nickthelegend/thenar-duck/references/18_paper_droid_with_person_scale_a.jpg

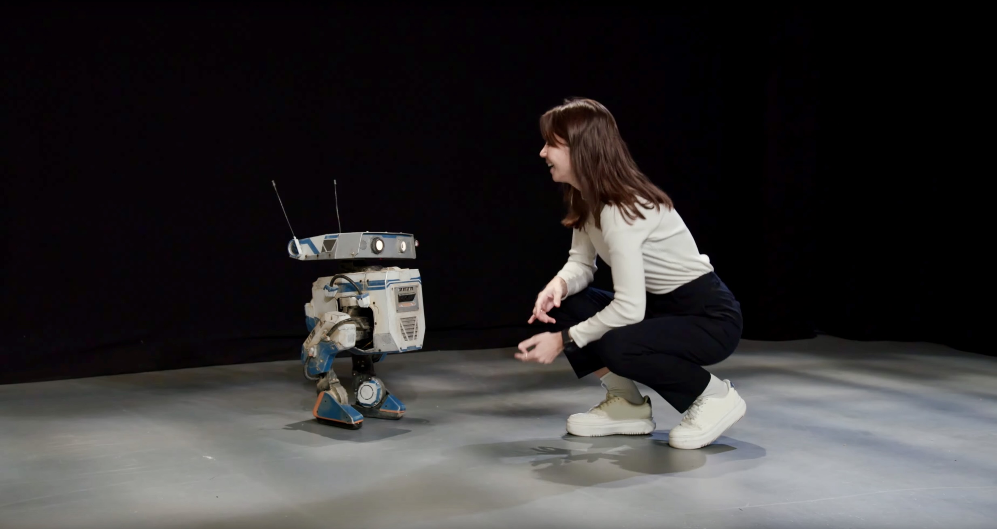
references/18_paper_droid_with_person_scale_a.jpg
