nickthelegend/thenar-duck/references/11_paper_fig2_green_droid_3quarter_photo.jpg

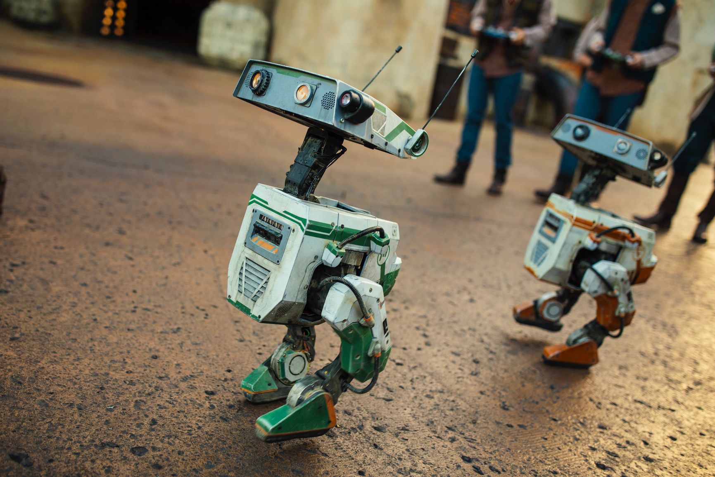
references/11_paper_fig2_green_droid_3quarter_photo.jpg
