nickthelegend/thenar-duck/cad/README.md

# Thenar Duck CAD

The current hardware-packaging revision is **[thenar_duck_B](thenar_duck_B/README.md)**.

- [Complete build guide](../README.md)
- [Colored P1S 0.4 mm Bambu Studio project](thenar_duck_B/bambu/Thenar_Duck_B_P1S_ALL_PARTS.3mf)
- [Assembly and insertion order](thenar_duck_B/ASSEMBLY.md)
- [Verification and movement restrictions](thenar_duck_B/VERIFICATION.md)
- [Hardware and custom screw/nut counts](thenar_duck_B/BOM.md)
- [Dimensional evidence](thenar_duck_B/SOURCES.md)
- [Labelled service layout](thenar_duck_B/renders/04_service_layout.png)

Revision A is preserved as the source of the retained, modified Open Duck mechanism. B replaces its enclosure and electronics packaging, corrects the battery allowance, and adds serviceable lighting and switch/fuse mounts. Use B's manifest and instructions for this build.

The model is a digital prototype based on published dimensions and stated adjustable capacities. Read the verification record before selecting parts or commanding motion; physical fitting and powered performance have not been tested.
