nickthelegend/thenar-duck/research/03_sts3215.md

# 03 — Feetech STS3215 bus servo: mechanical + electrical reference (for CAD and BOM)

Research date: 2026-09-26. Scope: the only actuator allowed in the microduck (BDX-style biped, PETG on a Bambu P1S, ≤ INR 50,000 total). Every number below carries a source URL; numbers I could not verify are marked **[unverified]** or given as my own estimate with the assumptions spelled out.

How the geometry was obtained: Waveshare publishes a DXF + PDF of the ST3215 body (Waveshare's ST3215 *is* the Feetech STS3215). I downloaded the zip, parsed the DXF `CIRCLE`/`DIMENSION` entities and rendered the PDF, and cross-checked against the outline drawing on page 6 of Feetech's own ST-3215-C001 and ST-3215-C018 datasheets.

---

## 0. TL;DR for the design team

| Item | Value | Source |
|---|---|---|
| Body (L × W × H) | 45.2 × 24.7 × 35 mm (Waveshare DXF: 45.22 × 24.72 × 35) | [Feetech C001 datasheet p.4](https://www.feetechrc.com/Data/feetechrc/upload/file/20260622/6391772523943436695270694.pdf), [Waveshare 2D drawing zip](https://files.waveshare.com/upload/0/08/ST3215-2D.zip) |
| Output-shaft axis | 10.11 mm from the gearbox end face, centred on the 24.72 width | Waveshare DXF (dimension entity `10.111704`) |
| Mounting | 8 × pilot holes Ø1.6 (mouth Ø2.0) for PA2.0 self-tapping / M2 screws, 4 on each face; 20.5 mm across; along the length at 18.41 mm from the output end on both faces, plus 2.36 mm (spline face) / 6.11 mm (idler face) from the rear end | Waveshare DXF circles; [Feetech drawing "8-PA2.0 自攻螺丝"](https://www.feetechrc.com/Data/feetechrc/upload/file/20260622/6391772523943436695270694.pdf) |
| Horn | 25T spline, OD 5.9 mm, M3×6 centre screw; Waveshare disc Ø19.2 with 4 × Ø2.5 (M3-tap) holes on a 14 mm cross (Ø14 bolt circle) | Feetech datasheet p.4; Waveshare DXF |
| Weight | 55 ± 1 g | Feetech datasheet p.4 |
| Voltage variants | C001 "7.4 V": 4–7.4 V, 19.5 kg·cm, 52 RPM, 2.5 A stall; C018 "12 V": 4–14 V, 30 kg·cm, 45 RPM, 2.7 A stall | Feetech C001 + C018 datasheets p.3 |
| Encoder / bus | 12-bit magnetic (0–4095, 0.088°), half-duplex TTL, 8N1, 38.4 k–1 Mbps (default 1 Mbps), IDs 0–253, 5264-3P connector (GND / VCC / Signal) | Feetech datasheets p.4 |
| Multi-turn | Yes: mode 3 "step" plus multi-loop ±7 turns (not retained at power-off) | Feetech datasheets p.5 |
| Indian price (in stock) | ₹1,885 ex-GST / ₹2,224.30 inc-GST (C001, Evelta, 80 in stock, ships in 24 h); ₹2,050 / ₹2,419 (C018) | [Evelta C001](https://evelta.com/sts3215-7-4v-19kg-dual-axis-ttl-string-servo-motor/), [Evelta C018](https://evelta.com/st3215-c018-12v-30kg-360deg-dual-shaft-ttl-servo-motor/) |
| 14 servos, India stock | ₹29.4 k (robu.in) – ₹31.1 k (Evelta C001) – ₹33.9 k (Evelta C018) inc-GST | computed below |
| Verdict | STS3215 everywhere is the right call: same body as STS3250/STS3235 (drop-in upgrade path), 2.3–4× stall margin on a 2 kg biped, and Open Duck Mini v2 (2.045 kg in its MuJoCo model) already walks on 14 of the 7.4 V version | §6–7 |

---

## 1. Mechanical

### 1.1 Outline (units mm)

Datasheet nominal: **45.2 × 24.7 × 35** (Feetech C001 datasheet, item 6-1, [PDF p.4](https://www.feetechrc.com/Data/feetechrc/upload/file/20260622/6391772523943436695270694.pdf)); Waveshare's CAD drawing gives **45.22 × 24.72 × 35** ([ST3215-2D.zip](https://files.waveshare.com/upload/0/08/ST3215-2D.zip), sheet titled "SCS215" — the SCS215/STS3215 share one case). The Feetech drawing (datasheet p.6) shows 45.23 × 24.73.

Height stack (Waveshare side view + Feetech front view, both p.6 / drawing):

| Feature | Value | Notes |
|---|---|---|
| Main case body (between the two flat mounting faces) | 29 | both drawings show "29" |
| + raised gear-head boss on the spline face | → 32 | Waveshare "32"; boss ≈ 3 mm high |
| + boss / rear cover on the idler face | → **35** | this is the catalogue "35" |
| Output spline protrusion above its face | 3.4 | Feetech drawing |
| Rear idler shaft protrusion below its face | 4.1 | Feetech drawing, shaft Ø6 |
| Overall spline tip → idler tip | 36.5 | Feetech drawing |
| Overall with both Waveshare aluminium discs fitted | 37.25 | Waveshare drawing |

Caveat: the two drawings don't agree exactly on how 29/32/35/36.5/37.25 nest; for the CAD reference model use the STEP file, not these numbers (see §1.6).

### 1.2 Output shaft and the raised gear-head boss

- Shaft axis is **10.11 mm from the gearbox end face** and **on the width centreline** (12.36 from each side). Waveshare DXF: dimension `10.111704` in both face views; circle centres at x = 93.796 with body edge at x = 83.684.
- The output and rear idler shafts are coaxial ("double shaft", Feetech product name "双轴"; [Feetech C001 page](https://www.feetechrc.com/74v-19-kgcm-plastic-case-metal-tooth-magnetic-code-double-axis-ttl-series-steering-gear)).
- Raised D-shaped gear-head cover around the output: DXF arcs of r = 10.80–10.89 mm centred on the shaft axis (**≈ Ø21.6–21.8 round part**), flat edge **12.5 mm behind the shaft axis** (Feetech drawing "12.5"), ≈ 3 mm high (35 − 32). A printed part that sits on the spline face needs a ≥ Ø22 pocket or must stop 12.5 mm behind the axis.
- Spline: **25T, OD 5.9 mm** (Feetech item 6-9). DXF circles at the axis: Ø6.05 and Ø6.65 (spline tip/boss) and Ø2.6 (M3 tap drill for the **M3×6 rocker screw**, Feetech item 6-13).
- Rear idler shaft: **Ø6**, held with a **PA3.0×5 self-tapping screw** (Feetech drawing callout "PA3.0X5 的自攻螺丝"); DXF shows a Ø3.2 hole at the idler axis.

### 1.3 Mounting holes (there are no side flanges/ears)

The STS3215 has **no RC-style side ears**. It mounts through **8 threaded pilot holes, 4 on the spline face ("face A") and 4 on the idler face ("face B")**, for the supplied PA2.0 self-tapping screws (Feetech drawing: "8-PA2.0 自攻螺丝"). LeRobot's SO-101 instead drives **M2×6 machine screws** into these same holes, "two from the top and two from the bottom" ([LeRobot SO-101 assembly](https://huggingface.co/docs/lerobot/en/so101)).

Coordinates from the Waveshare DXF (origin = gearbox end face × width centreline; x along the length, y across the width):

| Face | Hole pair | x from output end | y | Pilot Ø | Countersunk mouth Ø |
|---|---|---|---|---|---|
| A (spline) | near gear-head | **18.41** | **±10.25** | 1.6 | 2.0 |
| A (spline) | rear corners | **42.86** (= 2.36 from rear end) | ±10.25 | 1.6 | 2.0 |
| B (idler) | near gear-head | **18.41** | ±10.25 | 1.6 | 2.0 |
| B (idler) | rear | **39.11** (= 6.11 from rear end) | ±10.25 | 1.6 | 2.0 |

So the rectangles are **24.45 × 20.5 mm on face A** and **20.7 × 20.5 mm on face B** (DXF dimension entities `24.45`, `20.5`, `20.7`, `18.411704`, `6.111704`). The Feetech drawing independently shows the 6.11/18.41 pattern with plain holes and four cross-head case screws at the corners (Ø3.5 head recesses on face B at ≈ 3.0 mm from the output end and ≈ 2.4 mm from the rear end, 18.7 mm apart — DXF Ø3.5 circles at x = 126.984).

Interpretation caveat: the Feetech drawing labels its 6.11/18.41 view as the top view while the Waveshare DXF puts that pattern on the idler face. The DXF distinguishes the faces unambiguously (spline circles vs Ø3.2 screw hole), so I trust the DXF; **confirm on one physical unit before cutting the first mould/print**. Practical rule for CAD: the **18.41 mm pair exists on both faces** and is the safe pair; use the rear pair on whichever face you actually see the holes.

Design note for PETG: Ø1.6 pilot + PA2.0 self-tapper is Feetech's intent; for printed brackets, either drive M2×6 machine screws into the servo (SO-101 practice) or clamp the body between two printed halves and only use the horn and idler disc for load transfer (Open Duck practice — servo bodies are captured, horns bolted with M3).

### 1.4 Horn / disc options

| Option | Geometry | Source |
|---|---|---|
| Feetech stock horn | "Horn type: 25T / OD 5.9 mm", rocker screw M3×6; Evelta lists the horn material as plastic POM | Feetech datasheet items 6-9, 6-13; [Evelta](https://evelta.com/sts3215-7-4v-19kg-dual-axis-ttl-string-servo-motor/) |
| Feetech packaging photo | shows **two aluminium discs**, 8 small screws, M3 screw, 3-pin cable | Feetech C001 datasheet p.8 photo |
| Waveshare / ThinkRobotics disc | **Ø19.2 aluminium (T6061) disc**, 4 × **Ø2.5 holes (M3 tap size) on a 14 mm cross = Ø14 bolt circle**, centre M3 | Waveshare DXF (circles r = 9.6 and r = 1.25 at ±7 mm); [ThinkRobotics](https://thinkrobotics.com/products/30kg-serial-bus-servo-high-precision-and-torque-with-encoder) |
| SO-101 usage | arm links bolt to the horn with **4 × M3×6**, horn to spline with **1 × M3×6**; the idler-side horn needs no screw | [LeRobot SO-101 assembly](https://huggingface.co/docs/lerobot/en/so101) |
| Third-party brackets | RCmall aluminium U-bracket for STS3215 (Amazon), AliExpress "STS3215 Servo Bracket Metal" | [Amazon B0GVLSJ6TG](https://www.amazon.com/RCmall-Aluminum-Bracket-Feetech-Feedback/dp/B0GVLSJ6TG), [AliExpress 1005009352258061](https://www.aliexpress.com/item/1005009352258061.html) |

Whether the horn holes are tapped M3 or Ø2.5 clearance: the DXF draws Ø2.5 (M3 tap drill) and SO-101 screws M3 into them, so treat them as **M3 tapped** **[not confirmed on a physical unit]**.

### 1.5 Connector / cable exit

- Connector: **5264-3P (Molex 5264 family, 2.54 mm pitch)**, PP housing, **15 cm lead**, pins **1 GND / 2 VCC / 3 Signal-TTL** (Feetech datasheet item 6-7; Waveshare wiki "5264/2.54 3P"). Colour code on the supplied lead: black GND, red VCC, blue signal ([DFRobot](https://www.dfrobot.com/product-2961.html)).
- **Two sockets per servo** for daisy-chaining (Feetech drawing shows two "5264/2.54 3P 端子"; Waveshare wiki "two connectors per motor").
- Location: the Feetech rear-face view places the socket housings **≈ 12.5–16.5 mm behind the shaft axis** (≈ 22–26 mm from the output end) alongside a low block on the idler face that stands ≈ 1.5 mm proud between ≈ 5 and 17 mm from the rear end (Waveshare side view). The plugs come out sideways (parallel to the 24.7 mm faces). **[Exact socket position and plug clearance: verify on the STEP model / hardware — the two drawings are not explicit on this.]** Leave ≥ 10 mm side clearance for the plug + cable bend at the rear-bottom corner of each servo, or route a channel in the printed part.

### 1.6 CAD sources

- Waveshare STEP: https://files.waveshare.com/upload/5/59/ST3215-3D.zip ; 2D DXF/PDF: https://files.waveshare.com/upload/0/08/ST3215-2D.zip (linked from the [ST3215-HS wiki](https://www.waveshare.com/wiki/ST3215-HS_Servo_Motor) resources)
- GrabCAD: https://grabcad.com/library/feetech_sts3215-1 ; U-brackets: https://grabcad.com/library/u_shaped-brackets-for-feetech-sts3215-1
- step.parts: https://www.step.parts/parts/waveshare_feetech_st3215_servo
- Printables (F3Z + STEP): https://www.printables.com/model/1477431-servo-motor-sts3215-feetech-model/files
- Feetech drawings: datasheet page 6 of [C001](https://www.feetechrc.com/Data/feetechrc/upload/file/20260622/6391772523943436695270694.pdf) and [C018](https://www.feetechrc.com/Data/feetechrc/upload/file/20260622/6391772519923113075854851.pdf)

### 1.7 Materials, gears, bearings, life

| Item | STS3215 (both voltages) | Source |
|---|---|---|
| Case | PA + GF (glass-filled nylon) — some resellers wrongly say "aluminium" | Feetech datasheets item 6-3 |
| Gears | Copper (brass) per Feetech spec; Feetech C018 web page says steel; Robonine says "copper/metal" | Feetech datasheets item 6-4; [Feetech C018 page](https://www.feetechrc.com/525603); [Robonine](https://robonine.com/smart-serial-servo-motor-comparison-robotics/) |
| Gear ratio | 1/345 (C001, C018); 1/191 (C044, 27.4 kg·cm); 1/147 (C046, 14.4 kg·cm) | Feetech datasheets item 6-10; [Indystry variant table](https://indystry.cc/sts3215-best-motors-for-your-next-robot/) |
| Bearings | ball bearings on the output | Feetech item 6-5 |
| Backlash | ≤ 0.5° spec; measured ≈ 0.77–0.87° plus a 10-count dead zone | Feetech item 6-11; [Robonine test](https://robonine.com/testing-of-feetech-sts3215-servomotor-backlash-repeatability-and-torque/) |
| Repeatability (measured) | ≈ 0.17° (2 counts) | Robonine test |
| Life test | > 100,000 cycles at 1/5 stall load | Feetech item 8-1 |
| Motor | brushed "core motor" (not coreless) | Feetech item 6-14 |

---

## 2. Electrical

### 2.1 Per-variant ratings (Feetech's own datasheets)

| Parameter | STS3215 / ST-3215-C001 ("7.4 V") | ST-3215-C018 ("12 V") | ST3215-HS (Waveshare) |
|---|---|---|---|
| Input voltage range | **4–7.4 V** (over-voltage protection trips > 7.4 V, < 4 V) | **4–14 V** (protection > 14 V, < 4 V) | 6–12.6 V |
| Test voltages | 6 V / 7.4 V | 12 V | 12 V |
| Stall torque | 16.5 / **19.5 kg·cm** | **30 kg·cm** | 20 kg·cm |
| Rated (continuous) torque | 4 / **5 kg·cm** | **10 kg·cm** | not published |
| No-load speed | 0.238 / **0.192 s/60° (42 / 52 RPM)** | **0.222 s/60° (45 RPM)** | 0.094 s/60° (106 RPM) |
| No-load current | 130 / 150 mA | 180 mA | 240 mA |
| Rated current | 500 / 650 mA | 900 mA | — |
| Stall current | 2 A / **2.5 A** | **2.7 A** | 2.4 A |
| Idle (stopped) current | 6 mA | 30 mA | — |
| Motor terminal resistance | 2.5 Ω | 1.0 Ω | — |
| Kt | 8 kg·cm/A (Waveshare: 7.8) | 11 kg·cm/A | 8.3 kg·cm/A |
| Operating temp | −20…60 °C (2026 datasheet); −20…70 °C on Feetech web page | −10…60 °C | — |
| Over-temp cut-off | > 70 °C torque off | > 70 °C | — |
| Weight | 55 ± 1 g | 55 ± 1 g | 68 g (shop weight) |

Sources: [C001 datasheet](https://www.feetechrc.com/Data/feetechrc/upload/file/20260622/6391772523943436695270694.pdf) p.3–5; [C018 datasheet](https://www.feetechrc.com/Data/feetechrc/upload/file/20260622/6391772519923113075854851.pdf) p.3–5; [Waveshare ST3215 product page](https://www.waveshare.com/st3215-servo.htm) (Kt, no-load current 200 mA/150 mA for the 12 V/7.4 V models); [Waveshare ST3215-HS page](https://www.waveshare.com/st3215-hs-servo-motor.htm).

C018 performance curve (datasheet p.6, 12 V): peak output ≈ 3.4 W at ≈ 15 kg·cm / ≈ 22 RPM / ≈ 1.4 A; peak efficiency ≈ 27 % at ≈ 6 kg·cm. Useful for the actuator model in sim.

Measured (Robonine, 12 V unit): static holding ≈ 35 kg·cm on a 10 cm lever; < 1 A under 1–1.5 kg dynamic load; 48 °C steady after 10 min holding 15 kg·cm; 60 °C after 50 min and 71 °C (overheat) after ~110 min of ±90° oscillation, with **no automatic thermal cut-off observed** ([Robonine](https://robonine.com/testing-of-feetech-sts3215-servomotor-backlash-repeatability-and-torque/)). Plan for thermal headroom in the knees.

**Battery warning.** The C001's datasheet range is 4–7.4 V, yet Open Duck Mini v2 runs it straight from a 2S Li-ion pack (Molicel P30B ×2, up to 8.4 V full) ([Open Duck BOM](https://orobot.io/o/program/BROKER-2/open-duck-mini)); Waveshare lists the 7.4 V model as "4–7.4 V" and OpenElab as "4–7.4 V" ([OpenElab](https://openelab.com/products/feetech-sts3215-c001-servo-7)). The over-voltage protection thresholds live in EEPROM registers 14/15 (max/min voltage, 0.1 V units — [register reference](https://github.com/commanderfun/STS3215/blob/main/REGISTER_REFERENCE.md)), so check the shipped default on your units. Cleaner options: (a) C018 on 3S (11.1 V nominal, 12.6 V full, inside 4–14 V) — this is what Waveshare/ThinkRobotics sell as the standard "12 V" model; (b) C001 on 2S behind a 7.2 V buck (Waveshare "DC Buck Adapter 7.2V", ₹334 ex-GST at [ElectronicsComp](https://www.electronicscomp.com/waveshare-serial-bus-servo-dc-buck-adapter-mini-module-design-for-serial-bus-servos-easy-to-use-72v-buck-regulator), current rating not published — **unverified for 14 servos**).

### 2.2 Encoder, resolution, feedback

- 12-bit magnetic angle sensor, 360° absolute, no mechanical limit, resolution 0.088° (360/4096), neutral 180° = 2048 (Feetech items 6-6, 7-6…7-8).
- Feedback fields: position, speed, load, input voltage, current, temperature (item 7-10). Present current register scale = 6.5 mA/LSB ([register reference](https://github.com/commanderfun/STS3215/blob/main/REGISTER_REFERENCE.md)).
- Max position update rate **1 ms** (item 11 "Max Position Update Rate 1ms").

### 2.3 Protocol, bus, connector, pinout

- **Half-duplex asynchronous TTL serial, 8 data bits, 1 stop, no parity**, "digital packet" commands (Feetech items 7-1/7-2). Same framing as Dynamixel Protocol 1.0 (0xFF 0xFF header, ID, length, instruction, params, checksum); STS/SMS send **low byte first** (Feetech FAQ item 11: "SCS series high byte first, SMS low byte first"; Waveshare demo `protocol_end = 0` for ST) — [Feetech start tutorial PDF](https://www.feetechrc.com/Data/feetechrc/upload/file/20201127/start%20%20tutorial201015.pdf), [Waveshare user manual](https://files.waveshare.com/upload/f/f4/ST3215_Servo_User_Manual.pdf) p.25. Full spec: [Communication Protocol User Manual (191218)](https://files.waveshare.com/upload/2/27/Communication_Protocol_User_Manual-EN%28191218-0923%29.pdf).
- Signal levels: high 2–5 V, low 0–0.45 V (Feetech item 11) → 3.3 V hosts are fine.
- Baud: 38,400 – 1,000,000 bps, factory 1 Mbps (item 7-4). Baud register codes 0…7 = 1 M, 500 k, 250 k, 128 k, 115200, 76800, 57600, 38400 ([Feetech tutorial p.4](https://www.feetechrc.com/Data/feetechrc/upload/file/20201127/start%20%20tutorial201015.pdf)). (LeRobot's table lists 19200 instead of 76800 for the last code — [tables.py](https://github.com/huggingface/lerobot/blob/main/src/lerobot/motors/feetech/tables.py); trust Feetech.)
- IDs 0–253 (254 = broadcast); Waveshare: "up to 253 servos in series (with sufficient power)" ([Waveshare wiki](https://www.waveshare.com/wiki/ST3215_Servo)). Practical chains: 6 per adapter in SO-101, 14 in Open Duck Mini v2.
- Connector **5264-3P**, pin 1 GND, 2 VCC, 3 Signal (item 6-7). Two sockets per servo, wired in parallel internally → straight daisy chain, no termination.
- Bus throughput (my estimate, 1 Mbps ≈ 100 kB/s): one sync-write of position+time+speed for 14 servos ≈ 106 bytes ≈ 1.1 ms; 14 individual position/speed/load reads ≈ 20–25 bytes each incl. response ≈ 0.25–0.4 ms each with servo latency → ≈ 5–8 ms → a 50–100 Hz control loop is comfortable on one chain.

### 2.4 Key registers (torque limit, angle limits, mode)

Official tables: [Waveshare ST3215 memory register map (XLS)](https://files.waveshare.com/upload/2/27/ST3215%20memory%20register%20map-EN.xls) and the SMS/STS 1.0 memory table referenced in the [Feetech tutorial](https://www.feetechrc.com/Data/feetechrc/upload/file/20201127/start%20%20tutorial201015.pdf). Community transcription used below: [commanderfun REGISTER_REFERENCE.md](https://github.com/commanderfun/STS3215/blob/main/REGISTER_REFERENCE.md), cross-checked with [LeRobot tables.py](https://github.com/huggingface/lerobot/blob/main/src/lerobot/motors/feetech/tables.py).

| Addr | Name | Mem | Default | Notes |
|---|---|---|---|---|
| 5 | ID | EEPROM | 1 | 0–253 |
| 6 | Baud code | EEPROM | 0 (1 Mbps) | codes above |
| 9 / 11 | Min / Max angle limit | EEPROM | 0 / 4095 | set both 0 for wheel/step modes |
| 13 | Max temperature | EEPROM | 70 °C | |
| 14 / 15 | Max / Min voltage | EEPROM | 140 / 50 (×0.1 V) | check on 7.4 V units |
| 16 | **Max torque limit** | EEPROM | 1000 (=100 %) | copied to 48 at power-up |
| 21 / 22 / 23 | P / D / I | EEPROM | — | PID exposed (Feetech item 7-5) |
| 33 | **Operating mode** | EEPROM | 0 | 0 position, 1 closed-loop speed, 2 open-loop PWM, 3 step (multi-turn) |
| 34–39 | overload protection torque / time / threshold | EEPROM | — | Feetech FAQ items 1–2 |
| 40 | Torque enable | RAM | 0 | writing **128** = "set current position as centre" one-key calibration (Feetech item 7-14) |
| 41 | Acceleration | RAM | 0 | 0 = instant |
| 42 | Goal position | RAM | — | 0–4095 (step mode: signed, relative) |
| 46 | Goal speed | RAM | 0 = max | steps/s; STS3215 max ≈ 3400 steps/s ([sts_hardware_interface](https://github.com/adityakamath/sts_hardware_interface)) |
| 48 | **Torque limit (runtime)** | RAM | 1000 | 0–1000 = 0–100 % of stall |
| 56 / 58 / 60 | Present position / speed / load | RAM | — | load bit 10 = direction |
| 62 / 63 / 69 | Voltage (×0.1 V) / temperature (°C) / current (×6.5 mA) | RAM | — | |

Protections (Feetech item 7-11): overload = > 80 % of stall for 2 s → protect (flag cleared by the next position command; percentage and time configurable); over-current = > 2 A for 2 s → output off; over-voltage/under-voltage per registers 14/15; over-temperature > 70 °C → torque off.

### 2.5 360° / multi-turn

Yes. Feetech item 7-12/7-13: mode 3 = step mode (relative moves from the current position; set angle limits to 0 first — [Feetech FAQ item 13](https://www.feetechrc.com/Data/feetechrc/upload/file/20201127/start%20%20tutorial201015.pdf)); **multi-loop mode gives ±7 turns of absolute position at full resolution, turn count not retained at power-off, doubling turns when resolution is halved** (address 30 "angle resolution", Feetech tutorial p.5). Not needed for a leg joint, but handy for a neck/antenna or a winch.

---

## 3. Driver / interface options

| Board | What it is | Electrical | Host interface | Price |
|---|---|---|---|---|
| **Waveshare Bus Servo Adapter (A)** (a.k.a. "Serial Bus Servo Driver Board", the LeRobot "MotorBus") | CH343P USB-UART + SN74LVC1G126/1G125 tri-state buffers + MMBT3906 auto-direction, DATA pulled up 10 k to 3.3 V, AO4407 P-FET reverse-polarity + SMAJ15CA TVS on the servo rail, 5 V buck → AMS1117-3.3 | input 9–12.6 V (DC 5.5×2.1 or KF350 screw terminal); **servo power path marked "MAX: 6 A"** on the schematic | USB-C (jumpers "B") or 3-pin UART header (jumpers "A"; wire **RX↔RX, TX↔TX** because the header is labelled from the servo side) | $4.99 ([Waveshare](https://www.waveshare.com/bus-servo-adapter-a.htm)); India: ₹789 in stock ([REES52](https://rees52.com/products/waveshare-serial-bus-servo-driver-board-all-in-one-servo-driver-board-with-integrated-power-control-for-st-sc-actuators-rs8478)), ₹474 sold-out ([Robocraze](https://robocraze.com/products/waveshare-serial-bus-servo-control-board-for-st-sc-series-servos)), listed at [robu.in](https://robu.in/product/waveshare-serial-bus-servo-driver-board-integrates-servo-power-supply-and-control-circuit-applicable-for-st-sc-series-serial-bus-servos/) and [Amazon.in B0CJ6TP3TP](https://www.amazon.in/Waveshare-Integrates-Control-Applicable-Integrate/dp/B0CJ6TP3TP) (prices not retrievable, 503) |
| **SmartElex Bus Servo Adapter** (robu.in house brand, functional clone) | same feature set: 9–12.6 V, UART/USB jumper A/B, 42×33 mm, Ø2.5 holes, 253 servos | | UART or USB | ₹452 sale / ₹604 ([Robocraze](https://robocraze.com/products/smartelex-serial-bus-servo-driver-board-integrates-servo-power-supply-and-control-circuit)); [robu.in listing](https://robu.in/product/smartelex-serial-bus-servo-driver-board/); [datasheet PDF](https://robu.in/wp-content/uploads/2025/07/Bus_Servo_Adapter-2.pdf) |
| **Waveshare Servo Driver with ESP32** | ESP32-WROOM-32, OLED, WiFi/BT/ESP-NOW, web UI on 192.168.4.1; servo UART on GPIO18 RX / GPIO19 TX at 1 Mbps; USB-C serial forwarding at 115200 | DC 6–12 V, 65×30 mm, holes 23×58 | web app, USB serial passthrough, ESP-NOW | $15.99 ([Waveshare](https://www.waveshare.com/servo-driver-with-esp32.htm)); **₹1,250 ex / ₹1,475 inc GST, 9 in stock** ([Evelta](https://evelta.com/esp32-servo-driver-expansion-board/)) |
| **Waveshare Bus Servo Driver HAT (A)** | ESP32-WROOM-32 HAT for Raspberry Pi; TTL + RS485 ports; 5 V buck can power the Pi | 9–25 V in, 65×57 mm | Pi GPIO UART or USB-C | $17.97–18.99 ([Waveshare](https://www.waveshare.com/bus-servo-driver-hat-a.htm)); no Indian listing found |
| **Feetech FE-URT-1 / FE-URT-2** | USB (CH340 per Feetech tutorial) → TTL (port B, SCS/STS) and RS485 (port A, SMS); 50 bps–1 Mbps; 5 V / 3.3 V levels; **signal only, servo power must be supplied separately** | | USB or TTL header to an MCU (TX-TX, RX-RX, 5V, GND) | $10 ([Seeed](https://www.seeedstudio.com/Feetech-FE-URT-1-p-6705.html)); FE-URT-2 ₹1,137.46, 5 in stock ([Evelta Feetech list](https://evelta.com/feetech/)) |

Where the electronics are described: [Bus Servo Adapter (A) wiki](https://www.waveshare.com/wiki/Bus_Servo_Adapter_(A)) and [schematic PDF](https://files.waveshare.com/wiki/Bus-Servo-Adapter-(A)/Bus%20Servo%20Adapter%20(A)-Sch.pdf); [Servo Driver with ESP32 wiki](https://www.waveshare.com/wiki/Servo_Driver_with_ESP32); [Bus Servo Driver HAT (A) wiki](https://www.waveshare.com/wiki/Bus_Servo_Driver_HAT_(A)); FE-URT-1 description on [RobotShop search summary / Feetech tutorial](https://www.feetechrc.com/Data/feetechrc/upload/file/20201127/start%20%20tutorial201015.pdf).

**Can a Raspberry Pi UART drive them directly?** Yes, with a tri-state buffer. Feetech's own reference circuit (datasheet p.8 "接口定义") is: SN74LVC1G126 from host TXD to the DATA line with OE = TXEN; SN74LVC1G125 from DATA to host RXD with /OE = TXEN; a PNP transistor (10 k base, 20 k pull-down) derives TXEN from TXD so no GPIO direction control is needed; VCC = the host's logic level (3.3 V is fine, signal high spec 2–5 V). The Waveshare adapter is exactly this circuit plus a CH343P, so the cheapest robust route is the ₹450–800 adapter in UART mode wired to the Pi's GPIO14/15 UART ([pinout.xyz](https://pinout.xyz/pinout/uart)). Alternatives seen in the wild: STM32 single-wire half-duplex mode with a 500–1000 Ω pull-up ([viteo STM32 port](https://github.com/viteo/STM32-BluePill-SCServo-library)); RP2040 + Waveshare Pico driver board ([kevinmcaleer/sts3215](https://github.com/kevinmcaleer/sts3215)). Open Duck Mini v2 itself uses the Waveshare adapter **over USB** on the Pi Zero 2W with the FTDI/CH34x latency timer tuned ([Open Duck Mini Runtime, DeepWiki](https://deepwiki.com/apirrone/Open_Duck_Mini_Runtime)).

**Power note for 14 servos:** the adapter's servo rail is marked 6 A max (schematic). 14 × 150 mA no-load = 2.1 A idle; stall on two knees alone = 5 A. Feed the servo chain(s) from the battery with your own XT30 harness (Open Duck BOM uses XT30) and pass only DATA/GND through the adapter, or split into two chains each under 6 A.

### 3.1 Software

Python:
- `pip install feetech-servo-sdk` → `import scservo_sdk` (PortHandler, sms_sts, WritePosEx/ReadPos; mirror of Feetech's gitee `ftservo/SCServoSDK`) — [PyPI](https://pypi.org/project/feetech-servo-sdk/), [gitee original](https://gitee.com/ftservo/SCServoSDK)
- `ftservo-python-sdk` (official source, `scscl` + `sms_sts` examples) — [PyPI](https://pypi.org/project/ftservo-python-sdk/)
- Waveshare `STServo_Python.zip` (pyserial only) — [download](https://files.waveshare.com/wiki/Bus_Servo_Adapter_A/STServo_Python.zip)
- `vassar-feetech-servo-sdk` (beginner wrapper, bundles scservo_sdk) — [PyPI](https://pypi.org/project/vassar-feetech-servo-sdk/); `feetech-cli` (inspect/configure) — [PyPI](https://pypi.org/project/feetech-cli/0.1.0/); `python-st3215` — [GitHub](https://github.com/Mickael-Roger/python-st3215)
- **LeRobot**: `pip install "lerobot[feetech]"`, class `lerobot.motors.feetech.FeetechMotorsBus` (default 1 Mbps, 1000 ms timeout, protocol 0 for STS with sync read/write, homing-offset calibration; model table has `sts3215`, `sts3250`, `sm8512bl`, `scs0009`; `lerobot-find-port`, `lerobot-setup-motors`, `lerobot-calibrate`) — [feetech.py](https://github.com/huggingface/lerobot/blob/main/src/lerobot/motors/feetech/feetech.py), [tables.py](https://github.com/huggingface/lerobot/blob/main/src/lerobot/motors/feetech/tables.py), [SO-101 docs](https://huggingface.co/docs/lerobot/en/so101)
- Tutorial + register map: [commanderfun/STS3215](https://github.com/commanderfun/STS3215)

Rust / MCU: `rustypot` (what Open Duck Mini Runtime uses on the Pi Zero 2W) — [DeepWiki](https://deepwiki.com/apirrone/Open_Duck_Mini_Runtime); Arduino `SCServo` library from Waveshare ([wiki](https://www.waveshare.com/wiki/Bus_Servo_Adapter_(A))) and [DeltaEngine/FeetechStsServos](https://github.com/DeltaEngine/FeetechStsServos); [esphome-sts3215](https://github.com/DexiTheOne/esphome-sts3215); [MicroPython for RP2040](https://github.com/kevinmcaleer/sts3215).

ROS 2:
- [adityakamath/sts_hardware_interface](https://github.com/adityakamath/sts_hardware_interface) — ros2_control SystemInterface, CI on Jazzy + Kilted, position / velocity / PWM-effort command modes, 7 state interfaces (position, velocity, effort, voltage, temperature, current, is_moving), vendored SCServo_Linux, notes STS3215/3235 max 3400 steps/s.
- [JafarAbdi/feetech_ros2_driver](https://github.com/JafarAbdi/feetech_ros2_driver) (also [ros-physical-ai fork](https://github.com/ros-physical-ai/feetech_ros2_driver); indexed at [index.ros.org](https://index.ros.org/p/feetech_ros2_driver/)) — ros2_control hardware interface.
- [Ar-Ray-code/feetech_scs_ros2_driver](https://github.com/Ar-Ray-code/feetech_scs_ros2_driver); [adityakamath/pan_tilt_ros](https://github.com/adityakamath/pan_tilt_ros) (no ros2_control); [botamochi6277/Feetech-microros](https://github.com/botamochi6277/Feetech-microros) (XIAO + FE-URT-1).

Simulation actuator model: BAM (Rhoban) ships an identified `feetech_sts3215_7_4V` model with a MuJoCo exporter ([BAM actuators list](https://bam.readthedocs.io/en/latest/usage/actuators.html), [repo](https://github.com/Rhoban/bam)); Open Duck Mini v2's MJCF uses actuator class `sts3215` with kp = 13.37, kv = 0, forcerange ±3.23 (units as in the XML; that would be 33 kg·cm, above the 7.4 V stall — **[verify against the BAM parameters before trusting it]**) — [open_duck_mini_v2.xml](https://raw.githubusercontent.com/apirrone/Open_Duck_Playground/main/playground/open_duck_mini_v2/xmls/open_duck_mini_v2.xml), [sim2real.md](https://github.com/apirrone/Open_Duck_Mini/blob/v2/docs/sim2real.md).

---

## 4. Prices (INR) and sourcing for 14–16 servos

Fetched 2026-09-26. FX for USD lines: **1 USD = ₹95.92** ([open.er-api.com, 26 Sep 2026](https://open.er-api.com/v6/latest/USD)).

### 4.1 Indian vendors

| Vendor / SKU | Price | Stock / lead time | Source |
|---|---|---|---|
| Evelta — STS3215 7.4 V (C001) | **₹1,885 ex-GST / ₹2,224.30 inc** | 80 in stock, "shipped in 24 h from Mumbai" | [evelta.com](https://evelta.com/sts3215-7-4v-19kg-dual-axis-ttl-string-servo-motor/) |
| Evelta — ST3215-C018 12 V | **₹2,050 ex / ₹2,419 inc** | 67 in stock, 24 h | [evelta.com](https://evelta.com/st3215-c018-12v-30kg-360deg-dual-shaft-ttl-servo-motor/) |
| Evelta — STS3215-C046 (1:147, 14 kg·cm) | ₹1,885 ex | 60 in stock | [Evelta Feetech list](https://evelta.com/feetech/) |
| Evelta — STS3032 | ₹2,925.13 ex / ₹3,451.65 inc | product page "out of stock", category page "15 in stock" (inconsistent) | [evelta.com](https://evelta.com/sts3032-6v-4-5kg-360deg-serial-bus-servo-motor/) |
| Evelta — ST-3250-C002 (50 kg·cm) | ₹5,154.42 ex | 5 in stock | [Evelta Feetech list](https://evelta.com/feetech/) |
| Evelta — STS3035 (12 V 35 kg·cm) / STS3020 (7.4 V 20 kg·cm) | ₹2,072.85 / ₹2,056.55 ex | 5 each | same |
| robu.in — Waveshare ST3215 (30 kg·cm) | **₹2,097 inc-GST** (search snippet; page returns 403 to fetch) | unknown | [robu.in](https://robu.in/product/waveshare-st3215-serial-bus-servo/) |
| ThinkRobotics — Waveshare ST3215 (12 V or 7.4 V option) | ₹2,649.99 (was ₹2,999.99) | "available in 2–4 weeks" | [thinkrobotics.com](https://thinkrobotics.com/products/30kg-serial-bus-servo-high-precision-and-torque-with-encoder) |
| ThinkRobotics — ST3215-HS | ₹2,699.99 (was ₹2,999.99) | 2–4 weeks | [thinkrobotics.com](https://thinkrobotics.com/products/st3215-hs) |
| Amazon.in — DIYmall STS3215 7.4 V (B0FGNZYNKC, B0FGNG181T w/ bracket), Rcmall 6-pack 12 V (B0FLPQQ4FR), Waveshare (B0B6P9271Q) | listings exist; **prices not retrievable (HTTP 503 on four attempts)** | | [B0FGNZYNKC](https://www.amazon.in/DIYmall-STS3215-Magnetic-Encoder-Arduino/dp/B0FGNZYNKC), [B0FLPQQ4FR](https://www.amazon.in/Robotics-Magnetic-Precision-Educational-Projects/dp/B0FLPQQ4FR) |
| electronicscomp.com | **no STS3215/ST3215 listing** ("no product matches") | | [search](https://www.electronicscomp.com/index.php?route=product/search&search=ST3215) |
| roboelements | domain did not resolve (ENOTFOUND) at research time | | — |

### 4.2 Overseas list prices (for the import comparison)

| Seller | Price | Source |
|---|---|---|
| Feetech official "overseas price" (2020) | $15 | [feetechrc.com](https://www.feetechrc.com/2020-05-13_56655.html) |
| Alibaba (Feetech STS3215 C001, MOQ tiers) | from $13.89 | [alibaba.com](https://www.alibaba.com/product-detail/Top-Seller-Low-Cost-Feetech-STS3215_1600999461525.html) (search snippet; page blocks fetch) |
| AliExpress 6-pack | $134.80 (= $22.47 ea) | [aliexpress.us 3256809204674483](https://www.aliexpress.us/item/3256809204674483.html) (snippet) |
| Waveshare direct | $16.99–21.99 | [waveshare.com](https://www.waveshare.com/st3215-servo.htm) |
| DFRobot | $17.90 (7.4 V), $19.90 (12 V) | [2961](https://www.dfrobot.com/product-2961.html), [2962](https://www.dfrobot.com/product-2962.html) |
| Seeed | $20 ($19 at 10+) | [seeedstudio.com](https://www.seeedstudio.com/STS3215-19kg-cm-7-4V-Serial-Servo-p-6338.html) |
| OpenElab | $23.99 | [openelab.com](https://openelab.com/products/feetech-sts3215-c001-servo-7) |
| Open Duck Mini v2 BOM | $23 each × 14 = $318 | [orobot.io BOM mirror](https://orobot.io/o/program/BROKER-2/open-duck-mini) |

### 4.3 Import duty to India (courier / e-commerce parcel)

Stack, per [taxgst.in](https://taxgst.in/import-duty-calculator-india/): assessable value (CIF) → BCD → **SWS = 10 % of BCD** → **IGST 18 %** on (CIF + BCD + SWS). BCD for small DC motors (HS 8501.10.19) is quoted as **15 %** by [EximPe](https://eximpe.com/hsn/electric-motor-hsn-code) (their indicative total incl. an AIDC line: ₹40.39 per ₹100 CIF) and as "10–15 % for 85xx electronics" by [Alibaba's India shipping guide](https://electronics.alibaba.com/question/aliexpress-in-india-shipping,-safety-workarounds-(2025)). Arithmetic: BCD 10 % → total 31.0 % of CIF; BCD 15 % → 37.5 %; with the AIDC line EximPe shows → 40.4 %. **Budget 31–41 % of CIF plus the courier's clearance fee [fee amount unverified].** Practical constraints: the AliExpress app is delisted in India (site still usable), delivery 14–60 days, and 68–94 % customs-clearance rates depending on channel (same Alibaba guide).

### 4.4 Landed cost per servo, import vs domestic (my arithmetic)

| Route | Unit | + shipping share (assume ₹200) | Duty 31–41 % | **Landed** |
|---|---|---|---|---|
| Alibaba wholesale $13.89 | ₹1,332 | ₹1,532 | ₹475–628 | **₹2,007–2,160** |
| AliExpress 6-pack $22.47 | ₹2,155 | ₹2,355 | ₹730–966 | **₹3,085–3,321** |
| Evelta C001 (GST paid, 24 h) | — | — | — | **₹2,224** |
| robu.in Waveshare ST3215 | — | — | — | **₹2,097** |

Conclusion: importing only wins at true wholesale (~$14) and only by ~₹100–200 per servo, while costing 3–8 weeks and customs risk. **Buy Indian stock.**

### 4.5 Servo budget for the microduck

| Quantity | Evelta C001 (₹2,224.30) | Evelta C018 12 V (₹2,419) | robu.in ST3215 (₹2,097) | ThinkRobotics (₹2,649.99) |
|---|---|---|---|---|
| 14 (Open Duck Mini v2 count) | **₹31,140** | ₹33,866 | ₹29,358 | ₹37,100 |
| 16 (+2 spare / extra DOF) | ₹35,589 | ₹38,704 | ₹33,552 | ₹42,400 |

Add: adapter ₹450–800, Waveshare/Feetech horn screws included, 3-pin leads included (15 cm each — long leg runs need longer 5264 leads). That leaves roughly ₹12–19 k of the ₹50 k for Pi Zero 2W, IMU (BNO055 in Open Duck), 2S/3S pack + BMS + charger, PETG and hardware — tight but feasible at the 14-servo count.

---

## 5. Comparison: STS3215 vs STS3250 vs STS3032 vs ST3215-HS (and STS3235)

| | **STS3215 C001 (7.4 V)** | **STS3215 C018 (12 V)** | **STS3250 (ST-3250-C001)** | **STS3032** | **ST3215-HS** | STS3235 |
|---|---|---|---|---|---|---|
| Body | 45.2 × 24.7 × 35, PA+GF | same | **45.22 × 24.72 × 35, aluminium** (drop-in) | 23.2 × 12.1 × 28.5, aluminium | 45.22 × 35 × 24.72 | 45.22 body, aluminium |
| Weight | 55 g | 55 g | 74.5 g | 20 g | 68 g (shop weight) | 70.5 g |
| Voltage | 4–7.4 V | 4–14 V | 6–12 V (rated 12) | 4.8–6 V | 6–12.6 V | 12 V |
| Stall torque | 19.5 kg·cm | 30 | **50** | 4.5 | 20 | 30 |
| Rated torque | 5 | 10 | 16 | 1.5 | n/p | 10 |
| No-load speed | 52 RPM (0.192 s/60°) | 45 RPM (0.222) | 75 RPM (0.133) | 111 RPM (0.09) | **106 RPM (0.094)** | 45 RPM |
| Stall current | 2.5 A | 2.7 A | 4.2 A | 1.2 A | 2.4 A | 2.7 A |
| No-load current | 150 mA | 180 mA | 280 mA | 150 mA | 240 mA | — |
| Gears | copper | copper/steel | steel | metal | metal | steel |
| Motor | brushed core | brushed core | coreless | coreless | — | — |
| Gear ratio | 1/345 | 1/345 | n/p | n/p | n/p | n/p |
| Backlash measured (Robonine, 50 % load) | 0.77° (12 V unit) | 0.77° | 0.28° | — | — | 0.44° |
| Temp rise @50 % load (Robonine) | +10 °C | +10 °C | +25 °C | — | — | +5 °C |
| Price, India | ₹2,224 inc (Evelta) | ₹2,419 inc (Evelta) | ₹5,154 ex (Evelta, C002) ≈ ₹6,082 inc | ₹3,452 inc (Evelta) | ₹2,700 (ThinkRobotics) | robu.in listing, price not captured |
| Price, overseas | $15–24 | $17–22 | $64.99 (Babsco) | — | $21.99 (Waveshare) | — |
| 14 × India price | ₹31.1 k | ₹33.9 k | ≈ ₹85 k | ≈ ₹48 k | ≈ ₹37.8 k | — |

Sources: STS3215 — Feetech datasheets (§2); STS3250 — [Feetech ST-3250-C001 page](https://www.feetechrc.com/562636), [Babsco](https://shop.babsco.com/feetech-sts3250-50kg-heavy-duty-smart-servo); STS3032 — [Evelta](https://evelta.com/sts3032-6v-4-5kg-360deg-serial-bus-servo-motor/), [Feetech STS3032 page](https://www.feetechrc.com/568388.html); ST3215-HS — [Waveshare](https://www.waveshare.com/st3215-hs-servo-motor.htm), [ThinkRobotics](https://thinkrobotics.com/products/st3215-hs); STS3235 and measured columns — [Robonine comparison](https://robonine.com/smart-serial-servo-motor-comparison-robotics/). "n/p" = not published.

### 5.1 Torque margin for a ~1.5–2 kg biped (my estimate; assumptions explicit)

Reference mass: Open Duck Mini v2's MJCF sums to **2.045 kg** (trunk 0.699, head 0.407, each leg ≈ 0.41) and it walks on **14 × STS3215 7.4 V** ([open_duck_mini_v2.xml](https://raw.githubusercontent.com/apirrone/Open_Duck_Playground/main/playground/open_duck_mini_v2/xmls/open_duck_mini_v2.xml), [BOM](https://orobot.io/o/program/BROKER-2/open-duck-mini)). Weight W = 2.045 × 9.81 = 20.1 N. Static single-support worst cases (1 kg·cm = 0.0981 N·m):

| Joint | Assumed lever arm (CoM offset from joint axis) | Static torque | vs C001 stall 19.5 / rated 5 | vs C018 stall 30 / rated 10 |
|---|---|---|---|---|
| Ankle pitch (CoM at toe edge) | 40 mm | 0.80 N·m = 8.2 kg·cm | 2.4× / 0.61× | 3.7× / 1.2× |
| Knee (30–40° bend) | 35 mm | 0.70 N·m = 7.2 kg·cm | 2.7× / 0.70× | 4.2× / 1.4× |
| Hip roll (lateral sway) | 45 mm | 0.90 N·m = 9.2 kg·cm | 2.1× / 0.54× | 3.3× / 1.1× |

Reading: the 7.4 V unit has 2–2.7× stall margin (adequate, proven by Open Duck) but runs at 1.6–1.8× its **continuous** rating in the worst pose, which is why leg servos get warm; the 12 V C018 on 3S restores ≥ 1.1× continuous margin at identical size, weight and price (+₹195 each). STS3250 would give 5–6× stall margin but costs 2.7× and adds 20 g per joint (0.27 kg over 14 joints) — unnecessary for a 2 kg robot. STS3032 (4.5 kg·cm stall, 1.5 rated) is only viable for the head/neck/antenna joints, and it is *more* expensive in India than the STS3215. ST3215-HS trades 33 % torque for 2.4× speed; at Open Duck scale the 45–52 RPM (270–312 °/s no-load) of the STS3215 is proven sufficient, so HS is optional for a faster gait later. **Decision: STS3215 everywhere; choose C018 @ 3S unless you want to reuse the Open Duck electronics verbatim (C001 @ 2S).**

---

## 6. CAD/BOM checklist derived from this research

1. Model the servo from the Waveshare STEP; use the DXF numbers here only for sanity checks.
2. Mount = capture the body between printed halves; bolt loads through the horn (4 × M3 on Ø14 cross + M3×6 centre) and the idler disc; M2×6 into the 18.41 mm hole pair on each face as anti-rotation.
3. Reserve Ø22 × 3 mm for the gear-head boss, 3.4 mm spline stand-off, 4.1 mm idler stand-off, and ≥ 10 mm sideways at the rear-bottom corner for the 5264 plugs.
4. Two power chains ≤ 6 A each if the Waveshare adapter carries servo power; otherwise power via XT30 harness.
5. Set register 16/48 (torque limit) and 34–39 (overload) per joint; set 14/15 to the pack's real min/max before the first walk.
6. Order 14 + 2 spares from Evelta (24 h) and one SmartElex/Waveshare adapter from robu/Robocraze/REES52.

---

## 7. Open questions (could not be verified online)

- Exact socket/plug location on the body (side faces vs idler face) — measure a unit or inspect the STEP.
- Whether the aluminium disc's four holes are M3-tapped or Ø2.5 clearance (DXF suggests tap-drill size; SO-101 screws M3 into them).
- Face-A rear hole pair at 2.36 mm from the rear end: usable for mounting or just the case-screw posts?
- Shipped default of the max-voltage register on 7.4 V units (2S full charge = 8.4 V > 7.4 V spec).
- ST3215-HS gear ratio and its true weight (68 g is the shop listing weight).
- Amazon.in and robu.in live prices (503/403 during research); ThinkRobotics 2–4-week lead time vs Evelta 24 h.
- Exact BCD rate for HS 8501.10.19 today (10 % vs 15 %) and whether AIDC applies; courier clearance fee.
- BAM's identified STS3215 7.4 V parameters (kp, friction, armature) — fetch from the BAM GitHub params folder before building the MuJoCo/Isaac actuator model.

---

## 8. All sources

Feetech: [C001 product page](https://www.feetechrc.com/74v-19-kgcm-plastic-case-metal-tooth-magnetic-code-double-axis-ttl-series-steering-gear) · [C001 datasheet PDF](https://www.feetechrc.com/Data/feetechrc/upload/file/20260622/6391772523943436695270694.pdf) · [2020 STS3215 spec PDF](https://www.feetechrc.com/Data/feetechrc/upload/file/20200611/6372749961523760249976542.pdf) · [C018 product page](https://www.feetechrc.com/525603) · [C018 datasheet PDF](https://www.feetechrc.com/Data/feetechrc/upload/file/20260622/6391772519923113075854851.pdf) · [STS3215 variants search](https://www.feetechrc.com/products.html?keyword=STS3215) · [2020 launch page](https://www.feetechrc.com/2020-05-13_56655.html) · [STS3250 page](https://www.feetechrc.com/562636) · [STS3032 page](https://www.feetechrc.com/568388.html) · [Start tutorial / FAQ PDF](https://www.feetechrc.com/Data/feetechrc/upload/file/20201127/start%20%20tutorial201015.pdf)

Waveshare: [ST3215 wiki](https://www.waveshare.com/wiki/ST3215_Servo) · [ST3215 product](https://www.waveshare.com/st3215-servo.htm) · [2D drawing zip](https://files.waveshare.com/upload/0/08/ST3215-2D.zip) · [3D STEP zip](https://files.waveshare.com/upload/5/59/ST3215-3D.zip) · [register map XLS](https://files.waveshare.com/upload/2/27/ST3215%20memory%20register%20map-EN.xls) · [protocol manual](https://files.waveshare.com/upload/2/27/Communication_Protocol_User_Manual-EN%28191218-0923%29.pdf) · [ST3215 user manual](https://files.waveshare.com/upload/f/f4/ST3215_Servo_User_Manual.pdf) · [ST3215-HS wiki](https://www.waveshare.com/wiki/ST3215-HS_Servo_Motor) · [ST3215-HS product](https://www.waveshare.com/st3215-hs-servo-motor.htm) · [Bus Servo Adapter (A) wiki](https://www.waveshare.com/wiki/Bus_Servo_Adapter_(A)) · [adapter product](https://www.waveshare.com/bus-servo-adapter-a.htm) · [adapter schematic](https://files.waveshare.com/wiki/Bus-Servo-Adapter-(A)/Bus%20Servo%20Adapter%20(A)-Sch.pdf) · [Servo Driver with ESP32 wiki](https://www.waveshare.com/wiki/Servo_Driver_with_ESP32) · [ESP32 driver product](https://www.waveshare.com/servo-driver-with-esp32.htm) · [Bus Servo Driver HAT (A) wiki](https://www.waveshare.com/wiki/Bus_Servo_Driver_HAT_(A))

Tests / comparisons: [Robonine 5-servo comparison](https://robonine.com/smart-serial-servo-motor-comparison-robotics/) · [Robonine STS3215 test](https://robonine.com/testing-of-feetech-sts3215-servomotor-backlash-repeatability-and-torque/) · [Indystry STS3215 variants](https://indystry.cc/sts3215-best-motors-for-your-next-robot/)

India vendors: [Evelta STS3215](https://evelta.com/sts3215-7-4v-19kg-dual-axis-ttl-string-servo-motor/) · [Evelta C018](https://evelta.com/st3215-c018-12v-30kg-360deg-dual-shaft-ttl-servo-motor/) · [Evelta STS3032](https://evelta.com/sts3032-6v-4-5kg-360deg-serial-bus-servo-motor/) · [Evelta Feetech list](https://evelta.com/feetech/) · [Evelta ESP32 driver](https://evelta.com/esp32-servo-driver-expansion-board/) · [robu.in ST3215](https://robu.in/product/waveshare-st3215-serial-bus-servo/) · [robu.in Waveshare adapter](https://robu.in/product/waveshare-serial-bus-servo-driver-board-integrates-servo-power-supply-and-control-circuit-applicable-for-st-sc-series-serial-bus-servos/) · [robu.in SmartElex adapter](https://robu.in/product/smartelex-serial-bus-servo-driver-board/) · [SmartElex adapter PDF](https://robu.in/wp-content/uploads/2025/07/Bus_Servo_Adapter-2.pdf) · [ThinkRobotics ST3215](https://thinkrobotics.com/products/30kg-serial-bus-servo-high-precision-and-torque-with-encoder) · [ThinkRobotics ST3215-HS](https://thinkrobotics.com/products/st3215-hs) · [REES52 adapter](https://rees52.com/products/waveshare-serial-bus-servo-driver-board-all-in-one-servo-driver-board-with-integrated-power-control-for-st-sc-actuators-rs8478) · [Robocraze Waveshare adapter](https://robocraze.com/products/waveshare-serial-bus-servo-control-board-for-st-sc-series-servos) · [Robocraze SmartElex adapter](https://robocraze.com/products/smartelex-serial-bus-servo-driver-board-integrates-servo-power-supply-and-control-circuit) · [ElectronicsComp buck adapter](https://www.electronicscomp.com/waveshare-serial-bus-servo-dc-buck-adapter-mini-module-design-for-serial-bus-servos-easy-to-use-72v-buck-regulator) · [Amazon.in DIYmall](https://www.amazon.in/DIYmall-STS3215-Magnetic-Encoder-Arduino/dp/B0FGNZYNKC) · [Amazon.in Rcmall 6-pack](https://www.amazon.in/Robotics-Magnetic-Precision-Educational-Projects/dp/B0FLPQQ4FR) · [Amazon.in Waveshare adapter](https://www.amazon.in/Waveshare-Integrates-Control-Applicable-Integrate/dp/B0CJ6TP3TP)

Overseas / import: [Seeed STS3215](https://www.seeedstudio.com/STS3215-19kg-cm-7-4V-Serial-Servo-p-6338.html) · [Seeed FE-URT-1](https://www.seeedstudio.com/Feetech-FE-URT-1-p-6705.html) · [DFRobot 7.4 V](https://www.dfrobot.com/product-2961.html) · [DFRobot 12 V](https://www.dfrobot.com/product-2962.html) · [OpenElab](https://openelab.com/products/feetech-sts3215-c001-servo-7) · [Babsco STS3250](https://shop.babsco.com/feetech-sts3250-50kg-heavy-duty-smart-servo) · [Alibaba STS3215](https://www.alibaba.com/product-detail/Top-Seller-Low-Cost-Feetech-STS3215_1600999461525.html) · [AliExpress 6-pack](https://www.aliexpress.us/item/3256809204674483.html) · [AliExpress to India guide](https://electronics.alibaba.com/question/aliexpress-in-india-shipping,-safety-workarounds-(2025)) · [EximPe HSN 8501](https://eximpe.com/hsn/electric-motor-hsn-code) · [taxgst.in duty calculator](https://taxgst.in/import-duty-calculator-india/) · [FX rate](https://open.er-api.com/v6/latest/USD)

Software / robots: [Open Duck Mini](https://github.com/apirrone/Open_Duck_Mini) · [Open Duck BOM sheet](https://docs.google.com/spreadsheets/d/1gq4iWWHEJVgAA_eemkTEsshXqrYlFxXAPwO515KpCJc/edit?usp=sharing) · [orobot BOM mirror](https://orobot.io/o/program/BROKER-2/open-duck-mini) · [Open Duck MJCF](https://raw.githubusercontent.com/apirrone/Open_Duck_Playground/main/playground/open_duck_mini_v2/xmls/open_duck_mini_v2.xml) · [sim2real.md](https://github.com/apirrone/Open_Duck_Mini/blob/v2/docs/sim2real.md) · [Open Duck Runtime](https://github.com/apirrone/Open_Duck_Mini_Runtime) · [Runtime DeepWiki](https://deepwiki.com/apirrone/Open_Duck_Mini_Runtime) · [BAM](https://github.com/Rhoban/bam) · [BAM actuators](https://bam.readthedocs.io/en/latest/usage/actuators.html) · [LeRobot SO-101](https://huggingface.co/docs/lerobot/en/so101) · [LeRobot feetech.py](https://github.com/huggingface/lerobot/blob/main/src/lerobot/motors/feetech/feetech.py) · [LeRobot tables.py](https://github.com/huggingface/lerobot/blob/main/src/lerobot/motors/feetech/tables.py) · [feetech-servo-sdk](https://pypi.org/project/feetech-servo-sdk/) · [ftservo-python-sdk](https://pypi.org/project/ftservo-python-sdk/) · [vassar-feetech-servo-sdk](https://pypi.org/project/vassar-feetech-servo-sdk/) · [feetech-cli](https://pypi.org/project/feetech-cli/0.1.0/) · [python-st3215](https://github.com/Mickael-Roger/python-st3215) · [commanderfun/STS3215](https://github.com/commanderfun/STS3215) · [REGISTER_REFERENCE.md](https://github.com/commanderfun/STS3215/blob/main/REGISTER_REFERENCE.md) · [esphome-sts3215](https://github.com/DexiTheOne/esphome-sts3215) · [FeetechStsServos (Arduino)](https://github.com/DeltaEngine/FeetechStsServos) · [STM32 single-wire port](https://github.com/viteo/STM32-BluePill-SCServo-library) · [kevinmcaleer/sts3215](https://github.com/kevinmcaleer/sts3215) · [sts_hardware_interface](https://github.com/adityakamath/sts_hardware_interface) · [feetech_ros2_driver](https://github.com/JafarAbdi/feetech_ros2_driver) · [feetech_ros2_driver (ROS index)](https://index.ros.org/p/feetech_ros2_driver/) · [feetech_scs_ros2_driver](https://github.com/Ar-Ray-code/feetech_scs_ros2_driver) · [pan_tilt_ros](https://github.com/adityakamath/pan_tilt_ros) · [Feetech-microros](https://github.com/botamochi6277/Feetech-microros) · [Pi UART pinout](https://pinout.xyz/pinout/uart)

CAD: [GrabCAD STS3215](https://grabcad.com/library/feetech_sts3215-1) · [GrabCAD U-brackets](https://grabcad.com/library/u_shaped-brackets-for-feetech-sts3215-1) · [step.parts ST3215](https://www.step.parts/parts/waveshare_feetech_st3215_servo) · [Printables STS3215 model](https://www.printables.com/model/1477431-servo-motor-sts3215-feetech-model/files) · [RCmall bracket](https://www.amazon.com/RCmall-Aluminum-Bracket-Feetech-Feedback/dp/B0GVLSJ6TG) · [AliExpress bracket](https://www.aliexpress.com/item/1005009352258061.html)

---

## Critic additions (2026-09-26, from `07_critic_gaps.md`)

1. **Mass used in §5.1 is wrong.** The Open Duck Playground MJCF sums to **2.1071 kg** (critic re-summed the 15 inertials) and the `mini_bdx` XML/URDF to **2.0615 kg**; 2.045 kg matches neither. Effect on §5.1: torques scale by 2.107/2.045 = +3 %, i.e. ankle 8.4, knee 7.4, hip roll 9.5 kg.cm static worst case — stall margins 2.05-2.6x (C001), 3.2-4.0x (C018). Conclusion unchanged. The TL;DR's "2.3-4x" should read "2.1-2.7x (C001) / 3.2-4.2x (C018)".
2. **Servo envelope as modelled in the Open Duck CAD** (critic's measurement of the reference meshes `wj-wk00-0122/0123/0124*.stl`): three shells 9.70 + 13.90 + 14.10 mm thick, **union 45.22 x 24.72 x 35.70 mm** — consistent with §1.1's 35 mm catalogue height plus the raised boss. Use 35.7 mm for the pocket height stack.
3. **Horn discs as modelled in the Open Duck CAD:** `drive_palonier` = disc **O19.95 x 5.05 mm** with O3.2 centre hole; `passive_palonier` = **O19.95 x 3.10 mm** with O6.1 bore (rides on the O6 rear idler shaft). So the reference design uses a O20 disc on both faces (Feetech's supplied aluminium discs), matching the Waveshare O19.2 / O14-cross disc in §1.4 to within 0.75 mm. Open question 2 (M3-tapped vs clearance) stays open.
4. **Connector pitch (§1.5):** Molex's 5264 SPOX family is nominally **2.50 mm** pitch, not 2.54 (Molex page timed out for the critic; treat as 2.50 mm **[unverified here]**). JST-XH / "Relimate" 2.50 mm 3-pin housings are the usual substitute but need a fit test (see 06 §7).
5. **kp mapping (open question 8):** the maintainer states "the 17.8 in mujoco corresponds to 32 in the motors firmware units" ([Open_Duck_Mini issue #20](https://github.com/apirrone/Open_Duck_Mini/issues/20), quoted in 02 §2.5) — i.e. ~0.556 N.m/rad per firmware P unit (critic's arithmetic; the Playground XML actually ships kp = 13.37 / 17.11, so re-identify on your leg anyway). BAM's identified parameters are in 02 §2.4 (max_velocity 5.07-5.30 rad/s, kt 1.18-1.28 N.m/A, R 2.45-2.75 ohm, armature 0.0216-0.026).
6. **robu.in price in §4.1:** the "Rs 2,097 30 kg.cm" came from a search snippet with a 403'd page; `06_electronics_bom_inr.md` read the listings the same day: Waveshare ST3215 **7.4 V Rs 2,159 (SKU R258500)**, 12 V 30 kg Rs 2,599. Trust 06, but R258500's gear ratio/voltage is still unverified (403 again for the critic).
7. **Bearing for the reference design** (relevant to §6 checklist item 2): Open Duck's passive hip-roll and head-roll pivots use **6804ZZ 20 x 32 x 7 mm** (3 pcs), not 608 — see 02 Critic additions.
