nickthelegend/thenar-duck/cad/thenar_duck_A/reports/interfaces.csv

component | mount | installation | clearance | status
BK 4200mAh 3S | A08_battery_sled | Remove roof and upper trays; lower pack vertically. For later swaps remove rear cover and release both straps. | 1 mm per side at maximum 52 mm width; 2 mm foam pad; lead exit and connector bend space require actual pack measurement | HOLD actual dimensions
Raspberry Pi 4B | A10_Pi4B_removable_tray | Mount Pi to tray outside robot. Connect short USB leads. Lower tray through roof opening, then fix four M3 screws. | 5mm underside, side I/O window, open USB end, microSD notch, 29.4mm PCB-top to roof | Drawing checked; physical cables/cooling unconfirmed
DFRobot SEN0374 | A11_SEN0374_fixed_IMU_bridge | Fit two M2 screws and nuts on bench, then bolt bridge to rack. Headers soldered before installation. | 3mm under board; header space to z300; full vertical removal after roof removal | Manufacturer drawing checked; physical header style pending
4 KW10-DZ2P075 foot switches | A15 cassettes + A17 plungers | Solder and insulate wires, insert switches from top, install M2 bolts through slots. Insert plungers from underneath, then fit TPU soles. Adjust switch height with meter. | 12.8x5.8x6.5 case; 6.5 hole pitch; 3mm vertical adjustment; 1.25mm plunger hard-stop travel | Catalogue checked; physical actuation calibration REQUIRED
