nickthelegend/thenar-duck/cad/thenar_duck_B/reports/interfaces.csv

component | mount | installation | clearance | status
BK4200 3S | B08 sled / B05 rear lead bay | Thread straps, install pad, lower pack with leads rearward. Rear cover removes for horizontal swaps. | 140x50x32 pack capacity; published pack137x44x27; rear lead/connector bay35mm beyond nominal pack | Manufacturer dimensions used; label-model inference recorded
Main switch / fuse holder | B06 external service pod | Fit switch to matching lid on bench; strap fuse body into lower cradle; insulate terminals; mount lid last. | Fuse45x24x24; switch+terminals24x22x30. Four complete lid variants supplied. | Adjustable packaging, actual switch identity not asserted
Pi4B | B10 tray | Fit board/cables on bench, lower tray through roof, fasten corners. | 5mm below board; open USB end;microSD notch;roof9.4mm above USB shells | Published mechanical drawing
DFRobot SEN0374 | B11 side bridge | Fit M2 bolts and nuts on bench. Bolt bridge to rack; Pi tray clears it through side slot. | PCB outside Pi footprint; header/plug height14.4mm; independent removal after Pi tray | Published mechanical drawing
PDB / UBEC / Waveshare adapter | B09 rack | Fit spacers, align slot-mounted PDB, tie UBEC to insulated saddle, bolt adapter on37x28 pattern before lowering rack. | PDB pitch28..33;UBEC45x22x15;adapter42x33 | Published adapter/Matek reference; adjustable unmeasured clone/wrapped module
