nickthelegend/thenar-duck/cad/development/body_front.png

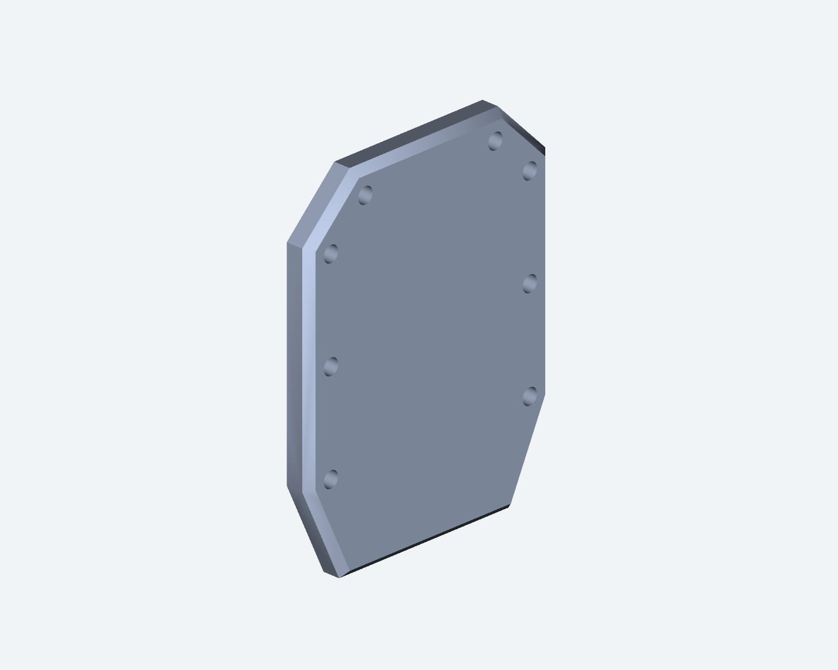
cad/development/body_front.png
