nickthelegend/thenar-duck/cad/development/foot_bottom_pla.png

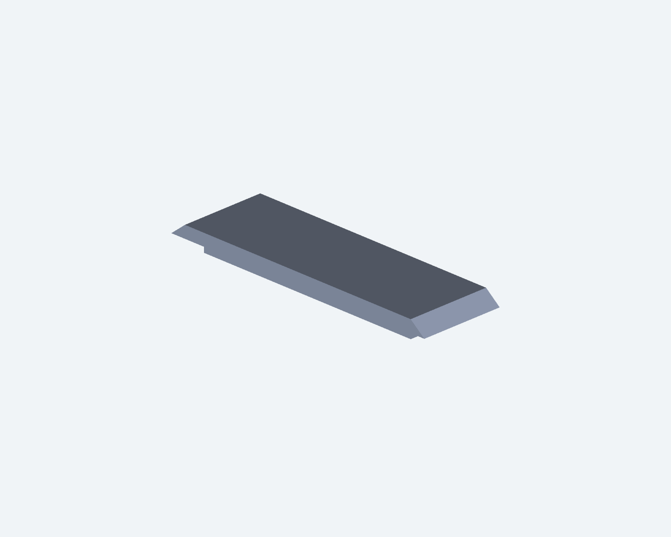
cad/development/foot_bottom_pla.png
