nickthelegend/thenar-duck/cad/development/head_roll_mount.png

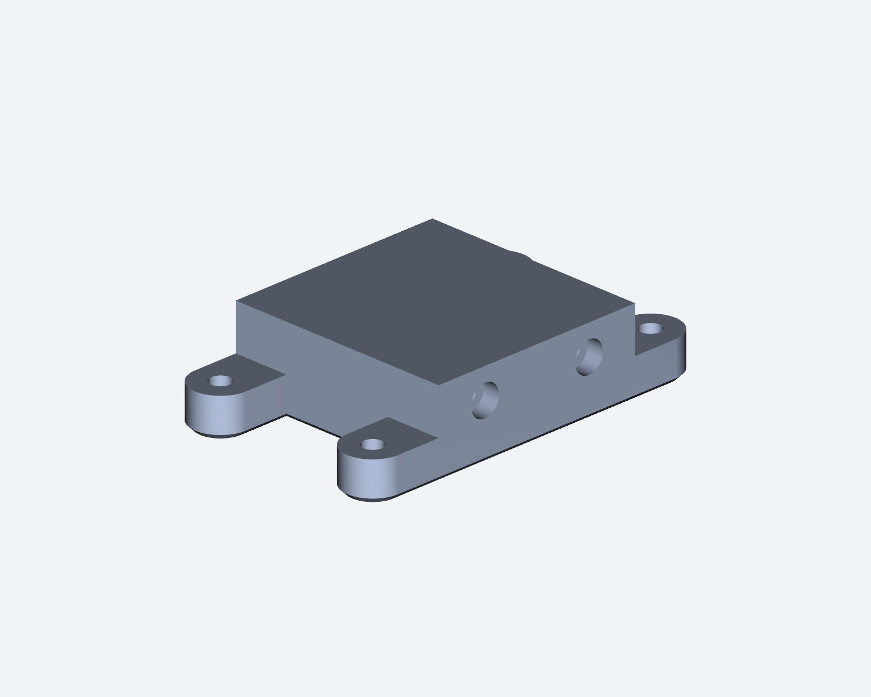
cad/development/head_roll_mount.png
