nickthelegend/thenar-duck/cad/development/reference.png

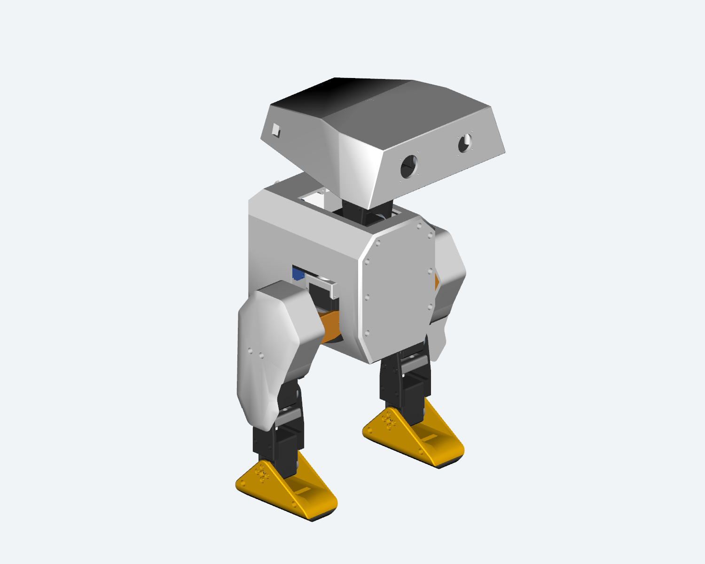
cad/development/reference.png
