nickthelegend/thenar-duck/cad/development/trunk_bottom.png

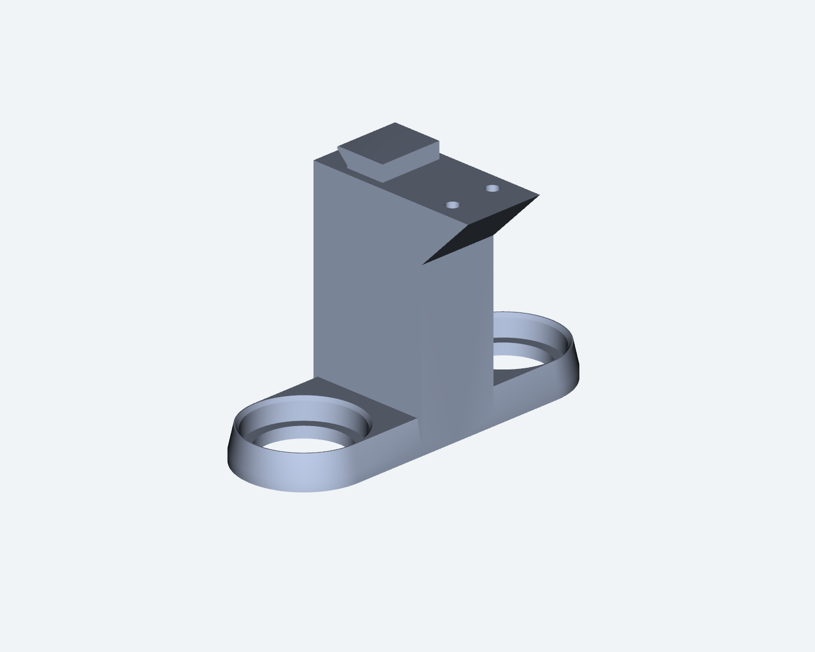
cad/development/trunk_bottom.png
