nickthelegend/thenar-duck/cad/development/trunk_top.png

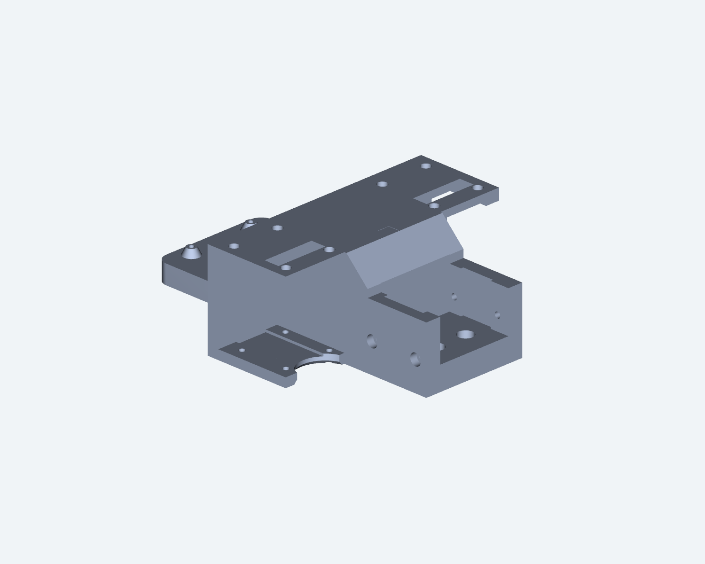
cad/development/trunk_top.png
