nickthelegend/thenar-duck/cad/thenar_duck_A/renders/00_rack_development.png

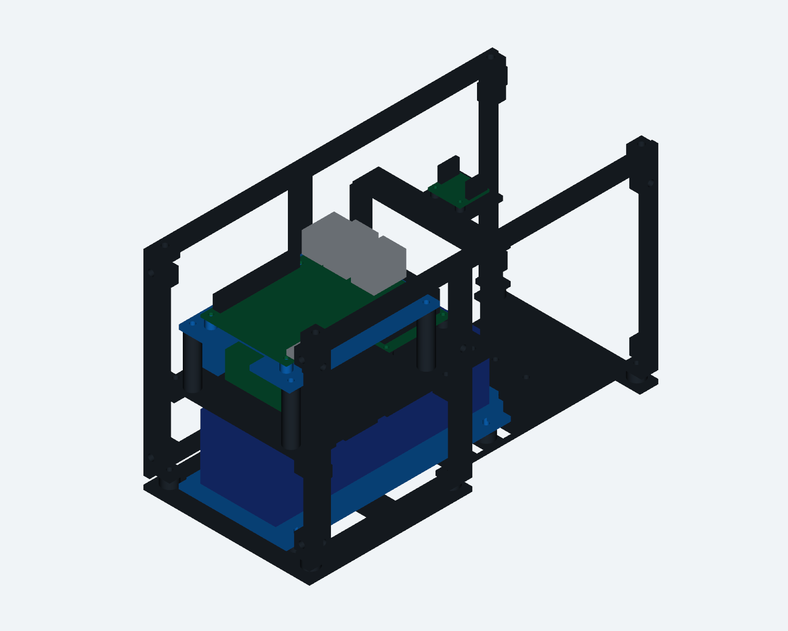
cad/thenar_duck_A/renders/00_rack_development.png
