nickthelegend/thenar-duck/cad/thenar_duck_A/renders/02_covers_removed.png

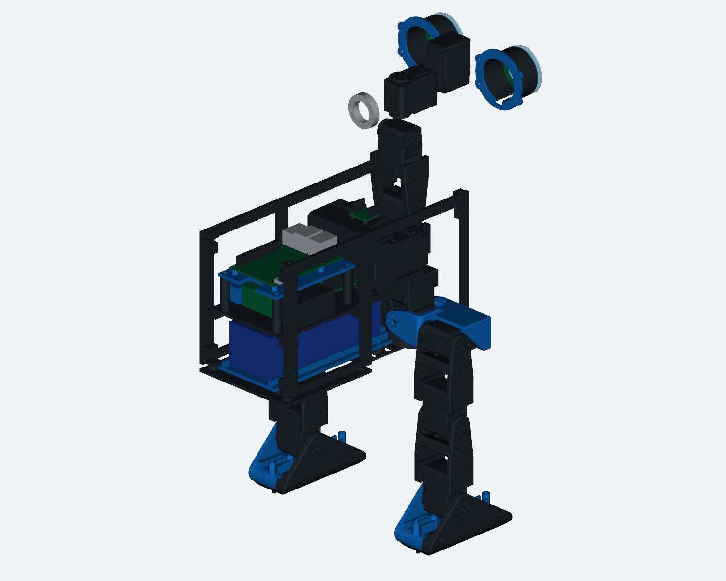
cad/thenar_duck_A/renders/02_covers_removed.png
