nickthelegend/thenar-duck/cad/thenar_duck_A/renders/03_electronics_access.png

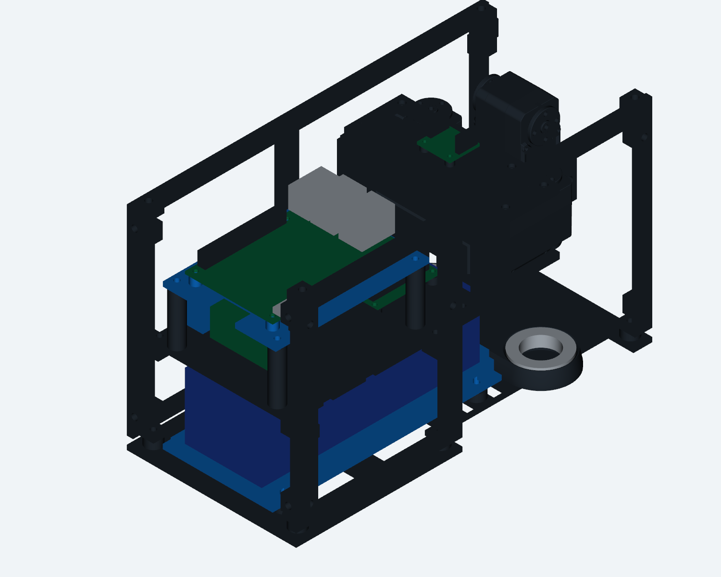
cad/thenar_duck_A/renders/03_electronics_access.png
