nickthelegend/thenar-duck/cad/thenar_duck_A/renders/04_foot_development.png

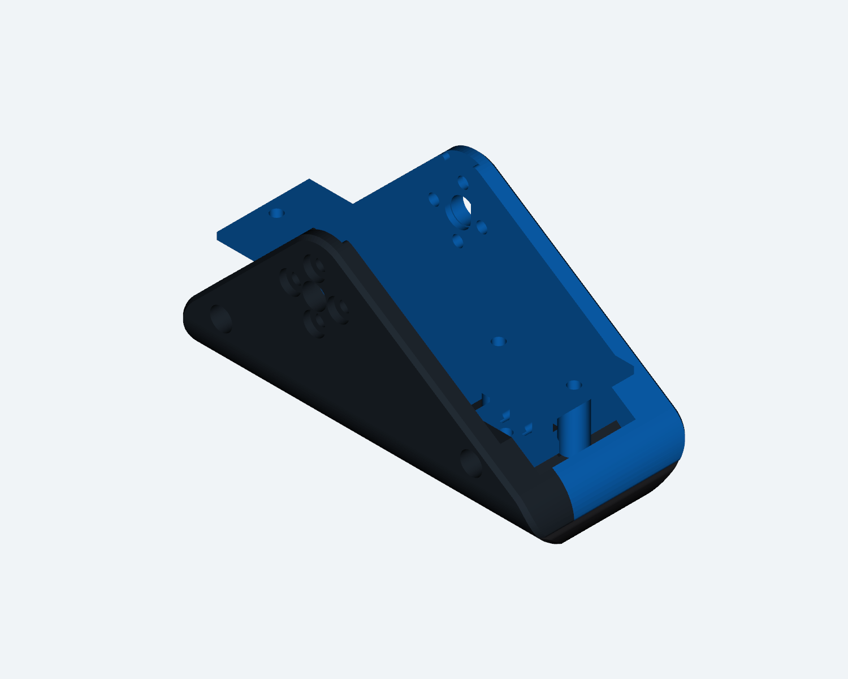
cad/thenar_duck_A/renders/04_foot_development.png
