nickthelegend/thenar-duck/cad/thenar_duck_B/bambu/plate_overview.png

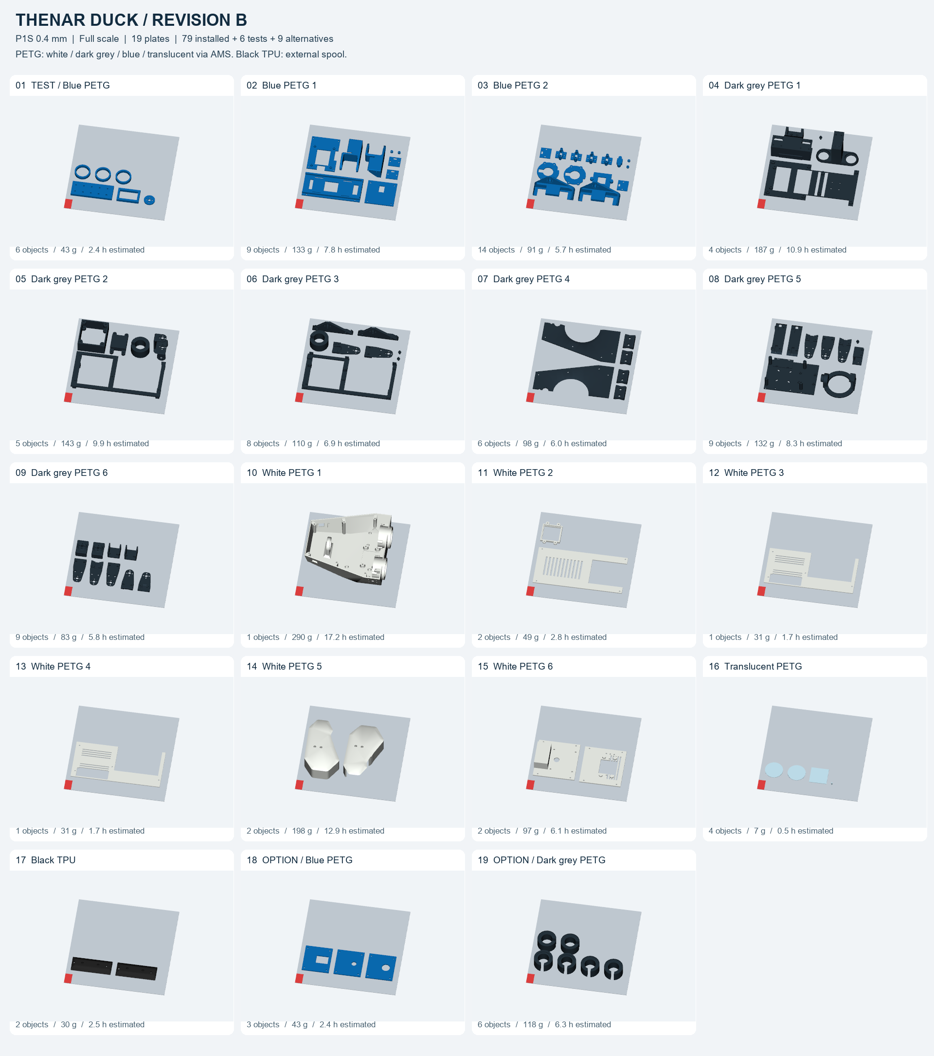
cad/thenar_duck_B/bambu/plate_overview.png
