nickthelegend/thenar-duck/cad/thenar_duck_B/bambu/plate_previews/plate_01.png

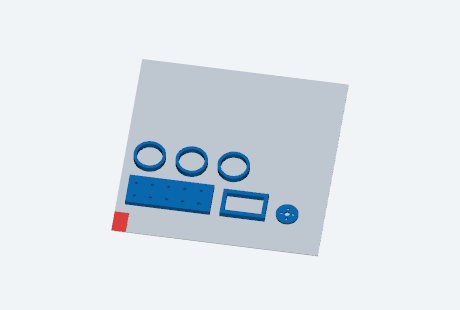
cad/thenar_duck_B/bambu/plate_previews/plate_01.png
