nickthelegend/thenar-duck/cad/thenar_duck_B/bambu/plate_previews/plate_07.png

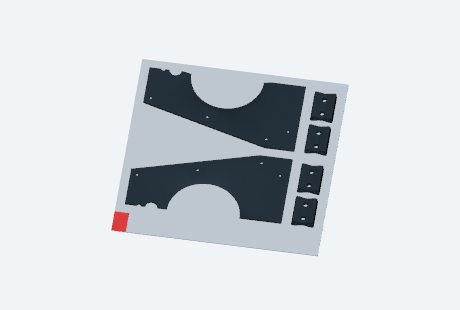
cad/thenar_duck_B/bambu/plate_previews/plate_07.png
