nickthelegend/thenar-duck/cad/thenar_duck_B/bambu/plate_previews/plate_10.png

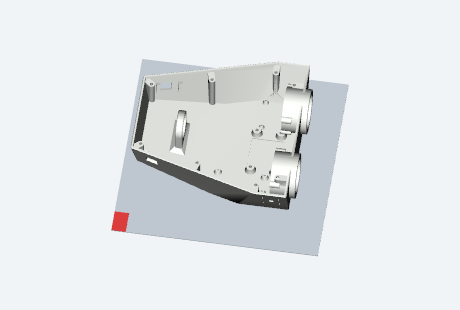
cad/thenar_duck_B/bambu/plate_previews/plate_10.png
