nickthelegend/thenar-duck/cad/thenar_duck_B/renders/00_packaging_check.png

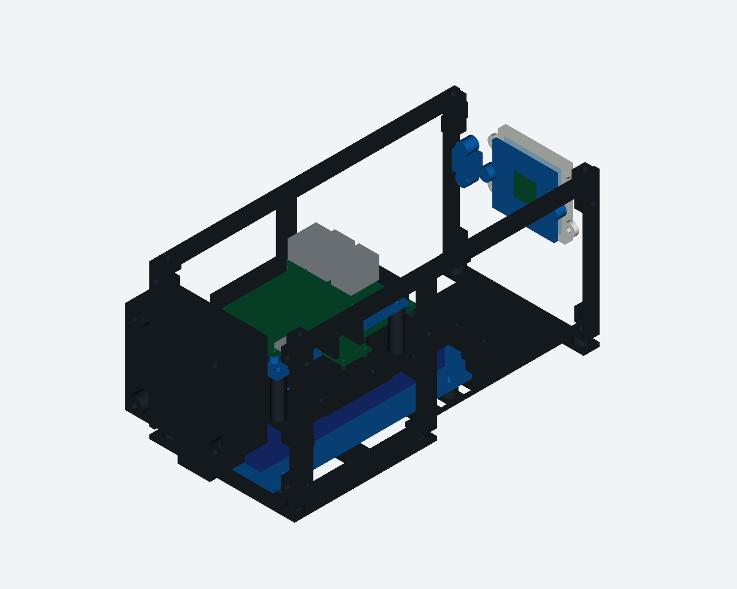
cad/thenar_duck_B/renders/00_packaging_check.png
