nickthelegend/thenar-duck/cad/thenar_duck_B/renders/04_service_layout.png

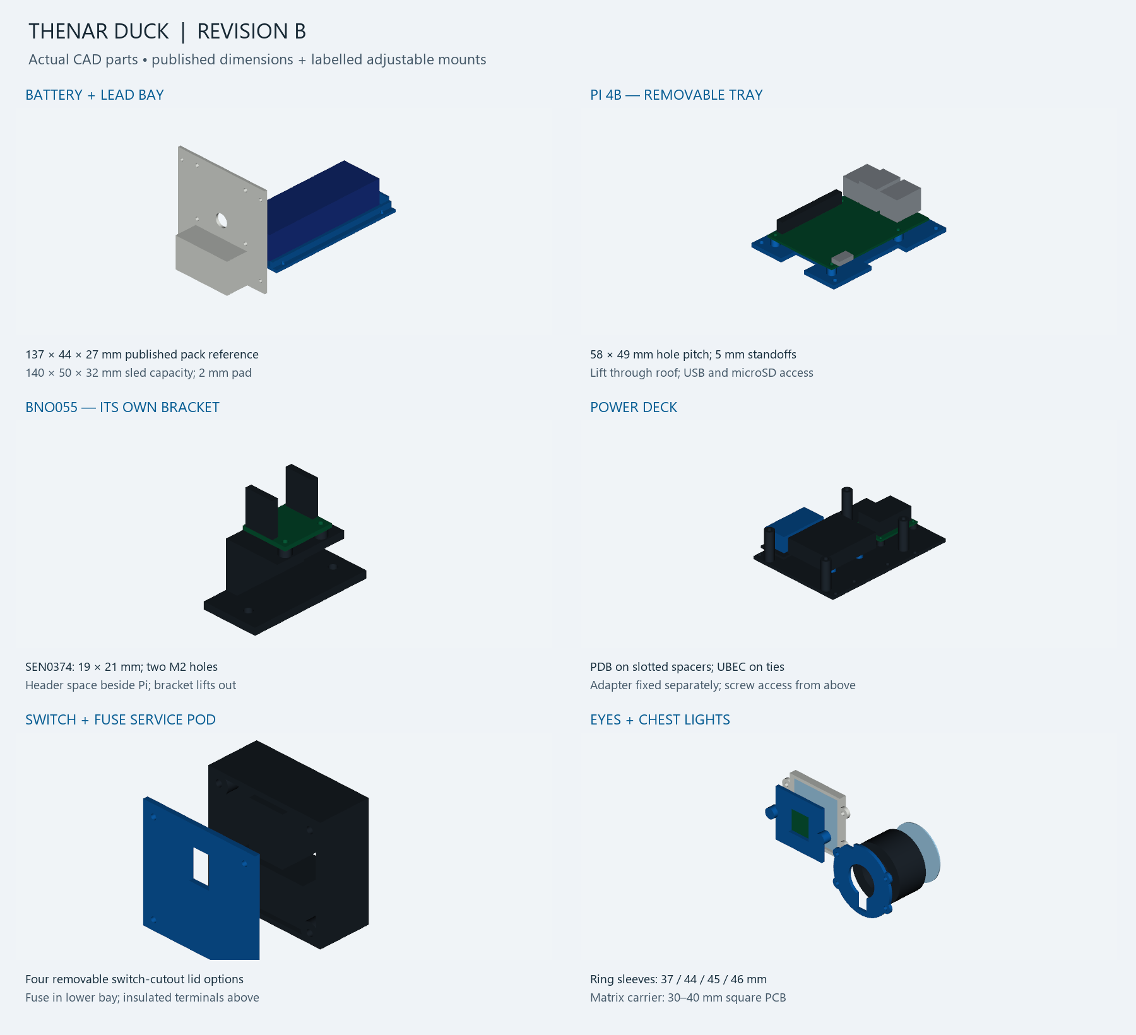
cad/thenar_duck_B/renders/04_service_layout.png
