nickthelegend/thenar-duck/cad/thenar_duck_B/renders/service_detail_5.png

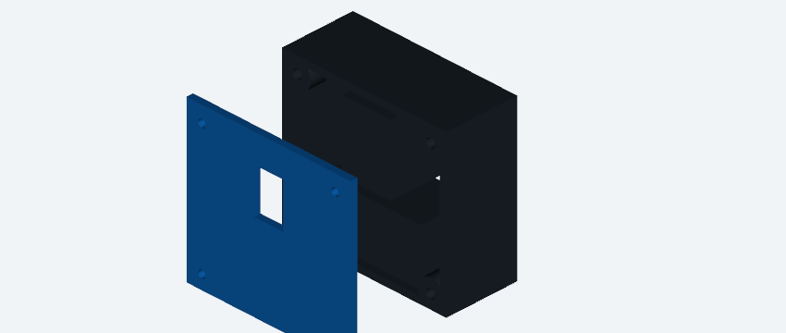
cad/thenar_duck_B/renders/service_detail_5.png
