nickthelegend/thenar-duck/references/01_yourstory_hero_original.jpg

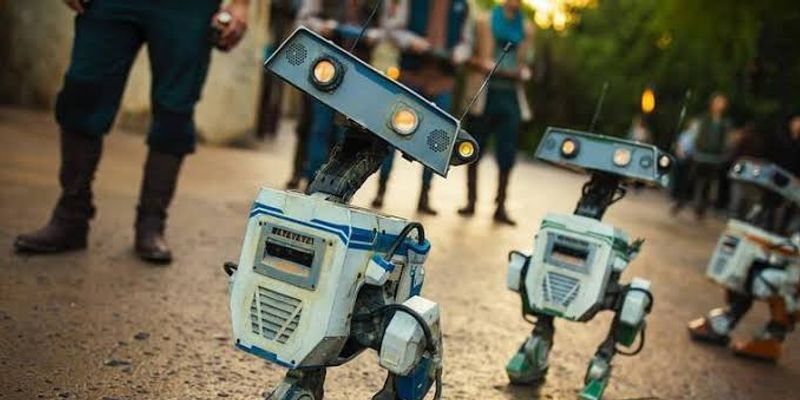
references/01_yourstory_hero_original.jpg
