nickthelegend/thenar-duck/references/04_paper_exploded_view_hires.png

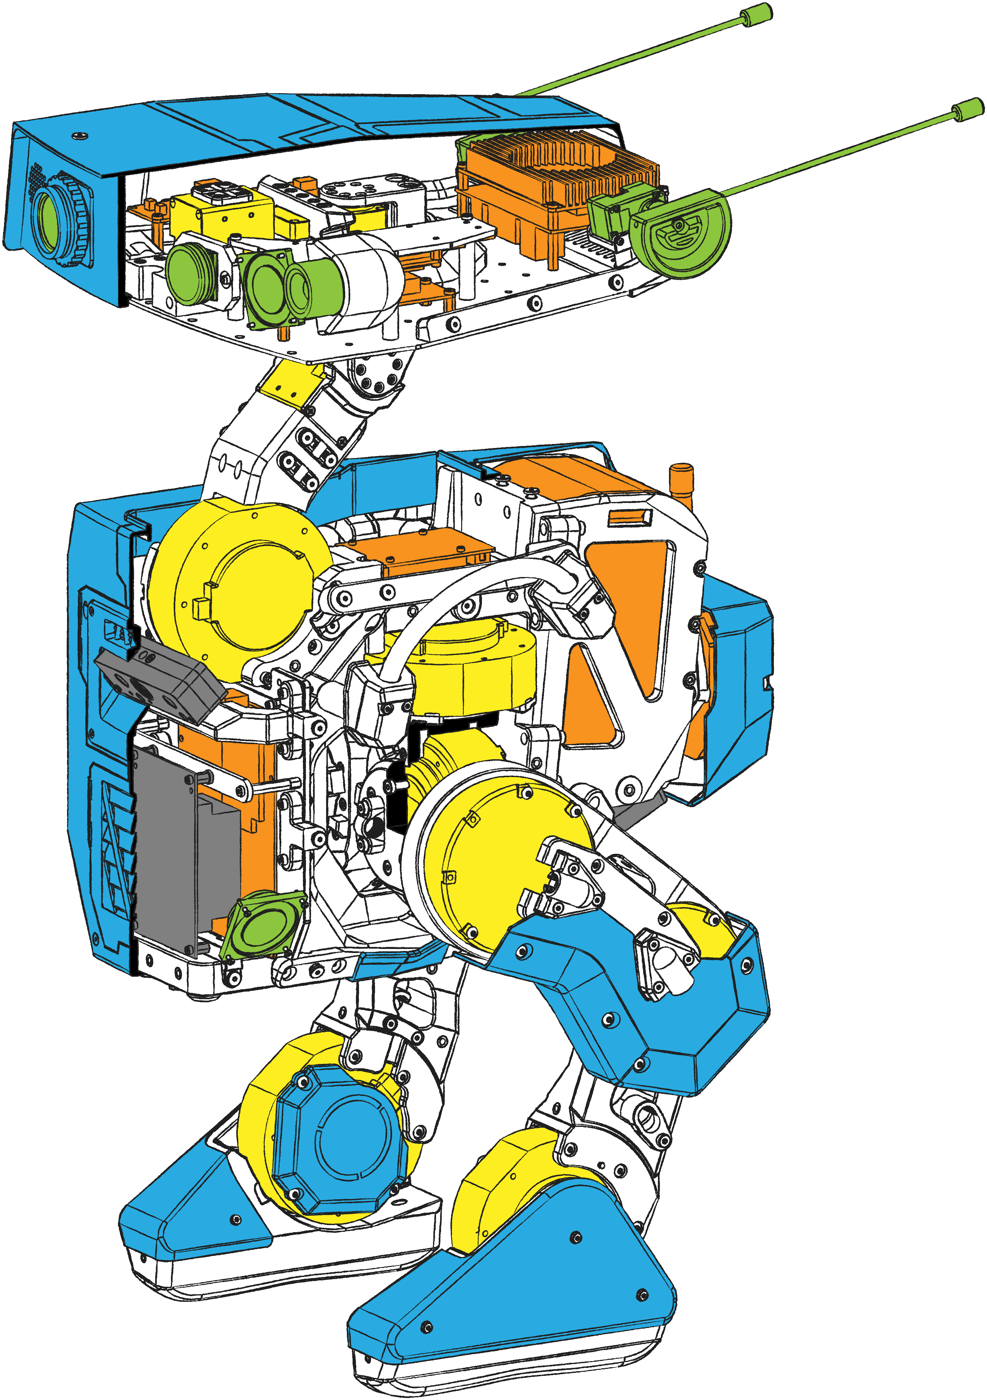
references/04_paper_exploded_view_hires.png
