nickthelegend/thenar-duck/references/05_paper_path_frame_standing.jpg

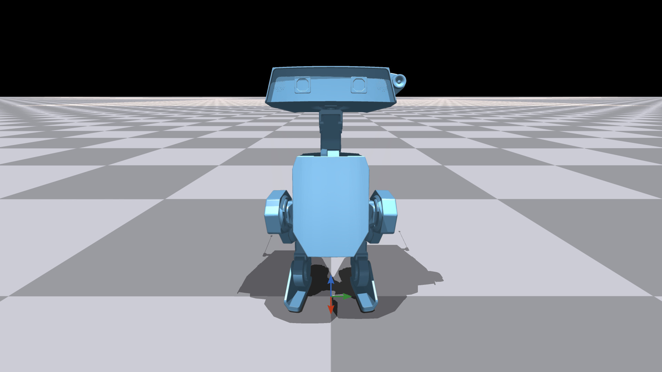
references/05_paper_path_frame_standing.jpg
