nickthelegend/thenar-duck/references/06a_paper_sim_side_head_height_min_max.jpg

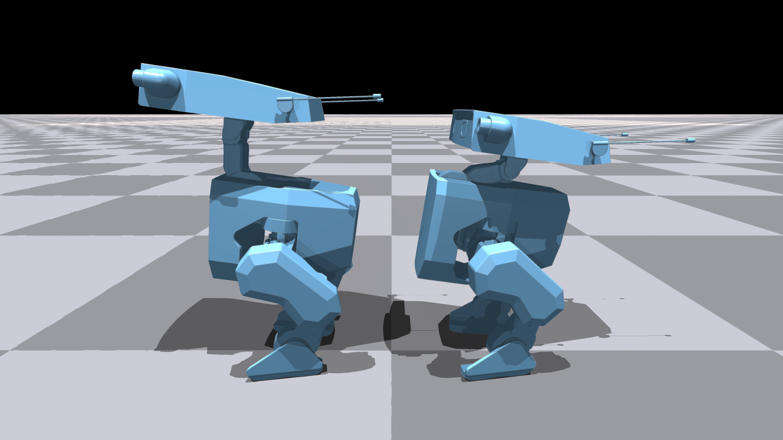
references/06a_paper_sim_side_head_height_min_max.jpg
