nickthelegend/thenar-duck/references/06b_paper_sim_front_head_yaw_min_max.jpg

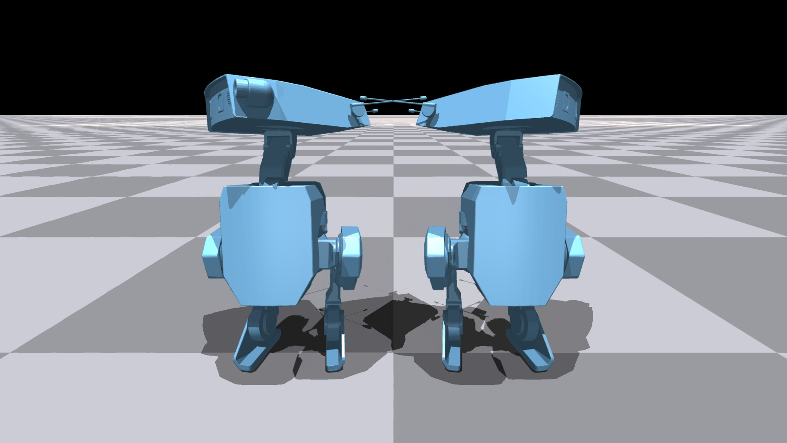
references/06b_paper_sim_front_head_yaw_min_max.jpg
