nickthelegend/thenar-duck/references/06c_paper_sim_side_head_pitch_min_max.jpg

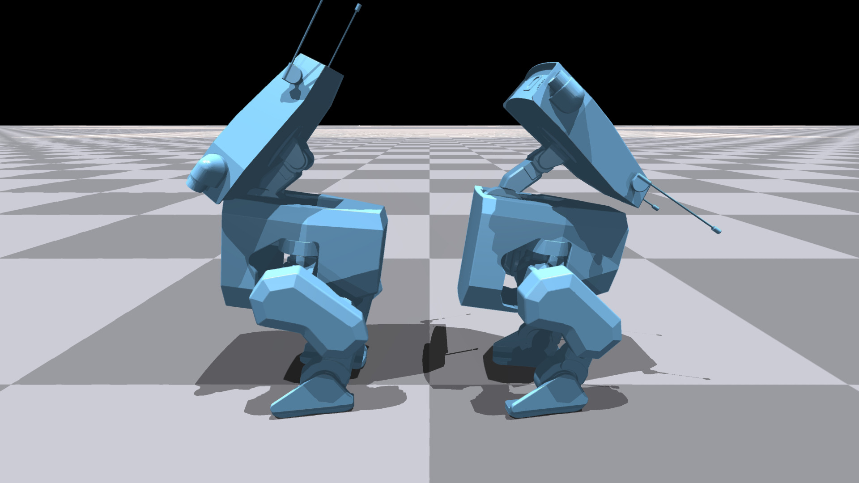
references/06c_paper_sim_side_head_pitch_min_max.jpg
