nickthelegend/thenar-duck/references/06e_paper_sim_front_torso_height_min_max.jpg

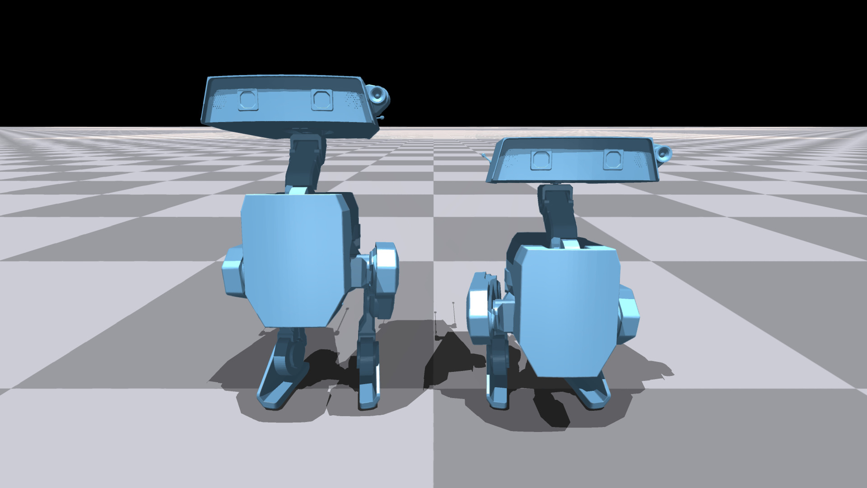
references/06e_paper_sim_front_torso_height_min_max.jpg
