nickthelegend/thenar-duck/references/06h_paper_sim_front_torso_roll_min_max.jpg

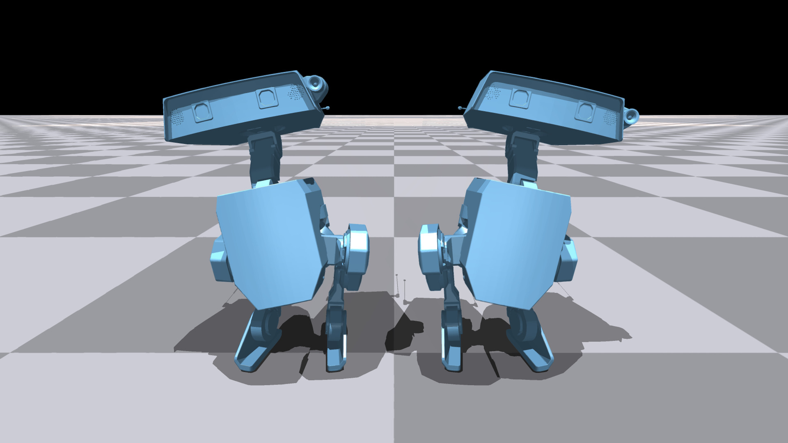
references/06h_paper_sim_front_torso_roll_min_max.jpg
