nickthelegend/thenar-duck/references/07_paper_standing_controls.jpg

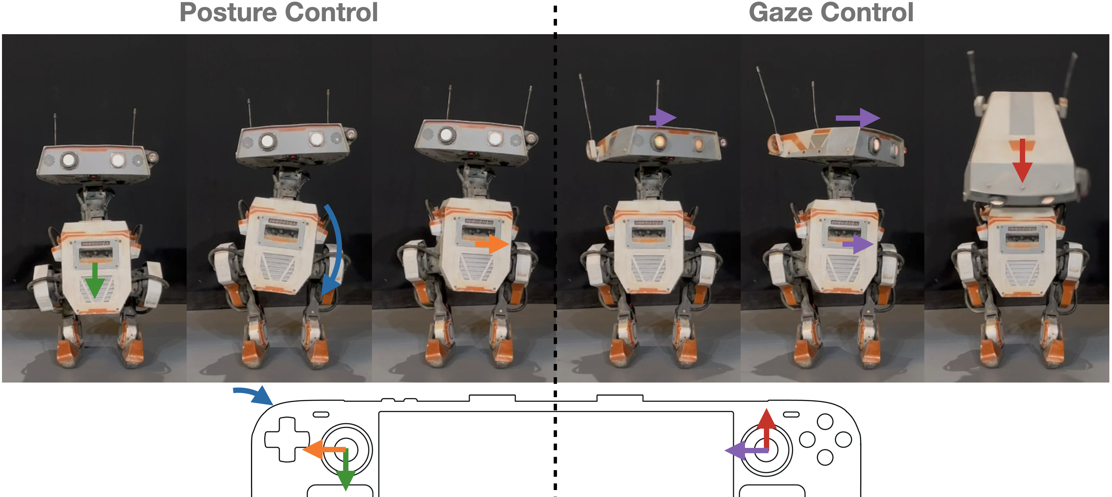
references/07_paper_standing_controls.jpg
