nickthelegend/thenar-duck/references/09_disneyresearch_bdx_page.jpg

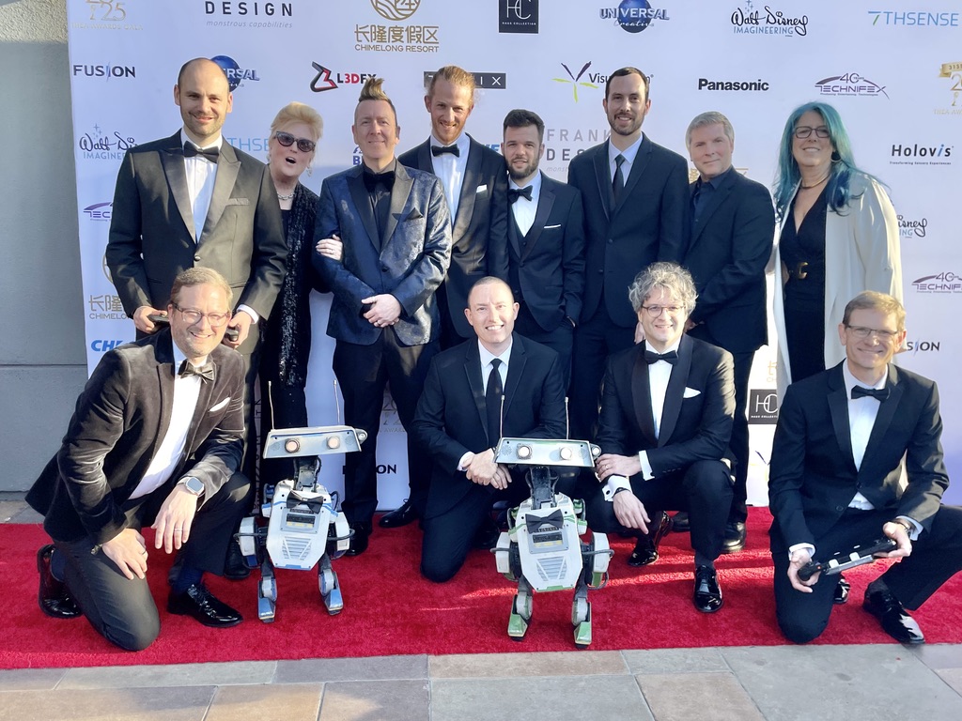
references/09_disneyresearch_bdx_page.jpg
