nickthelegend/thenar-duck/references/10_paper_fig1_three_droids_galaxys_edge.jpg

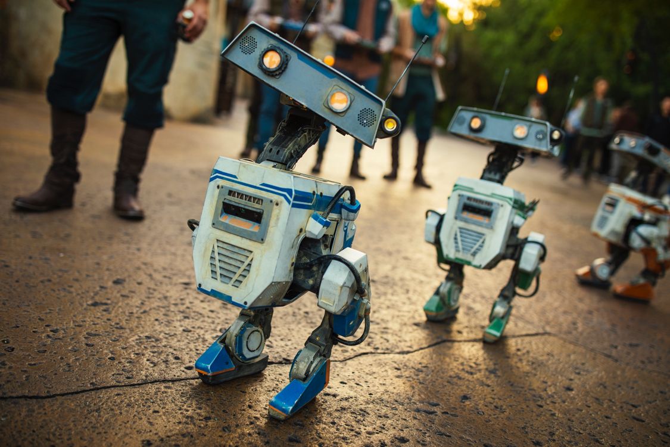
references/10_paper_fig1_three_droids_galaxys_edge.jpg
