nickthelegend/thenar-duck/references/12_paper_cad_shell_transparent_3quarter.png

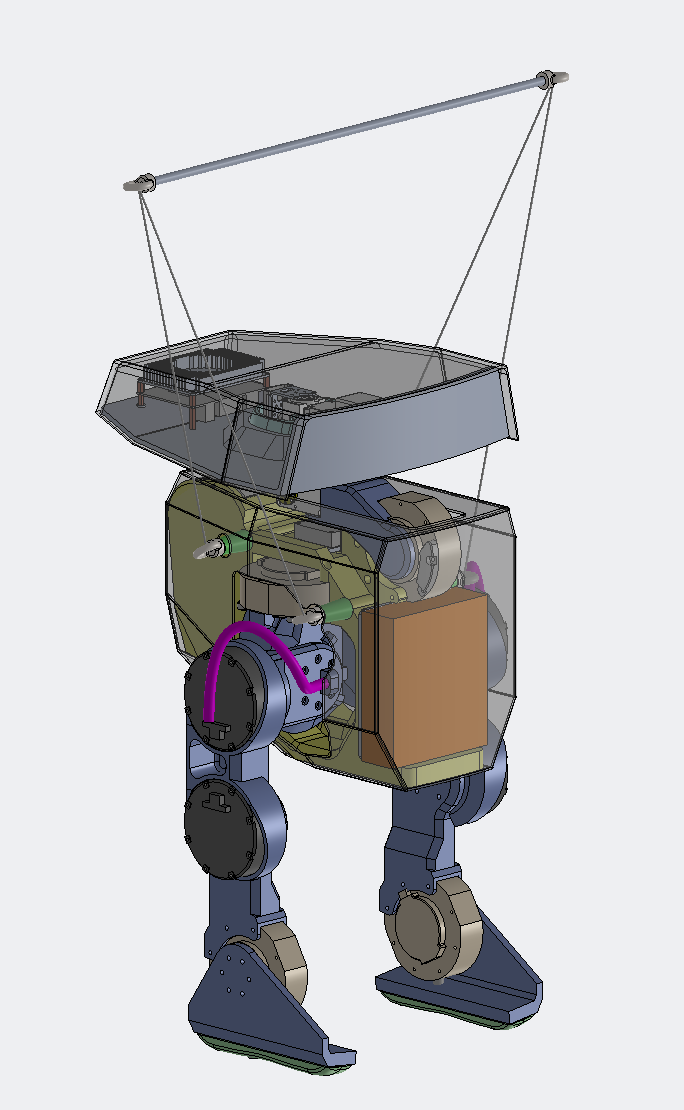
references/12_paper_cad_shell_transparent_3quarter.png
