nickthelegend/thenar-duck/references/13_paper_cad_front_thigh100_vs_thigh195.png

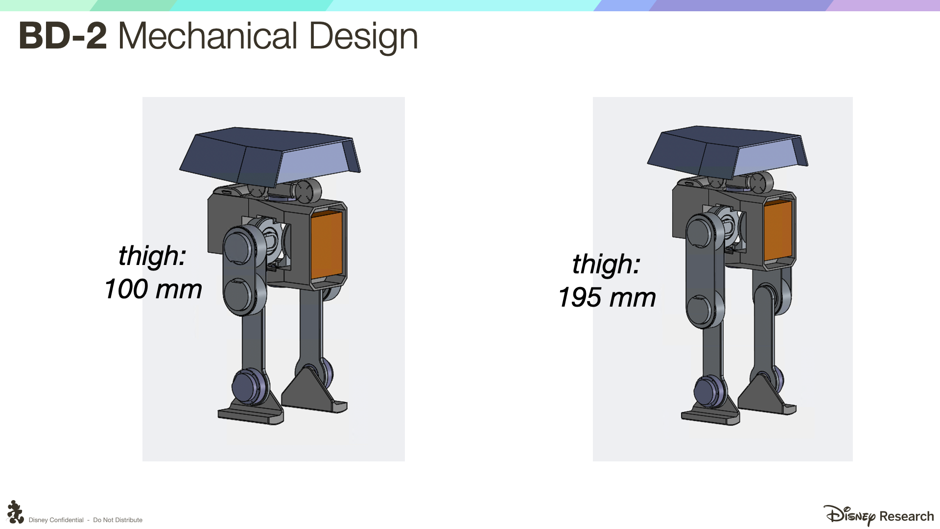
references/13_paper_cad_front_thigh100_vs_thigh195.png
