nickthelegend/thenar-duck/references/14_paper_anim_rig_walk_front_3quarter.png

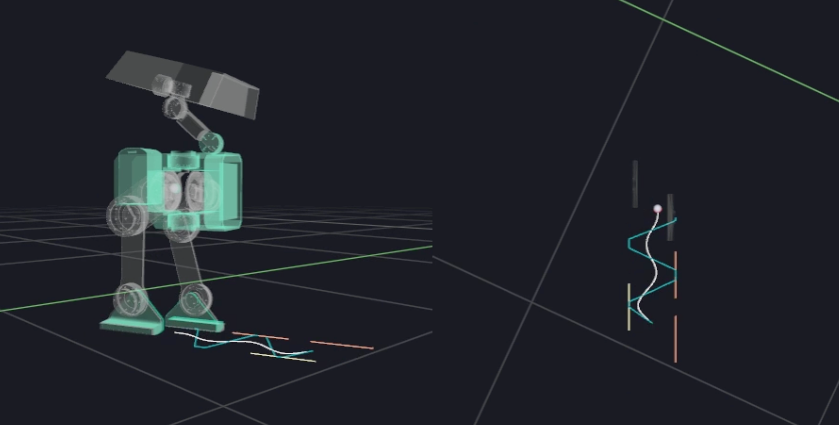
references/14_paper_anim_rig_walk_front_3quarter.png
