nickthelegend/thenar-duck/references/15_paper_anim_rig_walk_side_3quarter.png

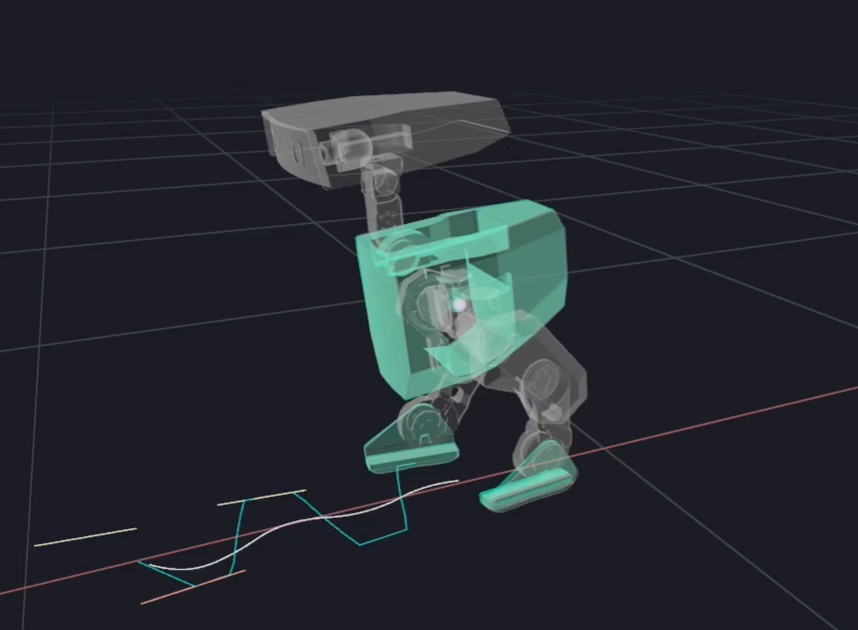
references/15_paper_anim_rig_walk_side_3quarter.png
