nickthelegend/thenar-duck/references/18_paper_droid_with_person_scale_b.jpg

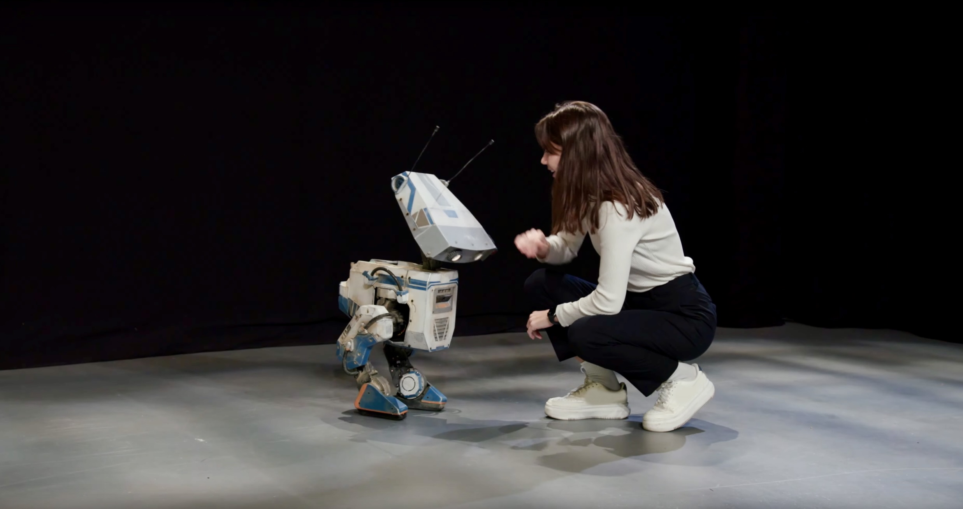
references/18_paper_droid_with_person_scale_b.jpg
