nickthelegend/thenar-duck/references/27_openduck_v2_cad_render_internals.png

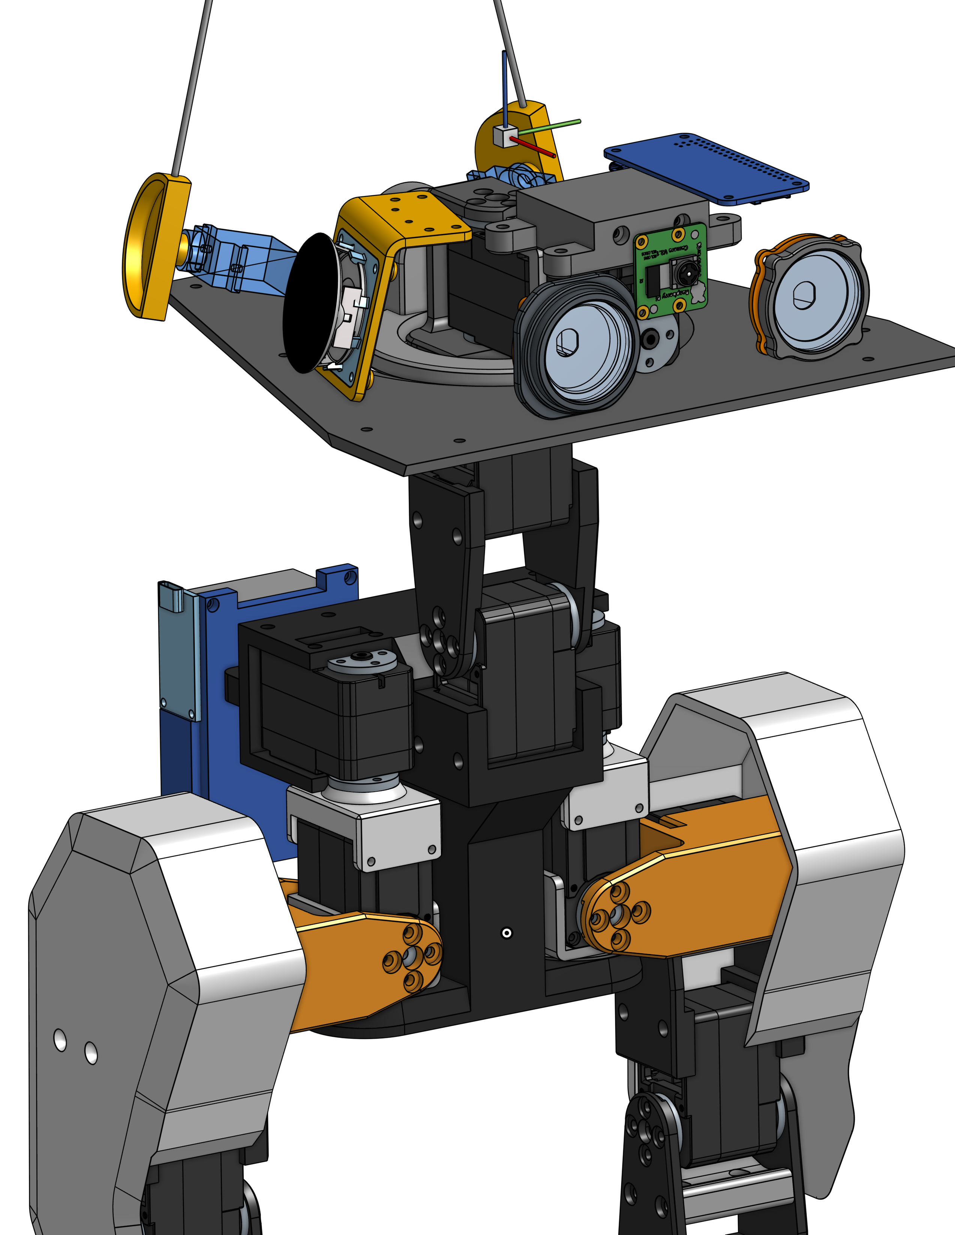
references/27_openduck_v2_cad_render_internals.png
