nickthelegend/thenar-duck/references/31_newatlas_iros2023_b.png

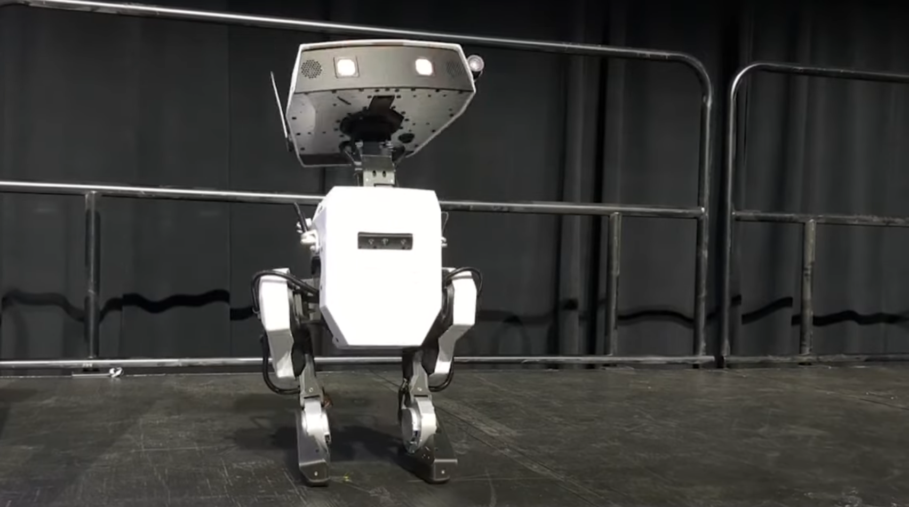
references/31_newatlas_iros2023_b.png
