nickthelegend/thenar-duck/references/34_newatlas_iros2023_e.jpg

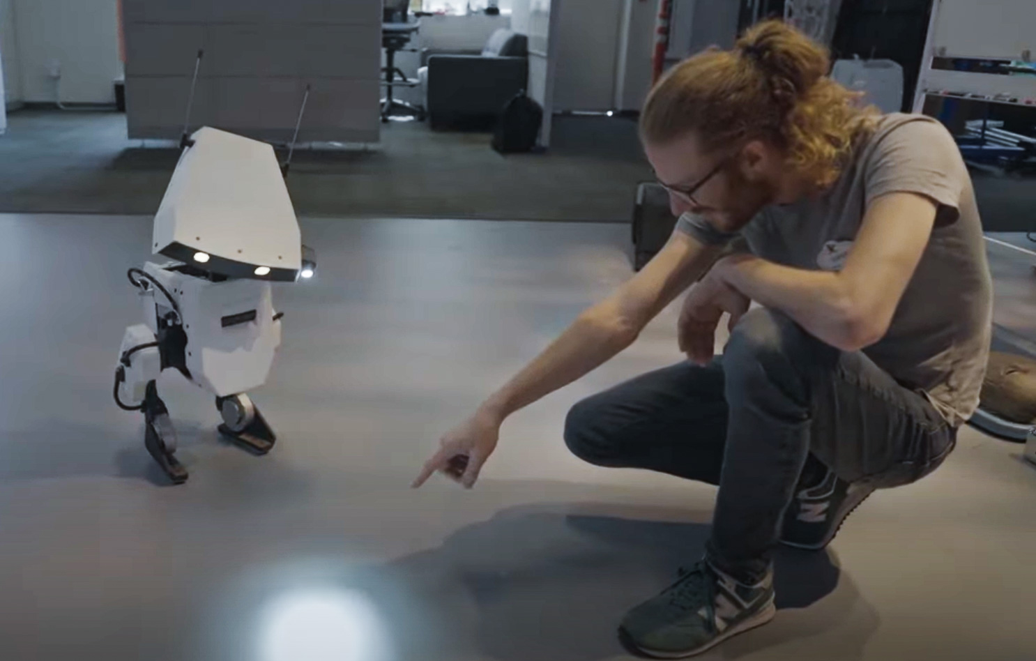
references/34_newatlas_iros2023_e.jpg
