nickthelegend/thenar-duck/references/40_3dprint_three_droids_galaxys_edge_cast.jpg

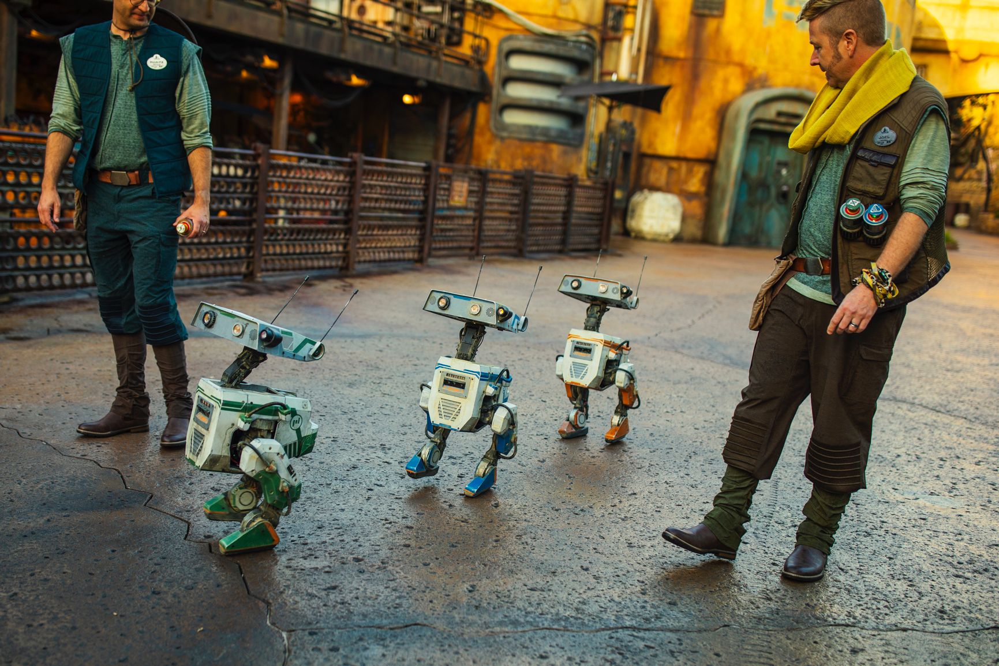
references/40_3dprint_three_droids_galaxys_edge_cast.jpg
