nickthelegend/thenar-duck/references/41_3dprint_orange_droid_3quarter_front.jpg

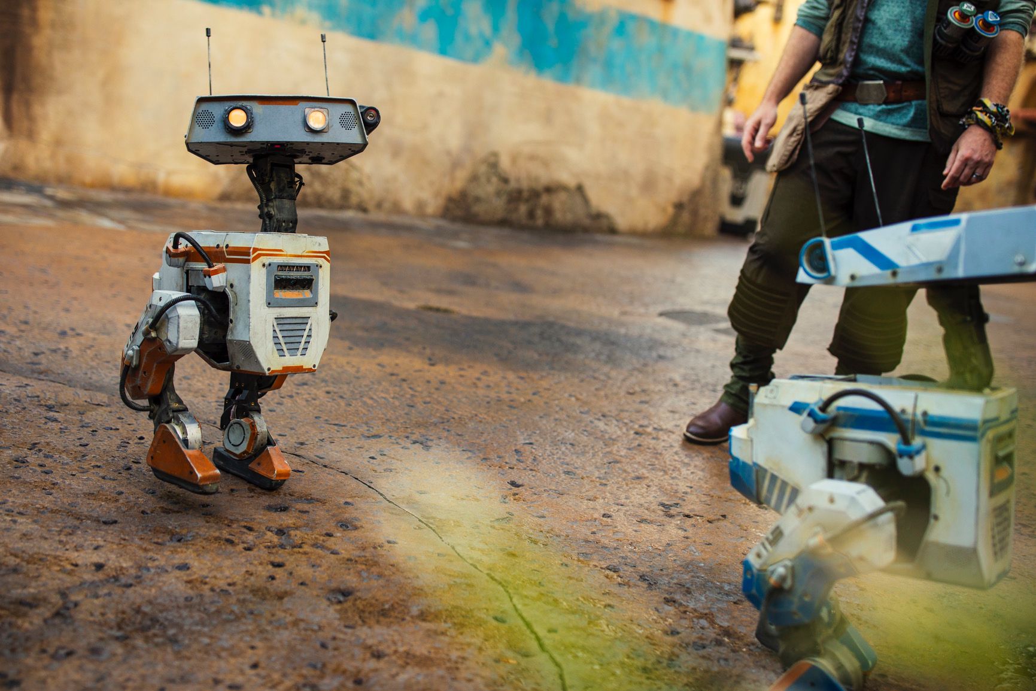
references/41_3dprint_orange_droid_3quarter_front.jpg
