nickthelegend/thenar-duck/references/42_dtb_three_droids_front_stage.jpg

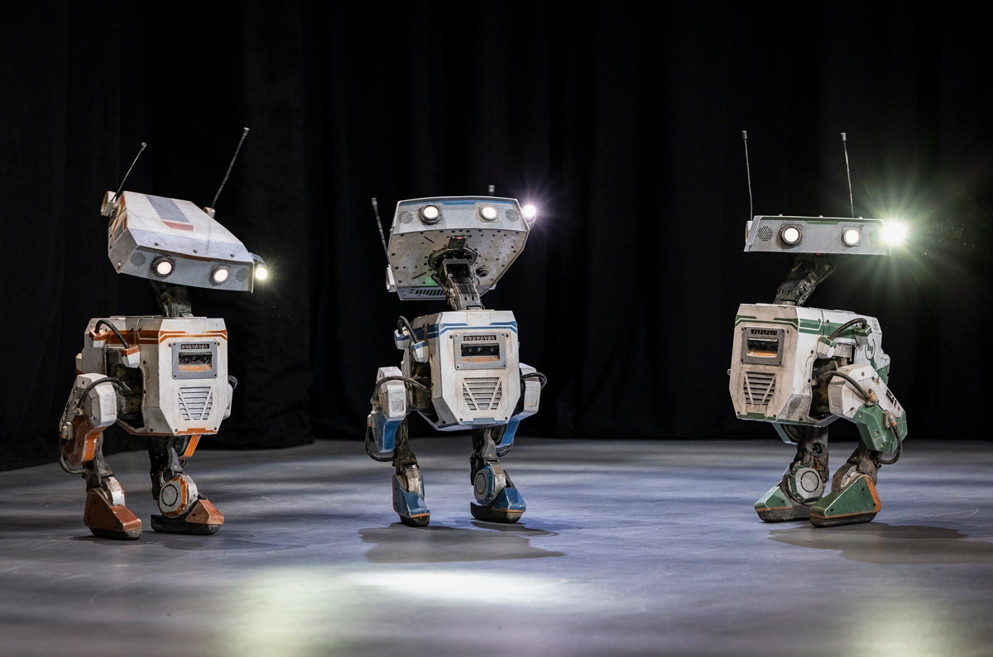
references/42_dtb_three_droids_front_stage.jpg
