nickthelegend/thenar-duck/references/45_nvidia_gtc2025_blue_3quarter_side.jpg

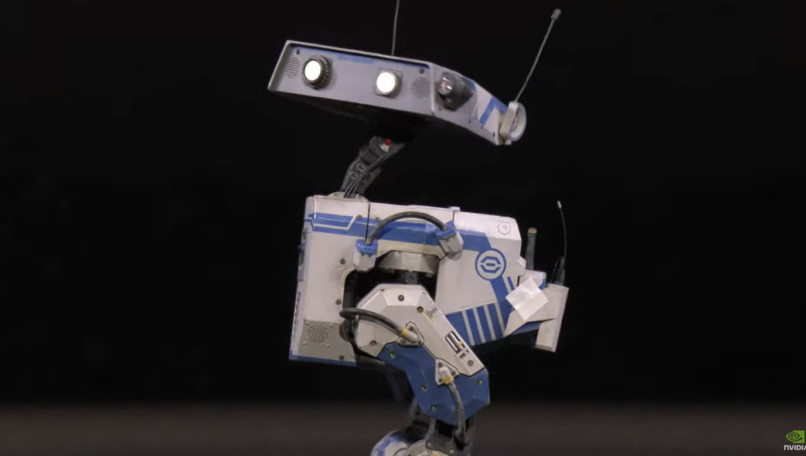
references/45_nvidia_gtc2025_blue_3quarter_side.jpg
