nickthelegend/thenar-duck/references/46_d23_droids_side_walking.jpg

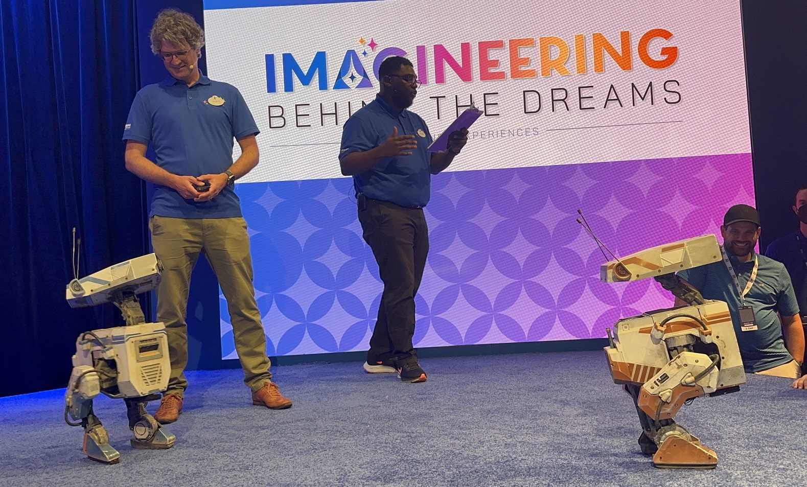
references/46_d23_droids_side_walking.jpg
