nickthelegend/thenar-duck/references/47_techcrunch_gtc2025_jensen_blue_scale.jpg

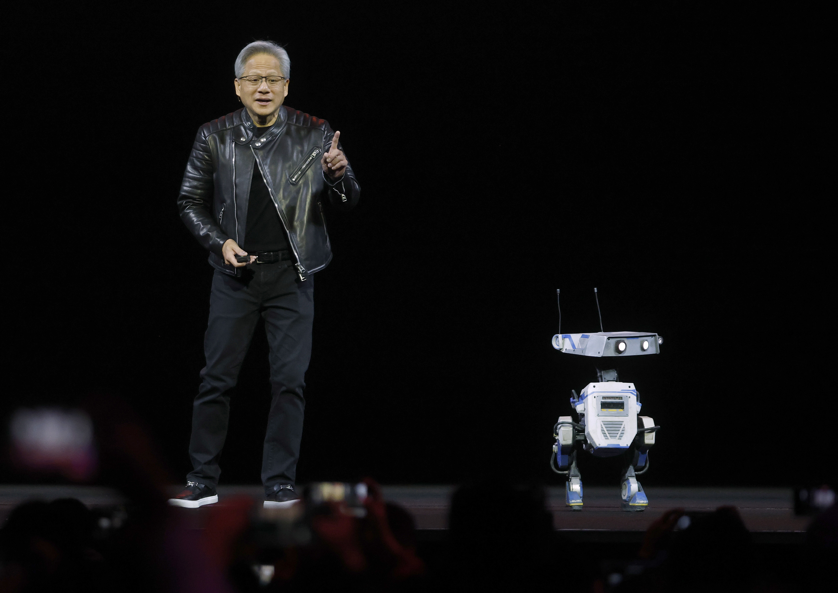
references/47_techcrunch_gtc2025_jensen_blue_scale.jpg
