nickthelegend/thenar-duck/references/50_disneygeek_blue_front_3quarter_high.jpg

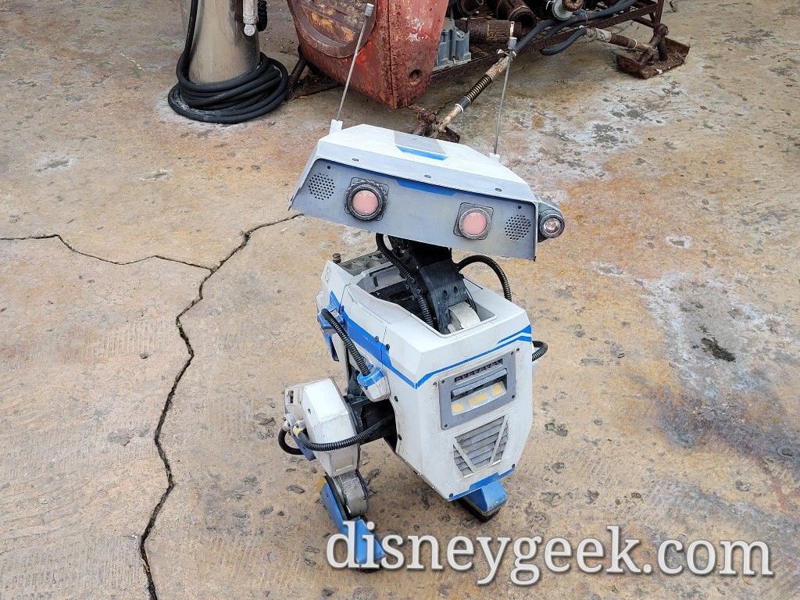
references/50_disneygeek_blue_front_3quarter_high.jpg
