nickthelegend/thenar-duck/references/51_disneygeek_blue_side_3quarter_with_person.jpg

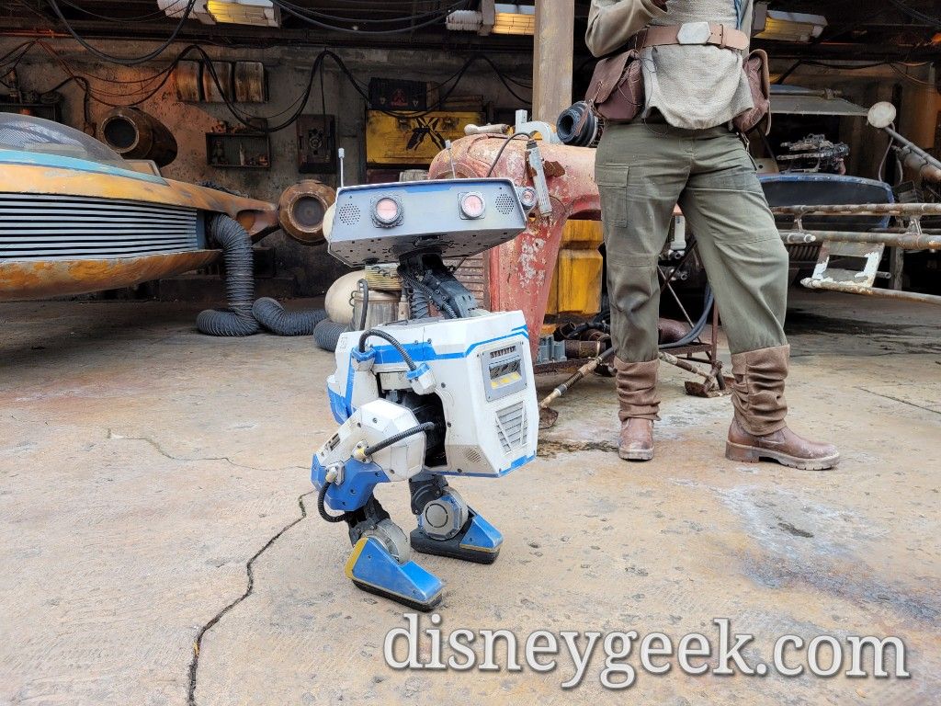
references/51_disneygeek_blue_side_3quarter_with_person.jpg
