nickthelegend/thenar-duck/references/52_disneygeek_blue_3quarter_neck_detail.jpg

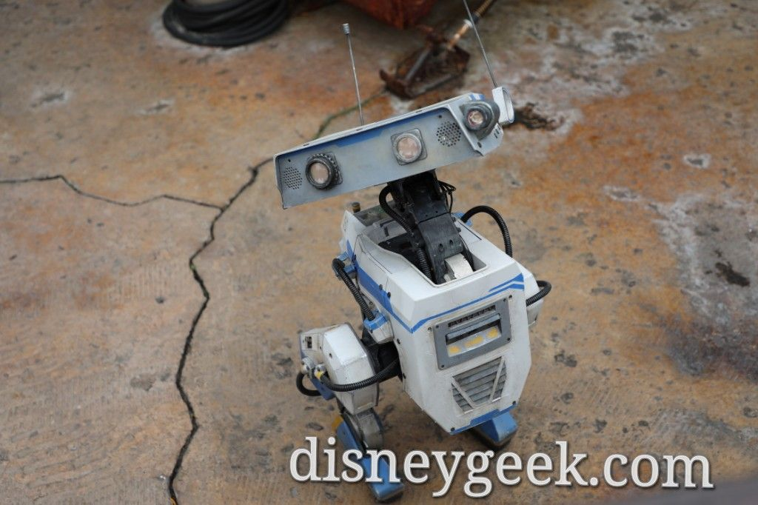
references/52_disneygeek_blue_3quarter_neck_detail.jpg
