nickthelegend/thenar-duck/references/53_disneygeek_head_neck_closeup_front.jpg

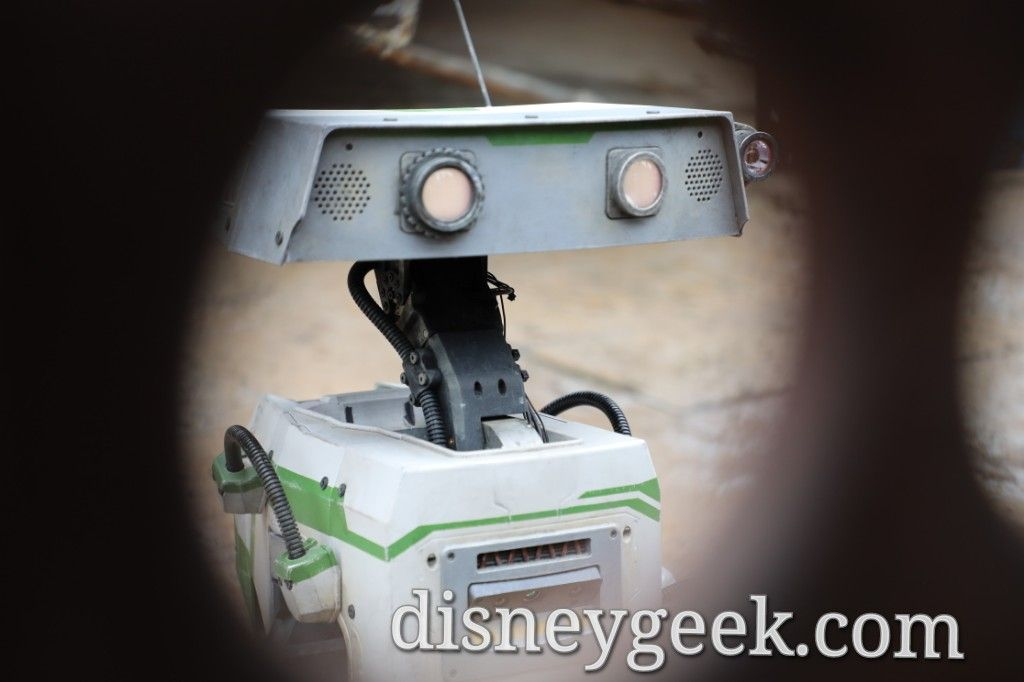
references/53_disneygeek_head_neck_closeup_front.jpg
