nickthelegend/thenar-duck/references/55_disneygeek_blue_side_leg_detail.jpg

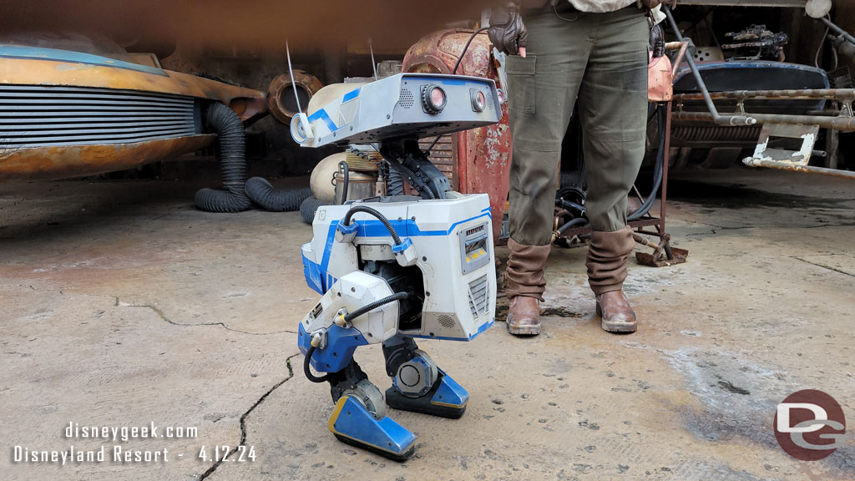
references/55_disneygeek_blue_side_leg_detail.jpg
