nickthelegend/thenar-duck/references/56_disneygeek_blue_side_view_head_turned.jpg

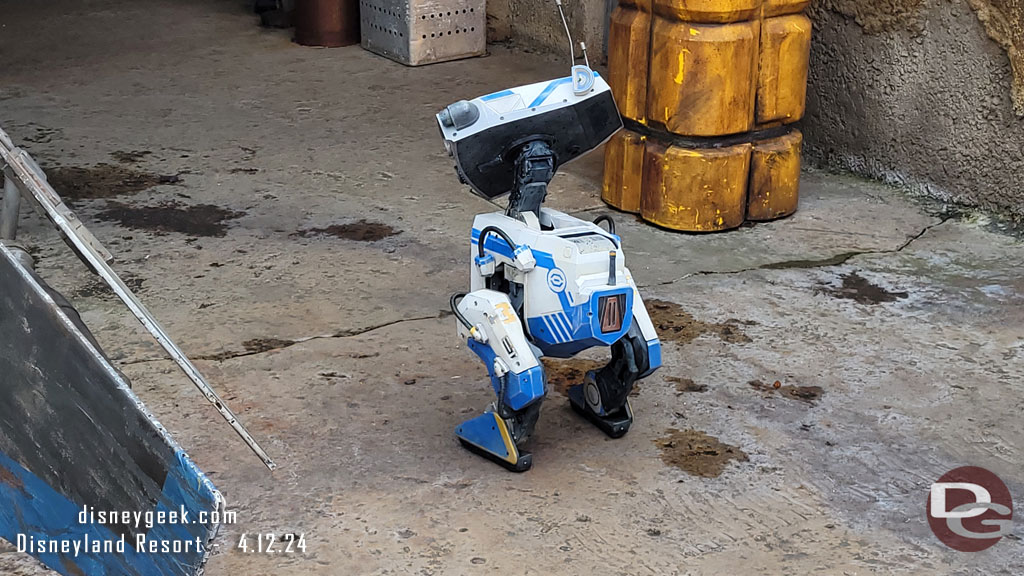
references/56_disneygeek_blue_side_view_head_turned.jpg
