nickthelegend/thenar-duck/references/57_disneygeek_blue_front_from_above.jpg

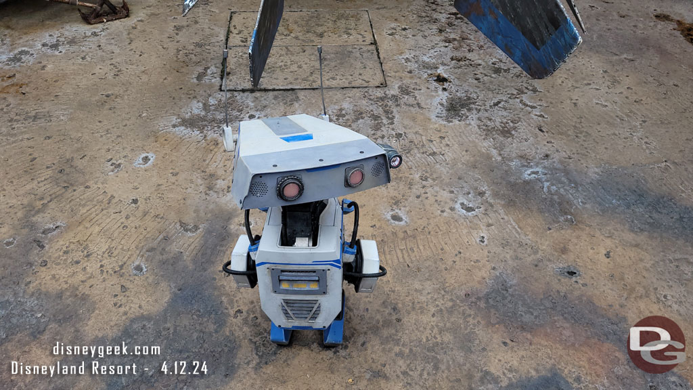
references/57_disneygeek_blue_front_from_above.jpg
