nickthelegend/thenar-duck/references/60_ieee_iros2023_prototype_side_profile.jpg

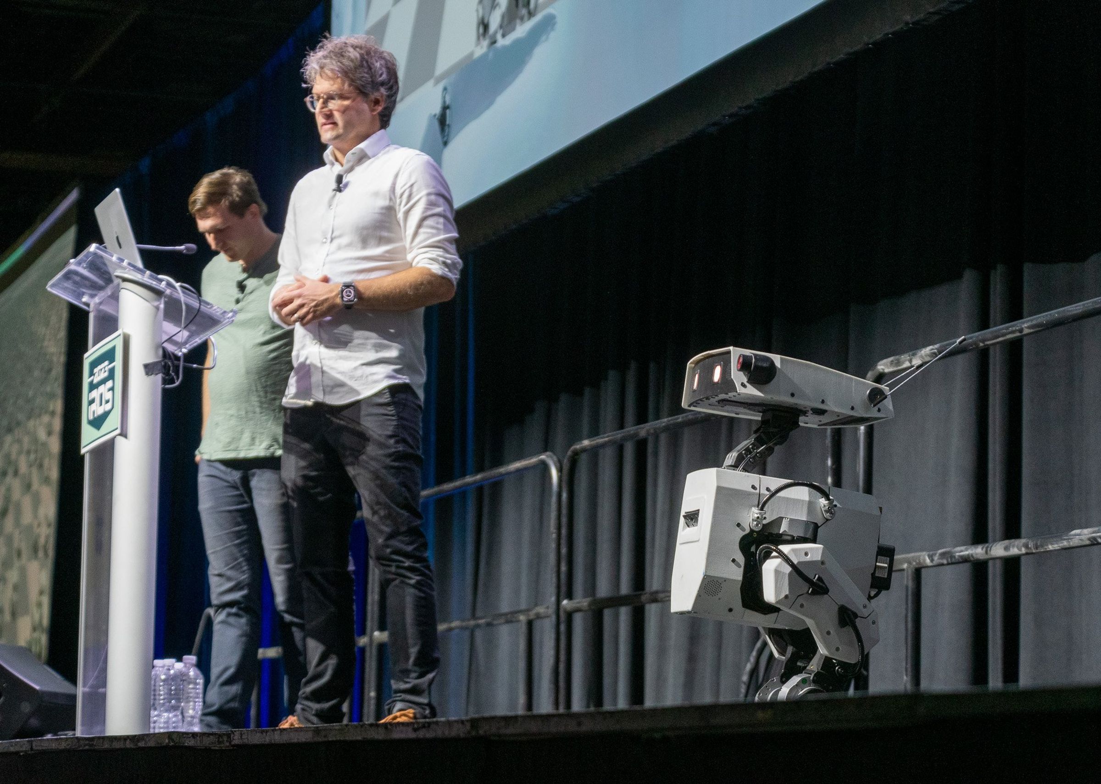
references/60_ieee_iros2023_prototype_side_profile.jpg
