nickthelegend/thenar-duck/references/61_ieee_iros2023_prototype_front_with_team.jpg

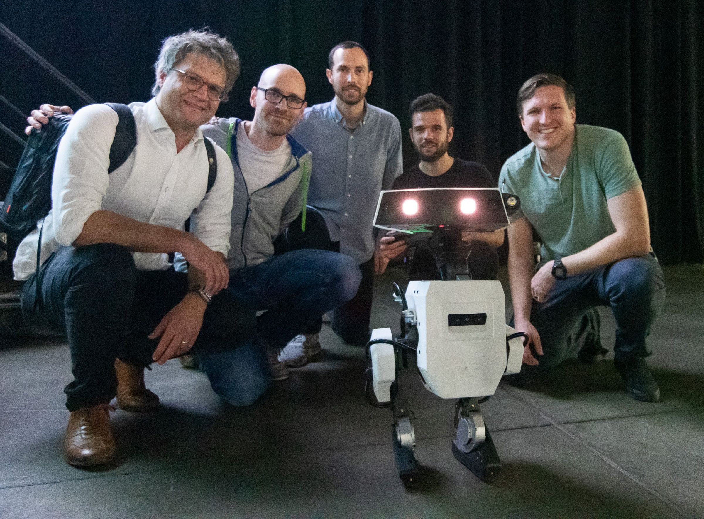
references/61_ieee_iros2023_prototype_front_with_team.jpg
