nickthelegend/thenar-duck/references/62_ieee_iros2023_prototype_front_lowangle.jpg

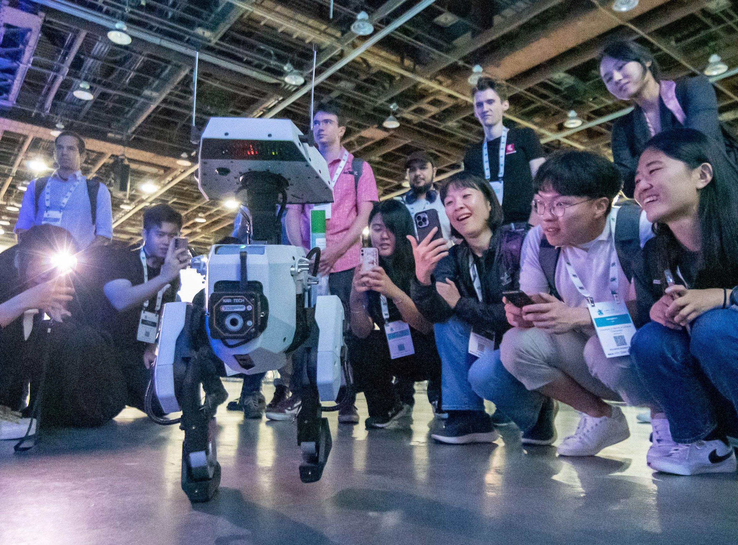
references/62_ieee_iros2023_prototype_front_lowangle.jpg
