nickthelegend/thenar-duck/references/63_ieee_iros2023_prototype_3quarter_with_person.jpg

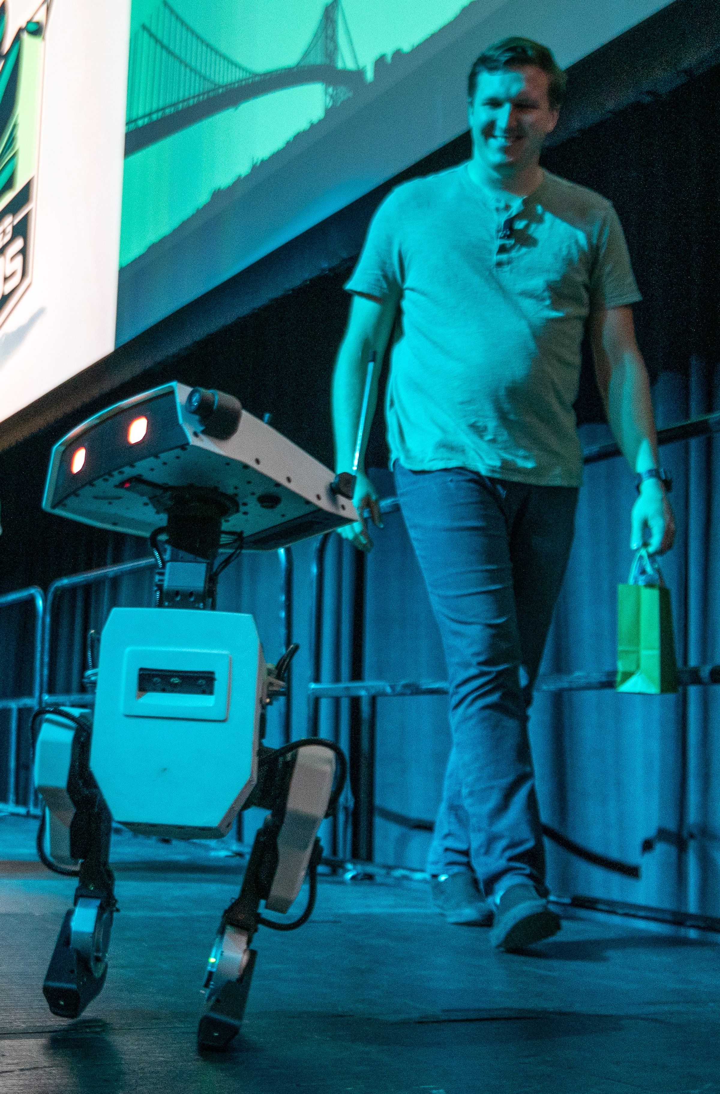
references/63_ieee_iros2023_prototype_3quarter_with_person.jpg
