nickthelegend/thenar-duck/references/64_laughingplace_wdw_side_3quarter_with_person.jpg

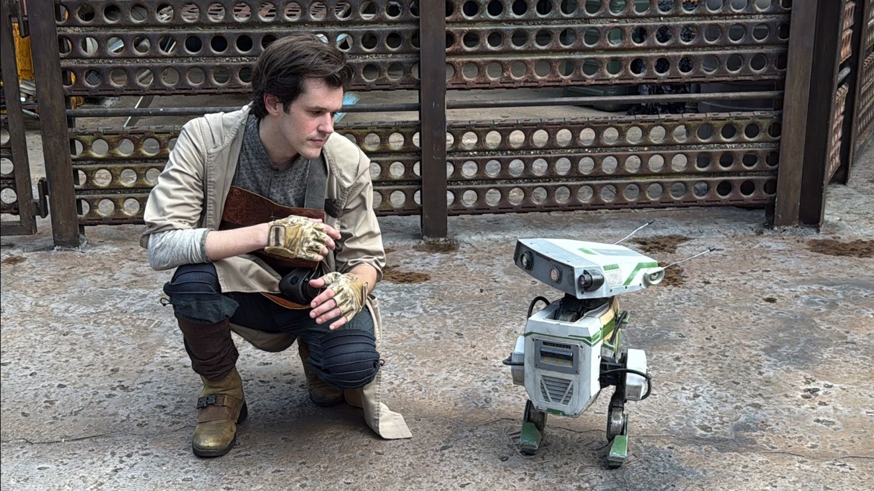
references/64_laughingplace_wdw_side_3quarter_with_person.jpg
