nickthelegend/thenar-duck/references/65_laughingplace_wdw_droids_rear_and_side.jpg

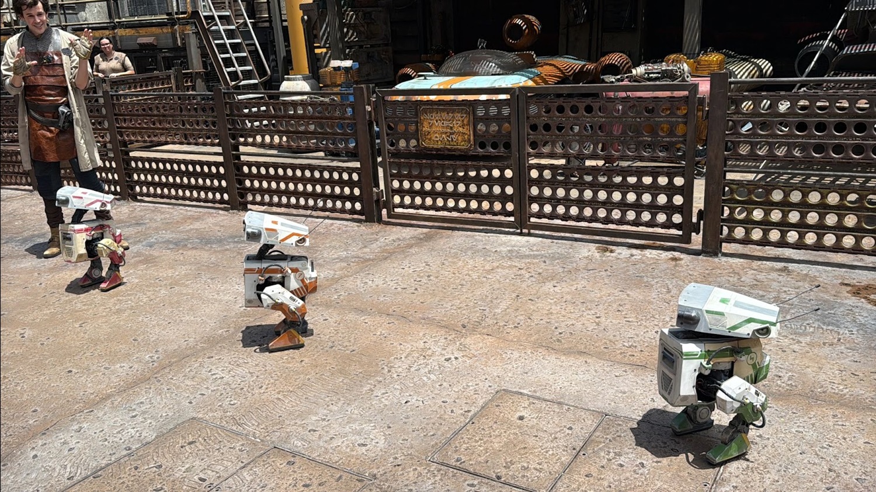
references/65_laughingplace_wdw_droids_rear_and_side.jpg
