nickthelegend/thenar-duck/references/66_laughingplace_wdw_front_with_person.jpg

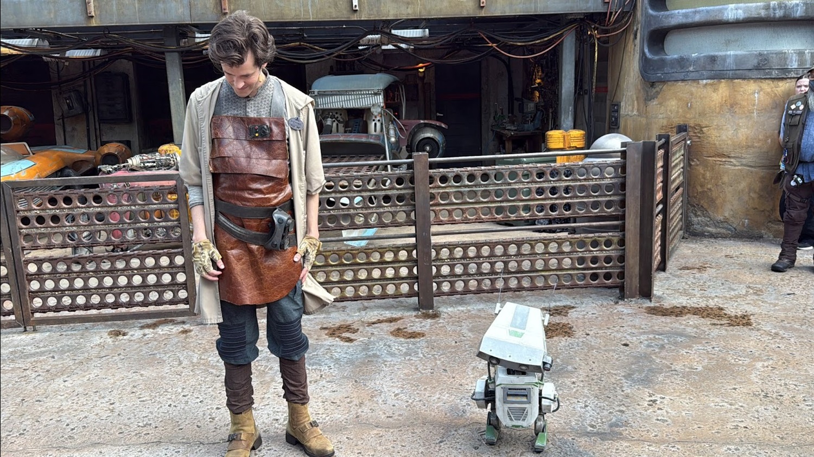
references/66_laughingplace_wdw_front_with_person.jpg
