nickthelegend/thenar-duck/references/67_resortsgal_red_front_straight.jpg

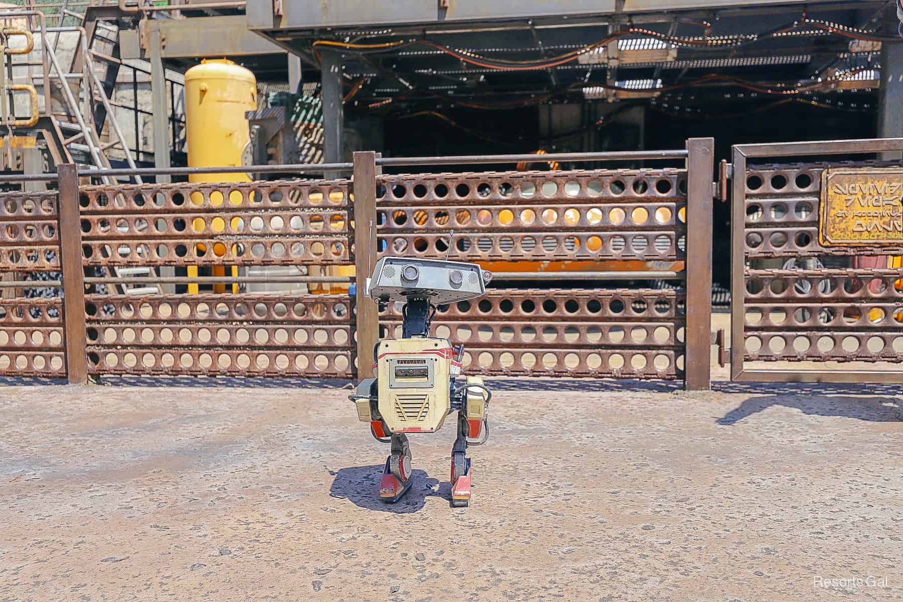
references/67_resortsgal_red_front_straight.jpg
