nickthelegend/thenar-duck/references/68_resortsgal_red_front_with_person_scale.jpg

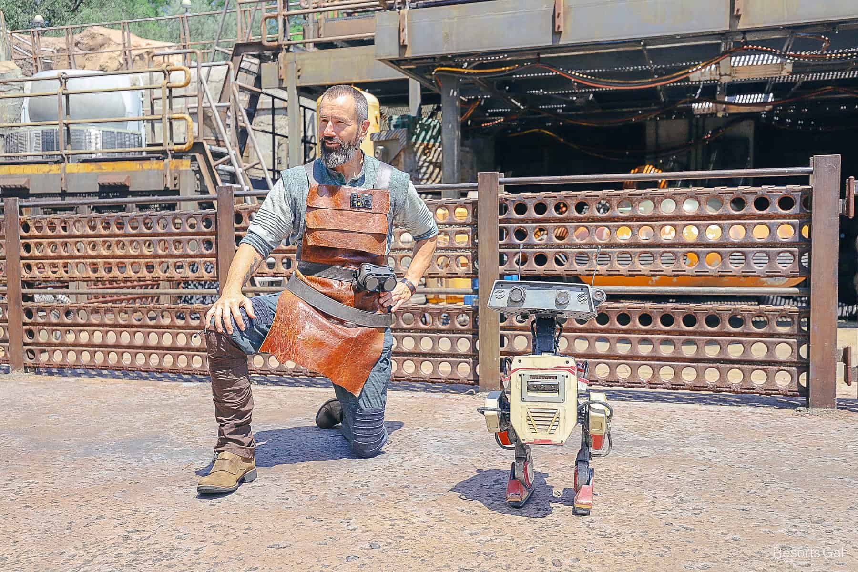
references/68_resortsgal_red_front_with_person_scale.jpg
