nickthelegend/thenar-duck/references/69_resortsgal_orange_green_front_3quarter.jpg

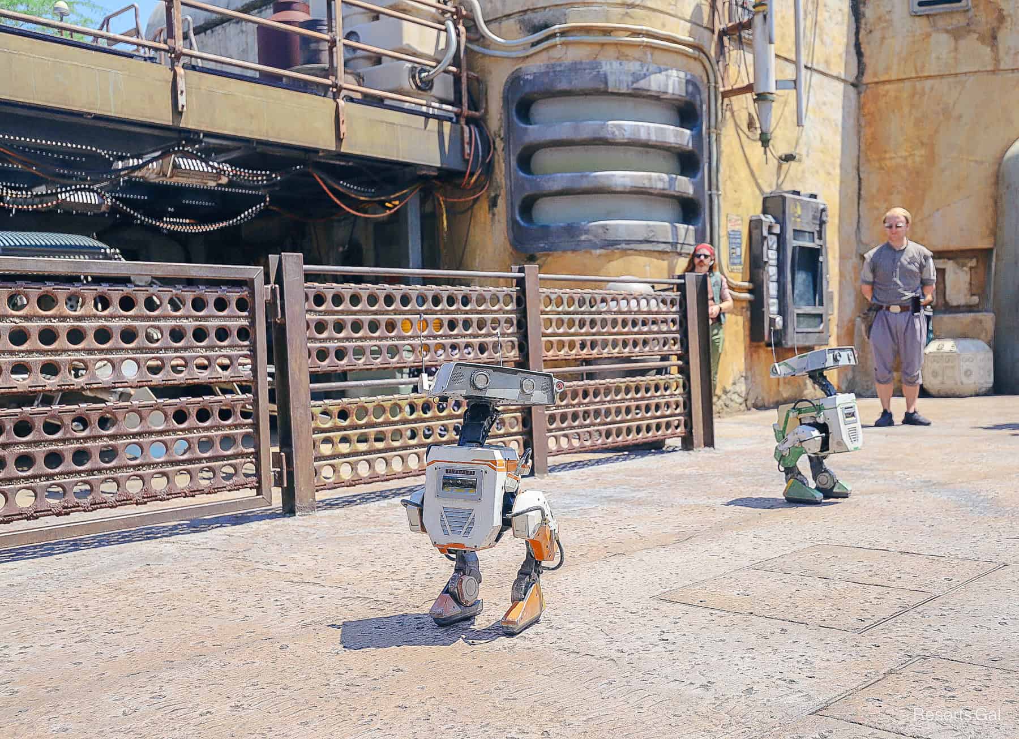
references/69_resortsgal_orange_green_front_3quarter.jpg
