nickthelegend/thenar-duck/references/74_bdxr_physical_prototype.png

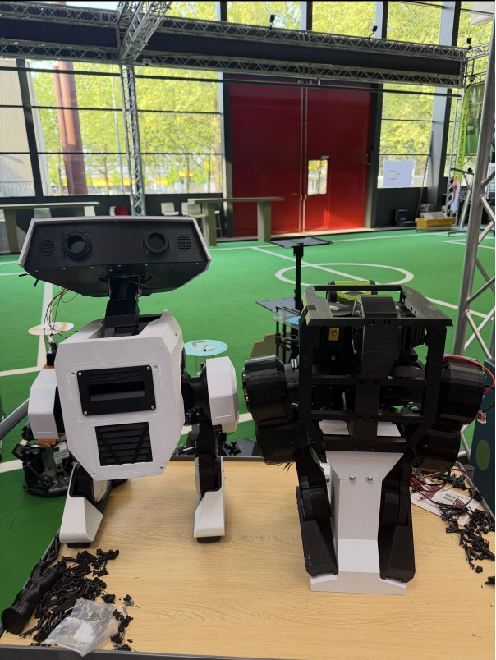
references/74_bdxr_physical_prototype.png
