nickthelegend/thenar-duck/references/video/hires/feet_strip_t08-16_4fps.jpg

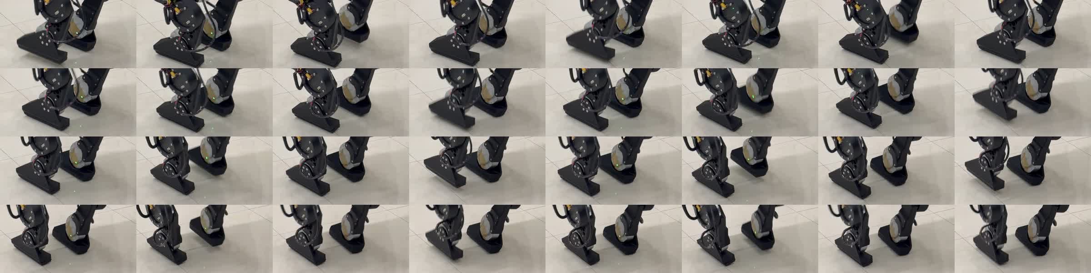
references/video/hires/feet_strip_t08-16_4fps.jpg
