nickthelegend/thenar-duck/references/video/hires/feet_strip_t17-25_4fps.jpg

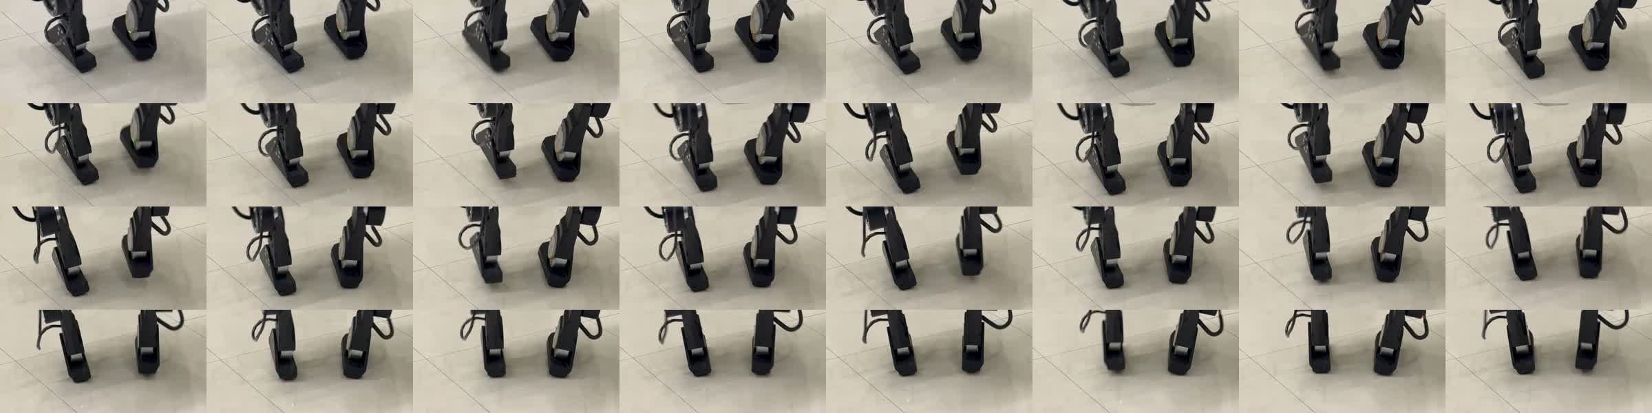
references/video/hires/feet_strip_t17-25_4fps.jpg
