nickthelegend/thenar-duck/references/video/hires/feet_t17-21_4fps_4x4.jpg

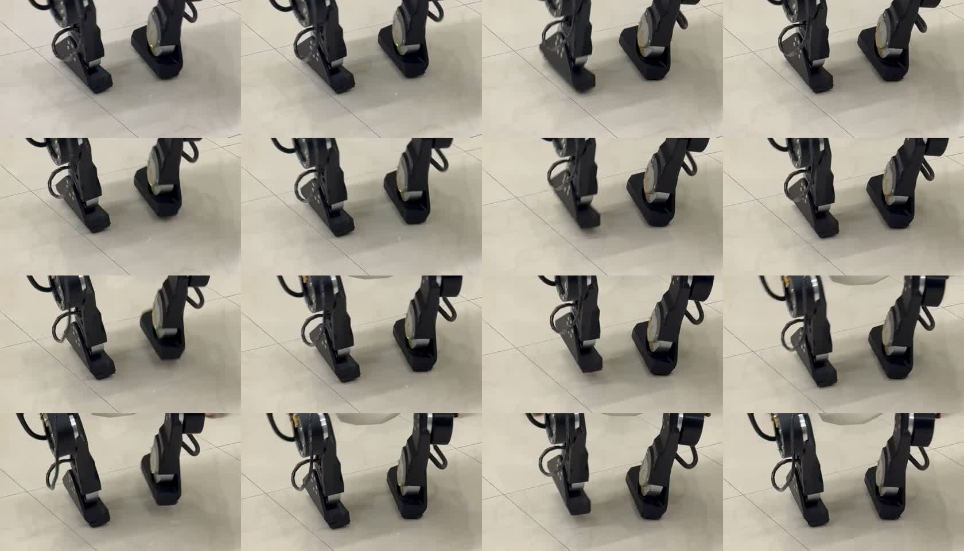
references/video/hires/feet_t17-21_4fps_4x4.jpg
