nickthelegend/thenar-duck/references/video/hires/feet_t21-25_4fps_4x4.jpg

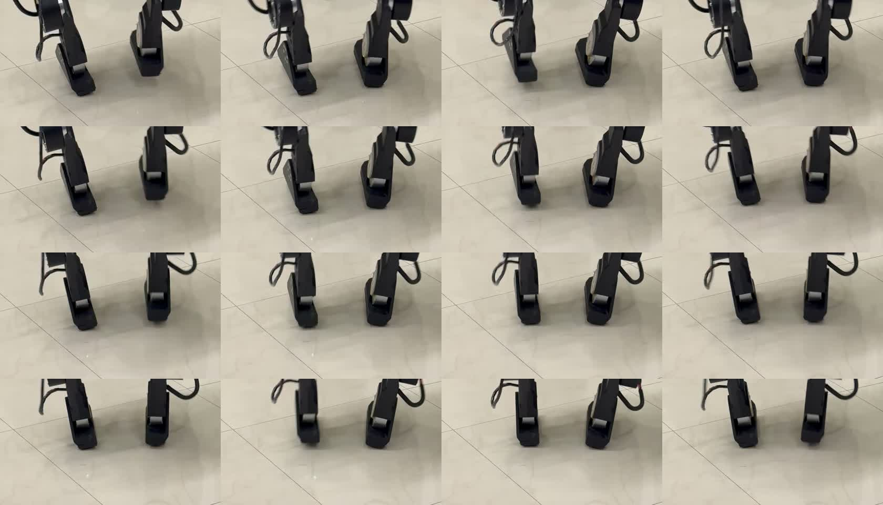
references/video/hires/feet_t21-25_4fps_4x4.jpg
