nickthelegend/thenar-duck/references/video/hires/floor_t00_tiles.jpg

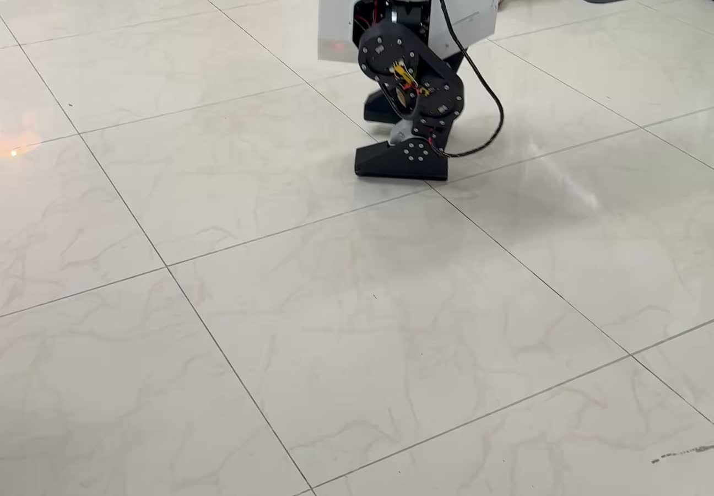
references/video/hires/floor_t00_tiles.jpg
