nickthelegend/thenar-duck/references/video/hires/floor_t00_tiles_grid.jpg

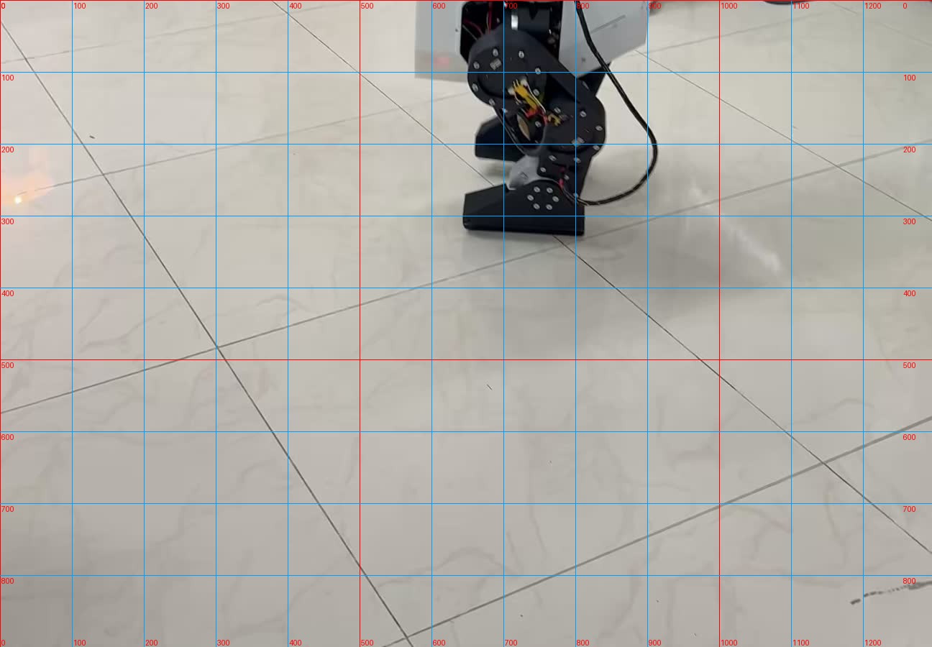
references/video/hires/floor_t00_tiles_grid.jpg
