nickthelegend/thenar-duck/references/video/hires/floor_t24_tiles.jpg

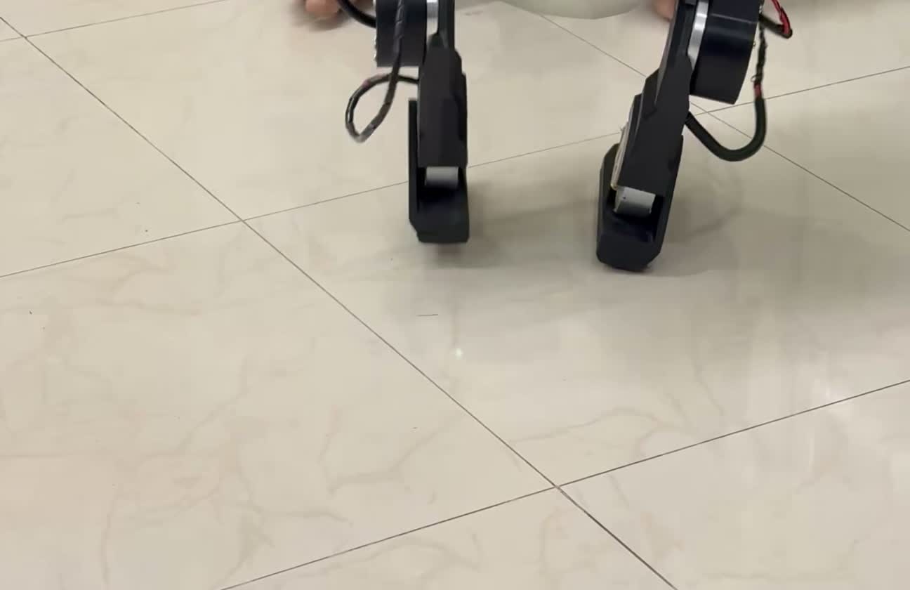
references/video/hires/floor_t24_tiles.jpg
