nickthelegend/thenar-duck/references/video/hires/front_t22_head.jpg

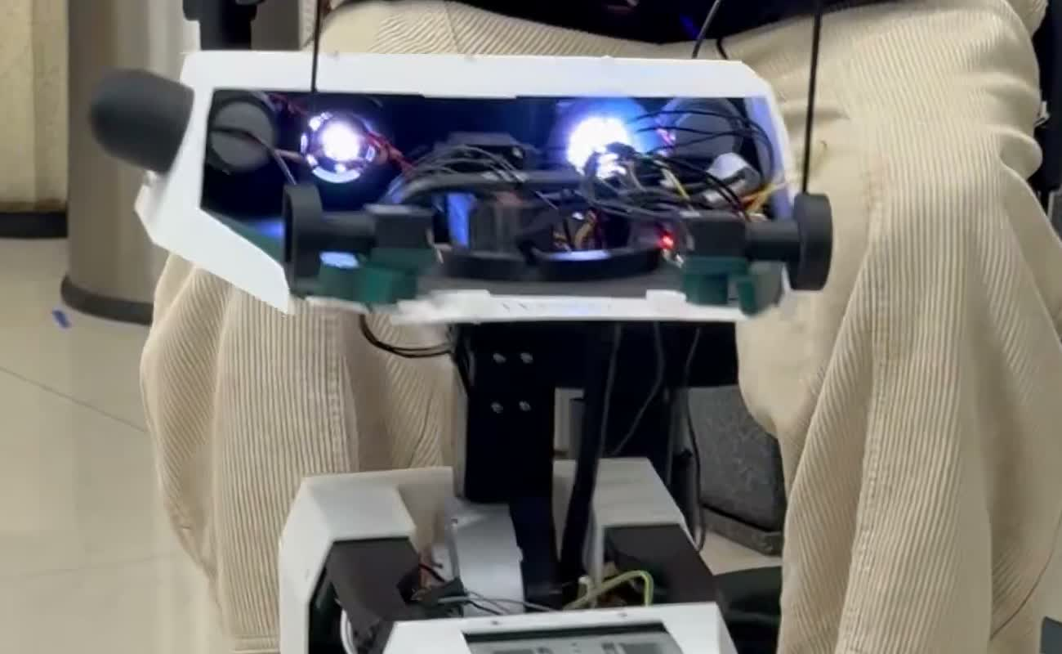
references/video/hires/front_t22_head.jpg
