nickthelegend/thenar-duck/references/video/hires/front_t24_full.jpg

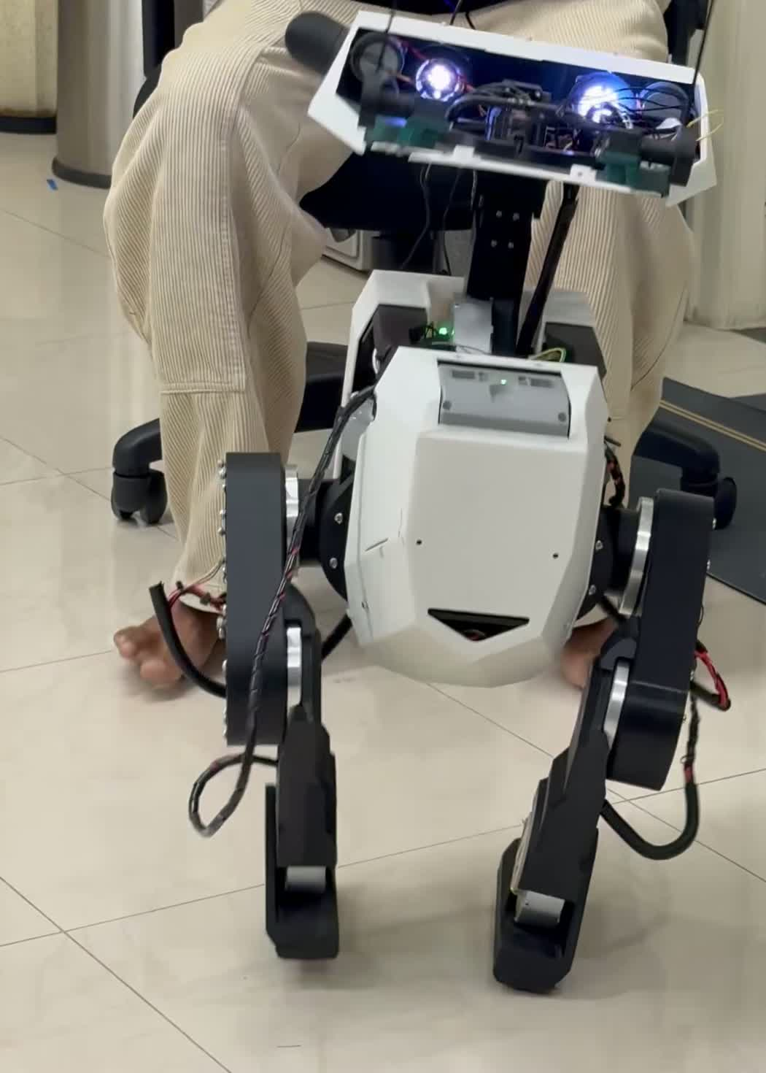
references/video/hires/front_t24_full.jpg
