nickthelegend/thenar-duck/references/video/hires/front_t24_hips.jpg

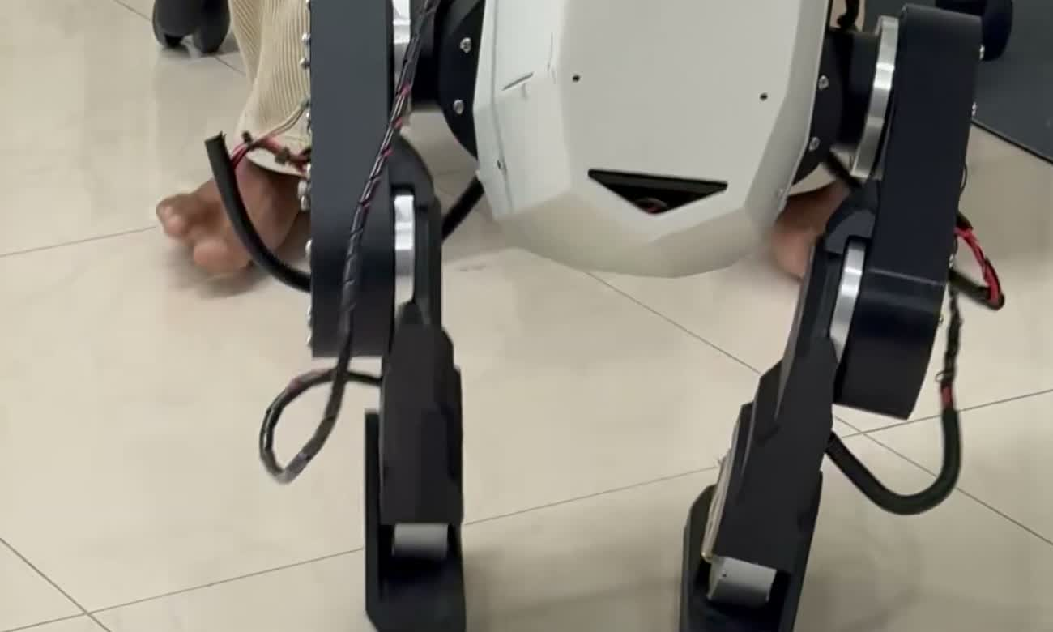
references/video/hires/front_t24_hips.jpg
