nickthelegend/thenar-duck/references/video/hires/gait_sheet_t03-07_6fps.jpg

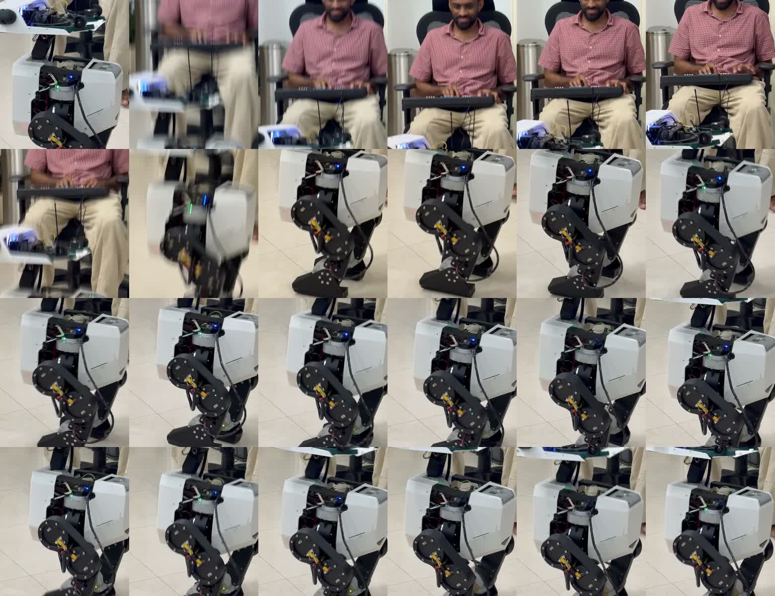
references/video/hires/gait_sheet_t03-07_6fps.jpg
