nickthelegend/thenar-duck/references/video/hires/gait_sheet_t09-13_6fps.jpg

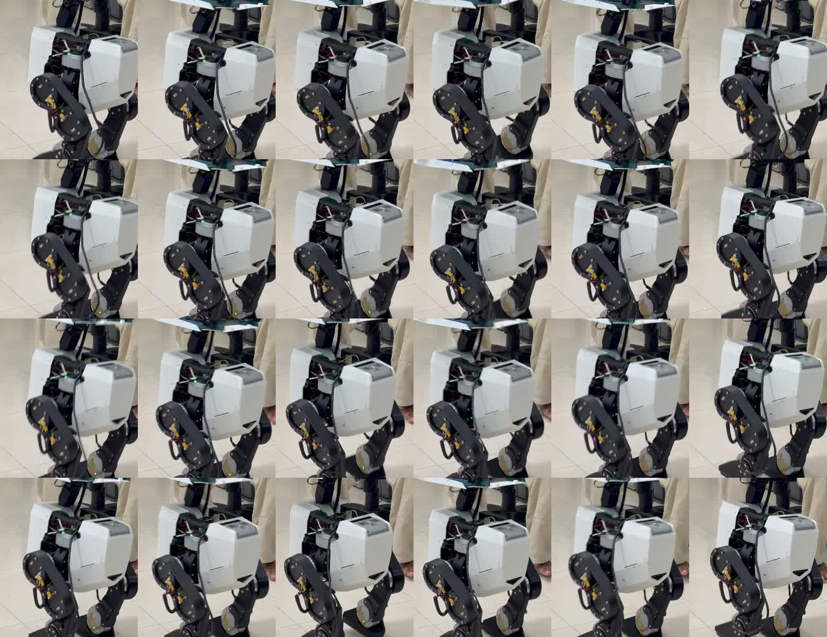
references/video/hires/gait_sheet_t09-13_6fps.jpg
