nickthelegend/thenar-duck/references/video/hires/gait_sheet_t19-23_6fps.jpg

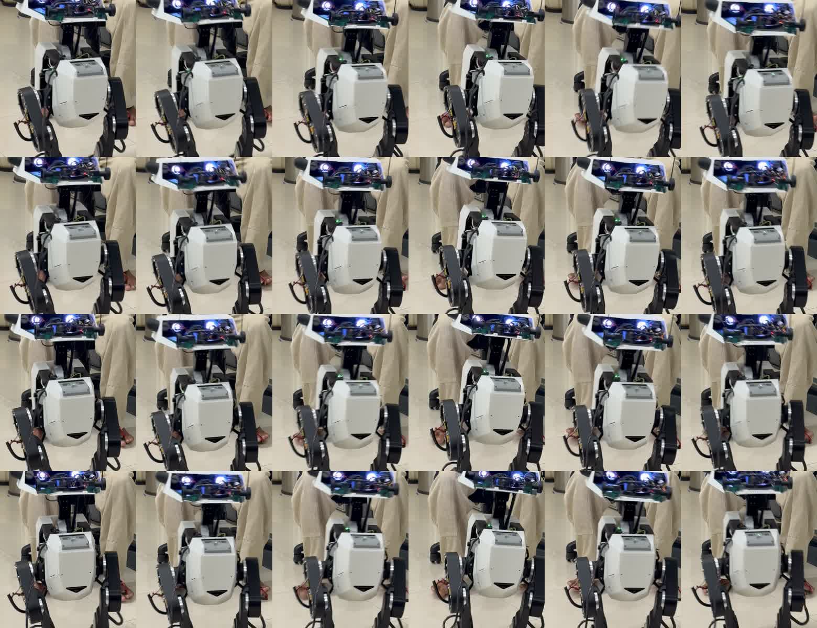
references/video/hires/gait_sheet_t19-23_6fps.jpg
