nickthelegend/thenar-duck/references/video/hires/side_t02_full.jpg

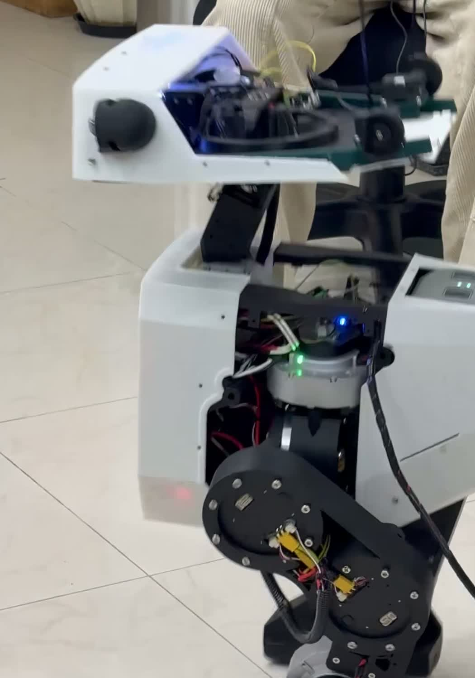
references/video/hires/side_t02_full.jpg
