nickthelegend/thenar-duck/references/video/hires/side_t02_full_grid.jpg

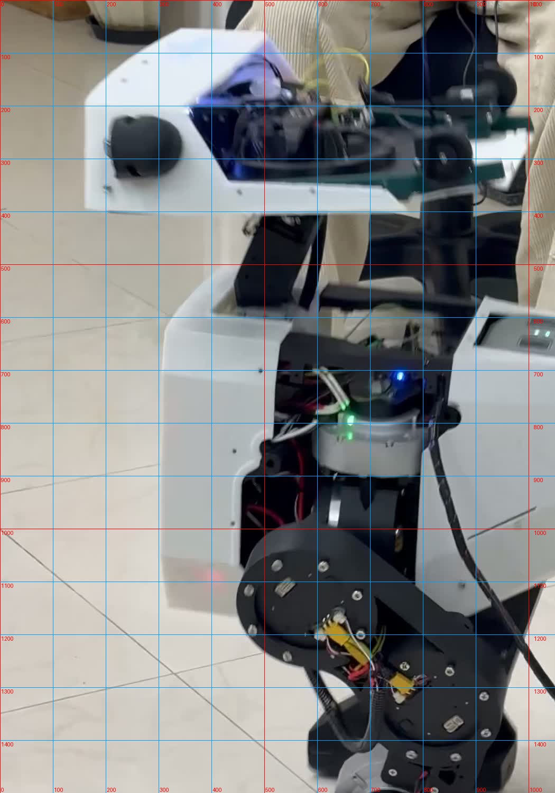
references/video/hires/side_t02_full_grid.jpg
