nickthelegend/thenar-duck/references/video/hires/side_t02_head.jpg

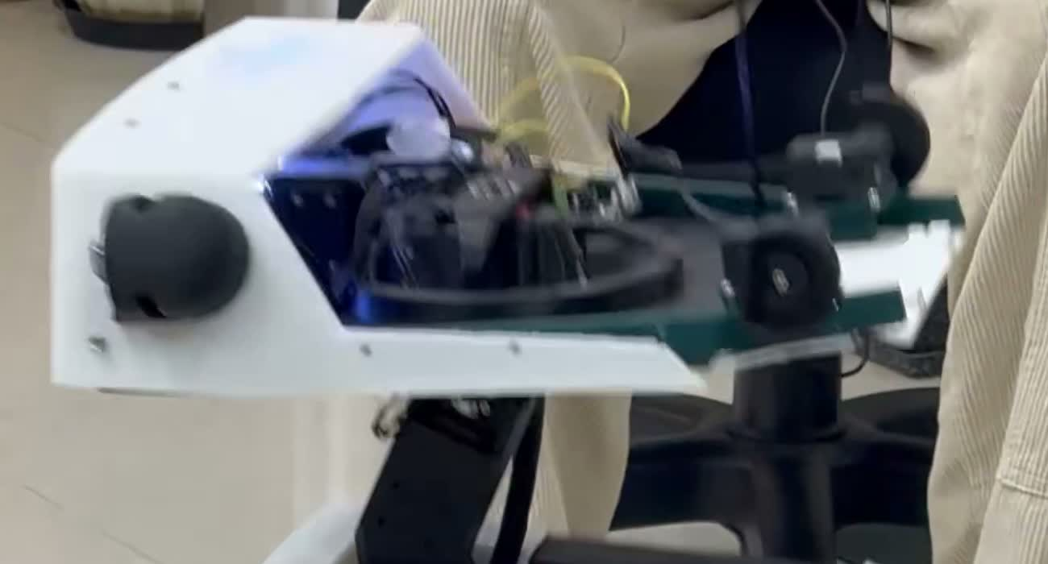
references/video/hires/side_t02_head.jpg
