nickthelegend/thenar-duck/references/video/hires/side_t02_legs.jpg

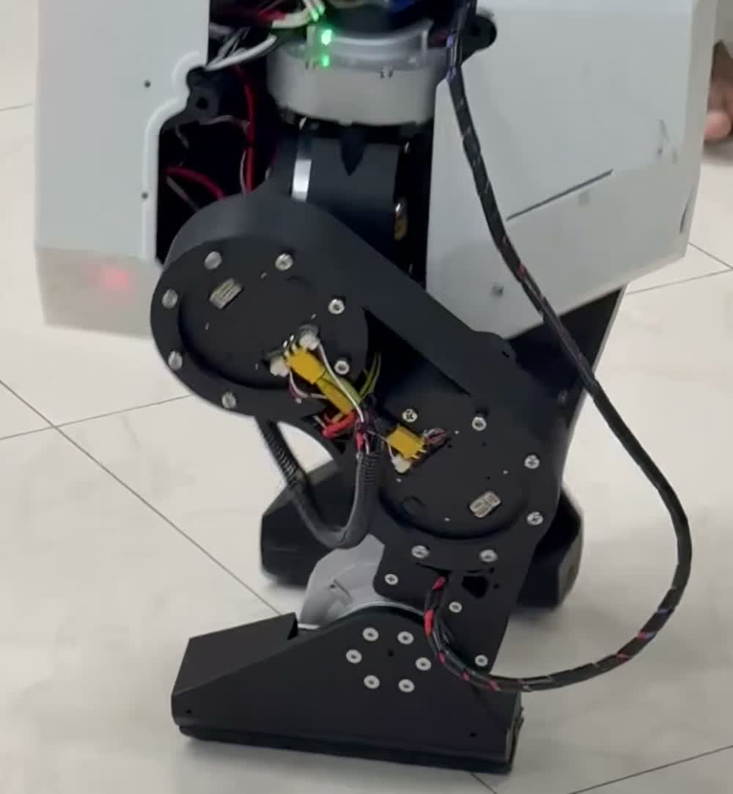
references/video/hires/side_t02_legs.jpg
