nickthelegend/thenar-duck/references/video/hires/side_t12_full.jpg

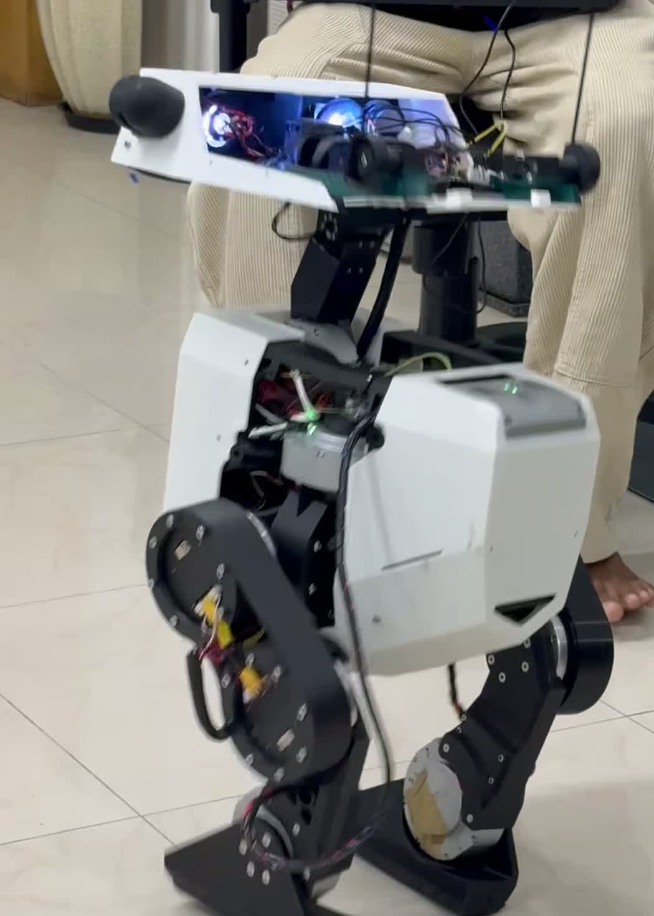
references/video/hires/side_t12_full.jpg
