nickthelegend/thenar-duck/references/video/hires/side_t12_torso_top.jpg

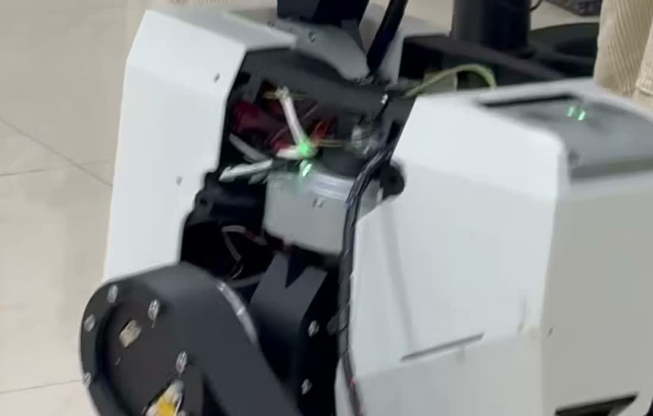
references/video/hires/side_t12_torso_top.jpg
