nickthelegend/thenar-duck/references/video/hires/wide_t00_full.jpg

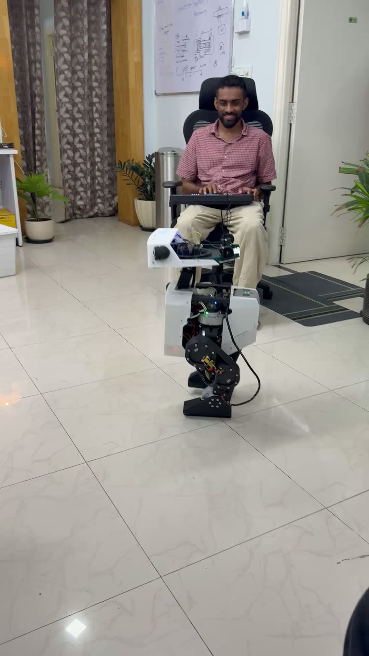
references/video/hires/wide_t00_full.jpg
