nickthelegend/thenar-duck/references/video/watch-5pud_3_0/frames/frame_0035.jpg

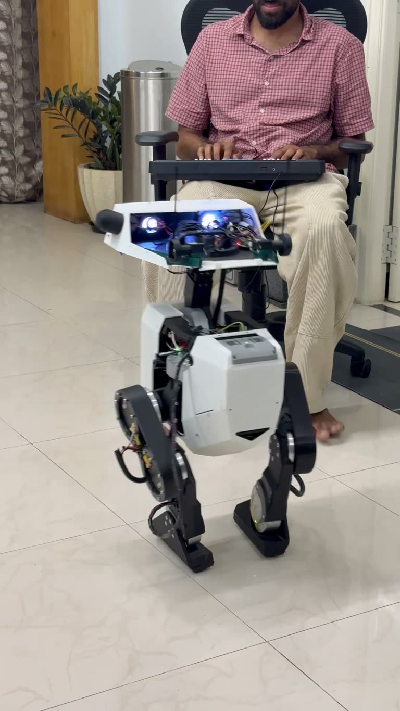
references/video/watch-5pud_3_0/frames/frame_0035.jpg
