nickthelegend/thenar-duck/references/video/watch-5pud_3_0/frames/frame_0049.jpg

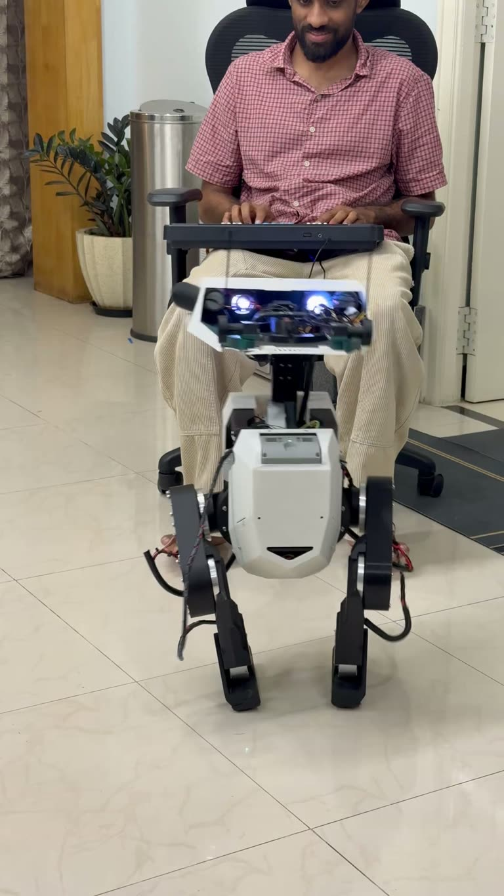
references/video/watch-5pud_3_0/frames/frame_0049.jpg
