nickthelegend/thenar-duck/cad/thenar_duck_B/bambu/plate_manifest.csv

plate | plate_name | object_id | part | copy | role | filament | color | material | x_mm | y_mm | size_mm | orientation | packing_z_rotation | stl_sha256
1 | TEST FIRST - Blue PETG | 2 | C01_M3_insert_and_clearance_coupon | 1 | coupon | 3 | #096DB5 | PETG | 11 | 40 | [105.0, 40.0, 7.0] | CAD print orientation retained | 0 | c7477547602a6bc865a7456252f4aeab1d2e0a74b78becf01c02fac20953a9be
1 | TEST FIRST - Blue PETG | 4 | C03_servo_case_clearance_gauge | 1 | coupon | 3 | #096DB5 | PETG | 128.0 | 40 | [56.0, 36.0, 8.0] | CAD print orientation retained | 0 | 09f48e817d0dad3ef34dd31c54f925aca63a360a8a08916ad1b127571eca0124
1 | TEST FIRST - Blue PETG | 6 | C02_6804_fit_32p0 | 1 | coupon | 3 | #096DB5 | PETG | 11 | 92.0 | [40.0, 40.0, 8.0] | CAD print orientation retained | 0 | 3a479ff3dd3b6f65debc5e3421a9b634e5d86d06771a6586d393708f5f490ef8
1 | TEST FIRST - Blue PETG | 8 | C02_6804_fit_32p1 | 1 | coupon | 3 | #096DB5 | PETG | 63.0 | 92.0 | [40.0, 40.0, 8.0] | CAD print orientation retained | 0 | abbb291a6edbc461a6fe66e4de215919233cf3370ea3215f515f4dccc941d6b7
1 | TEST FIRST - Blue PETG | 10 | C02_6804_fit_32p2 | 1 | coupon | 3 | #096DB5 | PETG | 115.0 | 92.0 | [40.0, 40.0, 8.0] | CAD print orientation retained | 0 | 928e4637960f01cdbd9ba7b42a618098888b02af9a896a71bb2ed3bd01e1f139
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
19 | OPTIONAL - Dark grey PETG | 188 | C06_eye_sleeve_46 | 2 | alternative | 2 | #26333D | PETG | 70.2615 | 99.2615 | [47.2615, 47.5976, 26.0] | CAD print orientation retained | 90 | 7578c715e7617fff90962e826e84aea3c2648f44c1d6bc75a9af67e9051cc1b6
