nickthelegend/thenar-duck/(list of files, cad)

Other CAD files:
cad/microduck/parts/_test_cradle.SLDASM
cad/_test/test.SLDASM
cad/_test/test_asm.SLDASM
cad/thenar_duck_B/solidworks/Thenar_Duck_B_REVIEW.SLDASM
cad/thenar_duck_A/solidworks/Thenar_Duck_A_REVIEW.SLDASM
cad/_test/servo_mock_imported.SLDPRT
cad/development/head_pitch_clean.step
cad/reference_open_duck/mini_bdx/robots/open_duck_mini_v2/neck_left_sheet.stl
cad/reference_open_duck/print/body_front.stl
cad/reference_open_duck/print/mods/v2_Jaimes_Mods/Mini BDX V2 Jaimes Mods.step
cad/thenar_duck_A/hardware/A07_lift_off_roof.stl
cad/thenar_duck_A/solidworks/ST3215_C018_06.SLDPRT
cad/thenar_duck_A/step/A09_power_and_compute_rack.step
cad/thenar_duck_A/Thenar_Duck_A_PRINTED_PARTS.step
cad/thenar_duck_B/bambu/Thenar_Duck_B_P1S_ALL_PARTS.3mf
cad/thenar_duck_B/hardware/Pi4_USB3.step
cad/thenar_duck_B/solidworks/Switch_terminal_reserved_volume.SLDPRT
cad/thenar_duck_B/step/B06b_rocker_19p4x13p2.step
cad/thenar_duck_B/Thenar_Duck_B_PRINTED_PARTS.step
cad/_test/box2.STEP
cad/development/bambu_probe.3mf
cad/microduck/parts/_test_servo_cradle.SLDPRT
cad/reference_open_duck/mini_bdx/robots/open_duck_mini_v2/left_knee_to_ankle_left_sheet.stl
cad/reference_open_duck/print/right_roll_to_pitch.stl
cad/thenar_duck_A/hardware/passive_palonier_2.stl
cad/thenar_duck_A/solidworks/roll_bearing_1.SLDPRT
cad/thenar_duck_A/step/head_pitch_to_yaw_1.step
cad/thenar_duck_B/bambu/Thenar_Duck_B_P1S_ALL_PARTS_source.3mf
cad/thenar_duck_B/hardware/IMU_header_-150.5.step
cad/thenar_duck_B/solidworks/Pi4_GPIO.SLDPRT
cad/thenar_duck_B/step/C02_6804_fit_32p0.step
cad/_test/bracket.SLDPRT
cad/reference_open_duck/mini_bdx/robots/open_duck_mini_v2/roll_motor_bottom.stl
cad/reference_open_duck/print/battery_pack_lid.stl
cad/thenar_duck_A/hardware/left_knee_to_ankle_left_sheet_2.stl
cad/thenar_duck_A/solidworks/Pi4_USB2.SLDPRT
cad/thenar_duck_A/step/A07_lift_off_roof.step
cad/thenar_duck_B/hardware/Battery_rear_connector_keepout.step
cad/thenar_duck_B/solidworks/PDB_component_and_XT60_keepout.SLDPRT
cad/thenar_duck_B/step/B19_PDB_insulating_spacer_1.step
cad/reference_open_duck/mini_bdx/robots/open_duck_mini_v2/battery_pack_lid.stl
cad/reference_open_duck/print/leg_spacer.stl
cad/thenar_duck_A/hardware/leg_spacer_3.stl
cad/thenar_duck_A/solidworks/ST3215_C018_09.SLDPRT
cad/thenar_duck_A/step/foot_bottom_pla_1.step
cad/thenar_duck_B/hardware/ST3215_C018_02.step
cad/thenar_duck_B/solidworks/roll_bearing_2.SLDPRT
cad/thenar_duck_B/step/C05_switch_round_20p2.step
cad/reference_open_duck/mini_bdx/robots/open_duck_mini_v2/body_back.stl
cad/reference_open_duck/print/head_pitch_to_yaw.stl
cad/thenar_duck_A/hardware/Waveshare_Adapter_A_PCB.step
cad/thenar_duck_A/solidworks/ST3215_C018_08.SLDPRT
cad/thenar_duck_A/step/left_knee_to_ankle_left_sheet_4.step
cad/thenar_duck_B/hardware/WS2812_ring_L.step
cad/thenar_duck_B/solidworks/IMU_header_-150.5.SLDPRT
cad/thenar_duck_B/step/left_knee_to_ankle_right_sheet_1.step
cad/_test/servo_mock.STEP
cad/reference_open_duck/mini_bdx/robots/open_duck_mini_v2/left_antenna_holder.stl
cad/reference_open_duck/print/left_roll_to_pitch.stl
cad/thenar_duck_A/hardware/A15_KW10_cassette_L_heel.stl
cad/thenar_duck_A/solidworks/roll_bearing_3.SLDPRT
cad/thenar_duck_A/step/A13_eye_depth_spacer_R.step
cad/thenar_duck_B/hardware/ST3215_C018_03.step
cad/thenar_duck_B/solidworks/PDB_XT60_reference_PCB.SLDPRT
cad/thenar_duck_B/step/A16_switch_cover_L_toe.step
cad/_test/box.STEP
cad/reference_open_duck/mini_bdx/robots/open_duck_mini_v2/bms.stl
cad/reference_open_duck/print/body_middle_top.stl
cad/thenar_duck_A/hardware/roll_bearing_2.step
cad/thenar_duck_A/solidworks/head_bot_sheet_1.SLDPRT
cad/thenar_duck_A/step/left_knee_to_ankle_left_sheet_3.step
cad/thenar_duck_B/hardware/ST3215_C018_14.step
cad/thenar_duck_B/solidworks/WS2812_ring_L.SLDPRT
cad/thenar_duck_B/step/left_knee_to_ankle_right_sheet_2.step
cad/_test/cyl.SLDPRT
cad/reference_open_duck/mini_bdx/robots/open_duck_mini_v2/right_roll_to_pitch.stl
cad/reference_open_duck/print/knee_to_ankle_right_sheet.stl
cad/thenar_duck_A/hardware/A12_eye_retainer_R.stl
cad/thenar_duck_A/solidworks/WS2812_ring_R.SLDPRT
cad/thenar_duck_A/step/left_knee_to_ankle_left_sheet_1.step
cad/thenar_duck_B/hardware/ST3215_C018_06.step
cad/thenar_duck_B/solidworks/Pi4_Ethernet.SLDPRT
cad/thenar_duck_B/step/foot_bottom_pla_2.step
cad/reference_open_duck/mini_bdx/robots/open_duck_mini_v2/left_cache.stl
cad/reference_open_duck/print/roll_motor_top.stl
cad/thenar_duck_A/hardware/ST3215_C018_06.step
cad/thenar_duck_A/solidworks/DFRobot_SEN0374_PCB.SLDPRT
cad/thenar_duck_A/step/A05_rear_service_cover.step
cad/thenar_duck_B/hardware/Switch_terminal_reserved_volume.step
cad/thenar_duck_B/solidworks/WS2812B_2020_pixel.SLDPRT
cad/thenar_duck_B/step/leg_spacer_2.step
cad/reference_open_duck/mini_bdx/robots/open_duck_mini_v2/wj-wk00-0122topcabinetcase_95.stl
cad/reference_open_duck/print/speaker_interface.stl
cad/thenar_duck_A/hardware/ST3215_C018_01.step
cad/thenar_duck_A/solidworks/PDB_MAX_RESERVED.SLDPRT
cad/thenar_duck_A/step/right_roll_to_pitch_1.step
cad/thenar_duck_B/hardware/Status_pixel_required_10x10_carrier.step
cad/thenar_duck_B/solidworks/KW10_R_toe.SLDPRT
cad/thenar_duck_B/step/B02_side_frame_R.step
cad/reference_open_duck/mini_bdx/robots/open_duck_mini_v2/neck_right_sheet.stl
cad/reference_open_duck/print/left_antenna_holder.stl
cad/thenar_duck_A/hardware/wj-wk00-0123middlecase_56_2.stl
cad/thenar_duck_A/solidworks/ST3215_C018_02.SLDPRT
cad/thenar_duck_A/step/A03_side_cover_R.step
cad/thenar_duck_B/hardware/ST3215_C018_07.step
cad/thenar_duck_B/solidworks/Pi4_USB2.SLDPRT
cad/thenar_duck_B/step/foot_side_2.step
cad/reference_open_duck/mini_bdx/robots/open_duck_mini_v2/left_roll_to_pitch.stl
cad/reference_open_duck/print/neck_left_sheet.stl
cad/thenar_duck_A/hardware/ST3215_C018_02.step
cad/thenar_duck_A/solidworks/Pi4_USB_C_power.SLDPRT
cad/thenar_duck_A/step/right_cache_1.step
cad/thenar_duck_B/hardware/BK4200_3S_published_137x44x27.step
cad/thenar_duck_B/solidworks/ST3215_C018_03.SLDPRT
cad/thenar_duck_B/step/C06_eye_sleeve_46.step
cad/reference_open_duck/mini_bdx/robots/open_duck_mini_v2/head_yaw_to_roll.stl
cad/reference_open_duck/print/bulb.stl
cad/thenar_duck_A/hardware/wj-wk00-0122topcabinetcase_95_13.stl
cad/thenar_duck_A/solidworks/KW10_R_heel.SLDPRT
cad/thenar_duck_A/step/leg_spacer_1.step
cad/thenar_duck_B/hardware/Pi4_USB_C_power.step
cad/thenar_duck_B/solidworks/ST3215_C018_05.SLDPRT
cad/thenar_duck_B/step/left_knee_to_ankle_left_sheet_4.step
cad/reference_open_duck/mini_bdx/robots/open_duck_mini_v2/body_front.stl
cad/reference_open_duck/print/right_antenna_holder.stl
cad/thenar_duck_A/hardware/drive_palonier_8.stl
cad/thenar_duck_A/solidworks/KW10_R_toe.SLDPRT
cad/thenar_duck_A/step/left_roll_to_pitch_1.step
cad/thenar_duck_B/hardware/Pi4_Ethernet.step
cad/thenar_duck_B/step/B24_status_pixel_carrier.step
cad/reference_open_duck/mini_bdx/robots/open_duck_mini_v2/trunk_top.stl
cad/reference_open_duck/print/foot_bottom_tpu.stl
cad/thenar_duck_A/hardware/neck_right_sheet_1.stl
cad/thenar_duck_A/solidworks/FUSE_HOLDER_MAX_RESERVED.SLDPRT
cad/thenar_duck_A/step/C02_6804_fit_32p1.step
cad/thenar_duck_B/hardware/WS2812_matrix_PCB_30mm_example.step
cad/thenar_duck_B/solidworks/ST3215_C018_02.SLDPRT
cad/thenar_duck_B/step/trunk_bottom_1.step
cad/reference_open_duck/mini_bdx/robots/open_duck_mini_v2/roll_motor_top.stl
cad/reference_open_duck/print/head_bot_sheet.stl
cad/thenar_duck_A/hardware/foot_side_2.stl
cad/thenar_duck_A/solidworks/Pi4_GPIO.SLDPRT
cad/thenar_duck_A/step/C01_M3_insert_and_clearance_coupon.step
cad/thenar_duck_B/hardware/Adapter_components_envelope.step
cad/thenar_duck_B/solidworks/roll_bearing_1.SLDPRT
cad/thenar_duck_B/step/B11_SEN0374_side_bridge.step
cad/reference_open_duck/mini_bdx/robots/open_duck_mini_v2/sg90.stl
cad/reference_open_duck/print/knee_to_ankle_left_sheet.stl
cad/thenar_duck_A/hardware/A10_Pi4B_removable_tray.stl
cad/thenar_duck_A/solidworks/ST3215_C018_04.SLDPRT
cad/_test/box.SLDPRT
cad/_test/cyl.STL
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
