nickthelegend/thenar-duck/cad/thenar_duck_A/renders/01_assembled.png

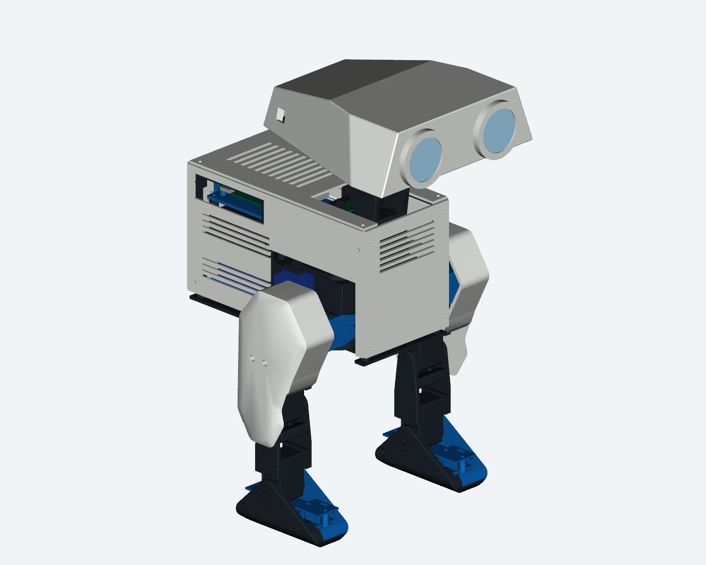
cad/thenar_duck_A/renders/01_assembled.png
