nickthelegend/thenar-duck/cad/_test/asm.png

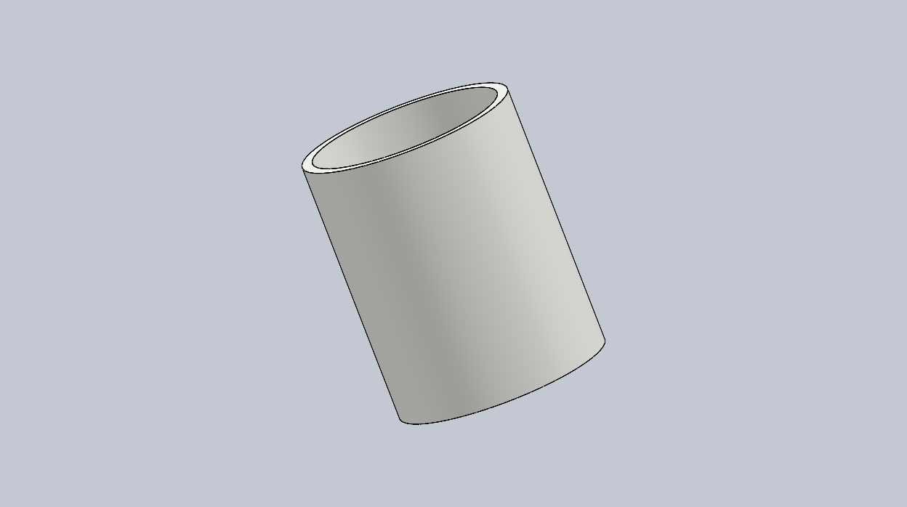
cad/_test/asm.png
