nickthelegend/thenar-duck/cad/_test/box.png

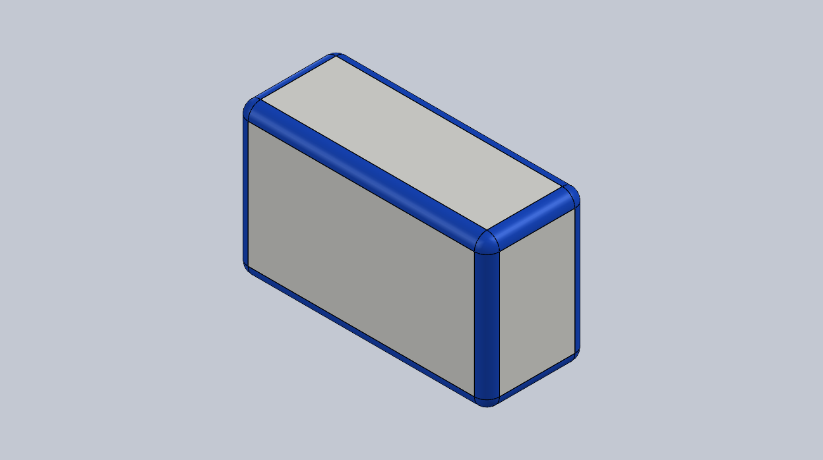
cad/_test/box.png
