nickthelegend/thenar-duck/cad/_test/bracket.png

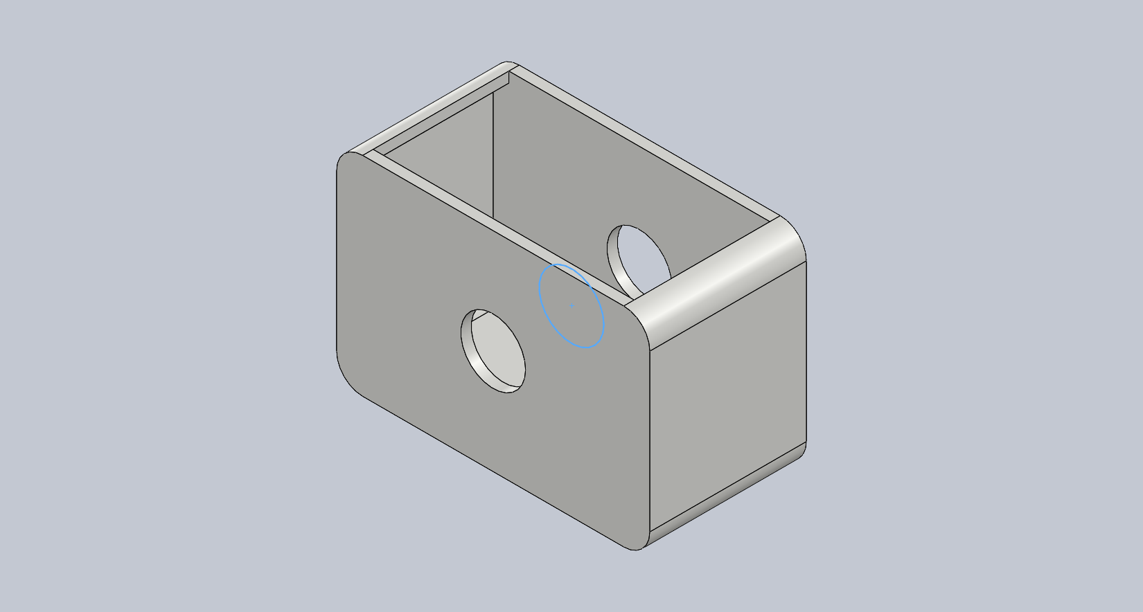
cad/_test/bracket.png
