nickthelegend/thenar-duck/cad/_test/servo_mock.png

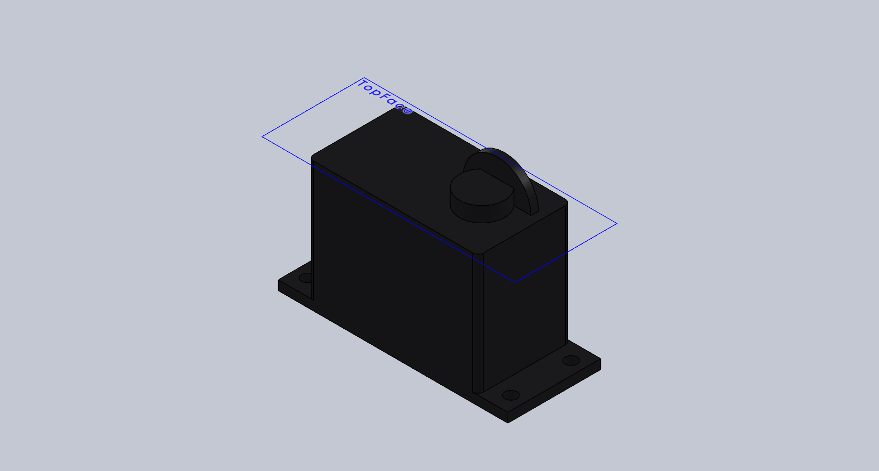
cad/_test/servo_mock.png
