nickthelegend/thenar-duck/cad/_test/test_asm.png

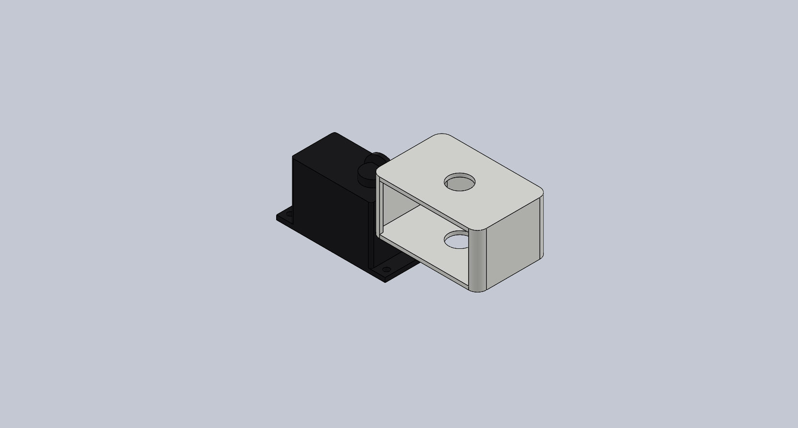
cad/_test/test_asm.png
