nickthelegend/thenar-duck/cad/_test/test_asm_mated.png

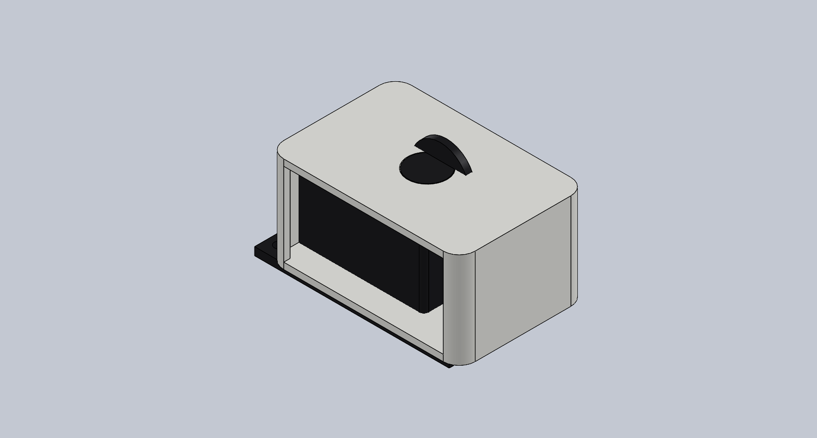
cad/_test/test_asm_mated.png
