nickthelegend/thenar-duck/cad/microduck/renders/_test_cradle_asm.png

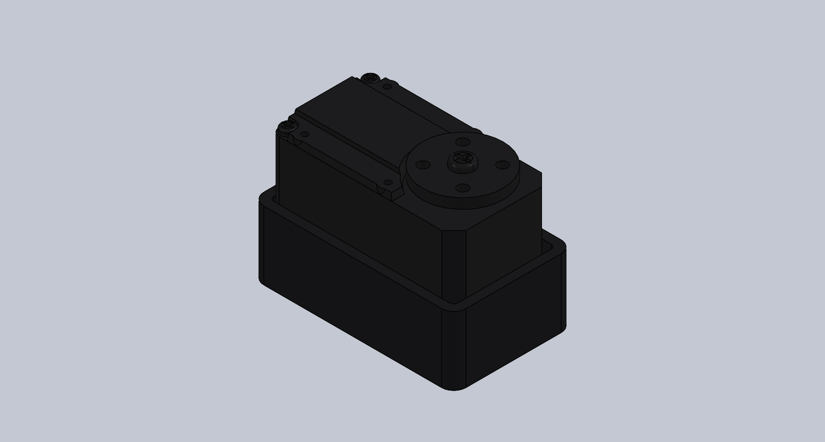
cad/microduck/renders/_test_cradle_asm.png
