nickthelegend/thenar-duck/cad/microduck/renders/_test_servo_cradle_isometric.png

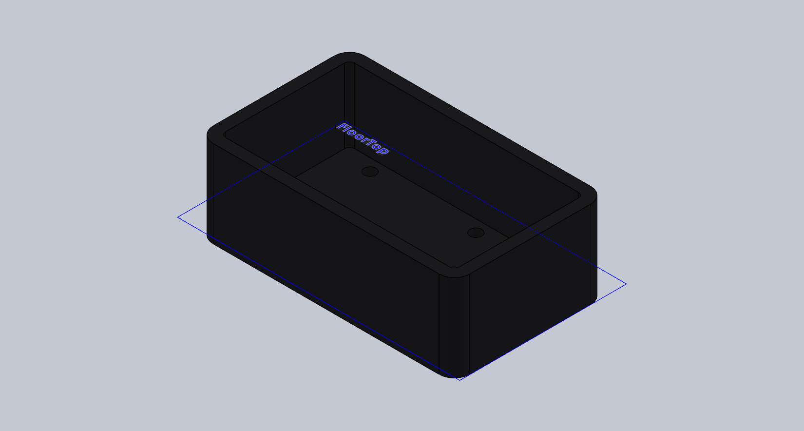
cad/microduck/renders/_test_servo_cradle_isometric.png
