nickthelegend/thenar-duck/cad/reference_open_duck/mini_bdx/robots/open_duck_mini_v2/robot.urdf

<robot name="onshape">
    <mujoco>
        <compiler fusestatic="false"/>
    </mujoco>
    <link name="trunk_assembly">
        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
        <inertial>
            <origin xyz="-0.048325895233303065024 -9.9782299489528555577e-05 0.038497067106456790697" rpy="0 0 0"/>
            <mass value="0.69852641931996084512" />
            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
        </inertial>
    </link>
    <link name="trunk">
        <inertial>
            <origin xyz="0 0 0" rpy="0 0 0" />
            <mass value="1e-9" />
            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
        </inertial>
    </link>
    <joint name="trunk_frame" type="fixed">
        <origin xyz="-0.024000000000000760308 -2.4112656316077618612e-16 0.088190938812376745704" rpy="-1.4062102177136726269e-16 -9.4252837597218562265e-17 7.8061435390716270015e-33" />
        <parent link="trunk_assembly" />
        <child link="trunk" />
        <axis xyz="0 0 0"/>
    </joint>
    <link name="hip_roll_assembly">
        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
        <inertial>
            <origin xyz="0.00079508052674466121908 -5.4654095770169530693e-06 -0.033060020136905461652" rpy="0 0 0"/>
            <mass value="0.06648000000000005294" />
            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
        </inertial>
    </link>
    <link name="left_roll_to_pitch_assembly">
        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
        <inertial>
            <origin xyz="0.050804245437506757865 -0.00041104958524988720932 0.020470437421083776536" rpy="0 0 0"/>
            <mass value="0.075160000000000060094" />
            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
        </inertial>
    </link>
    <link name="knee_and_ankle_assembly">
        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
        <inertial>
            <origin xyz="0.0025336932086845848598 -0.039063625582320897489 0.010277553221843004072" rpy="0 0 0"/>
            <mass value="0.12407000000000001361" />
            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
        </inertial>
    </link>
    <link name="knee_and_ankle_assembly_2">
        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
        <inertial>
            <origin xyz="5.0185935256645920267e-06 -0.057746501775911777965 0.018113576234400546872" rpy="0 0 0"/>
            <mass value="0.072590000000000057256" />
            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
        </inertial>
    </link>
    <link name="foot_assembly">
        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
        <inertial>
            <origin xyz="0.011071805405810810838 -0.024660828914054331445 0.019062631505101720886" rpy="0 0 0"/>
            <mass value="0.075240000000000001323" />
            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
        </inertial>
    </link>
    <link name="left_foot">
        <inertial>
            <origin xyz="0 0 0" rpy="0 0 0" />
            <mass value="1e-9" />
            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
        </inertial>
    </link>
    <joint name="left_foot_frame" type="fixed">
        <origin xyz="0.00049999999999996574962 -0.036224999999999729638 0.01955000000000034488" rpy="-1.570796326794896558 4.8789097742003279458e-18 8.5828066488045564267e-28" />
        <parent link="foot_assembly" />
        <child link="left_foot" />
        <axis xyz="0 0 0"/>
    </joint>
    <joint name="left_ankle" type="revolute">
        <origin xyz="-3.4694469519536141888e-17 -0.078650000000000178102 9.99999999999751088e-05" rpy="-2.6413756774523519415e-16 1.2220841311108591179e-26 2.7755576181993178136e-17" />
        <parent link="knee_and_ankle_assembly_2" />
        <child link="foot_assembly" />
        <axis xyz="0 0 1"/>
        <limit effort="1" velocity="20" lower="-1.570796326794896558" upper="1.570796326794896558"/>
        <joint_properties friction="0.0"/>
    </joint>
    <joint name="left_knee" type="revolute">
        <origin xyz="1.3877787807814456755e-17 -0.078650000000000011569 9.9999999999961231012e-05" rpy="-2.6413756781799972404e-16 -2.7339812777890022088e-26 0" />
        <parent link="knee_and_ankle_assembly" />
        <child link="knee_and_ankle_assembly_2" />
        <axis xyz="0 0 1"/>
        <limit effort="1" velocity="20" lower="-1.570796326794896558" upper="1.570796326794896558"/>
        <joint_properties friction="0.0"/>
    </joint>
    <joint name="left_hip_pitch" type="revolute">
        <origin xyz="0.074149999999999799405 1.3959102970750869588e-18 0.035109999999999912113" rpy="3.141592653589793116 1.5707963267948952257 0" />
        <parent link="left_roll_to_pitch_assembly" />
        <child link="knee_and_ankle_assembly" />
        <axis xyz="0 0 1"/>
        <limit effort="1" velocity="20" lower="-1.2217304763960306069" upper="0.52359877559829881566"/>
        <joint_properties friction="0.0"/>
    </joint>
    <joint name="left_hip_roll" type="revolute">
        <origin xyz="0.019050000000003241424 2.0469737016526323714e-15 -0.046015000000000895464" rpy="-1.5707963267949442976 1.0251581517556108667e-13 1.5707963267946023489" />
        <parent link="hip_roll_assembly" />
        <child link="left_roll_to_pitch_assembly" />
        <axis xyz="0 0 1"/>
        <limit effort="1" velocity="20" lower="-0.43633231299858238339" upper="0.43633231299858238339"/>
        <joint_properties friction="0.0"/>
    </joint>
    <joint name="left_hip_yaw" type="revolute">
        <origin xyz="-0.019000000000000290962 0.035000000000001273148 0.045940938812378845357" rpy="-2.0757017677015319346e-16 -2.1982415887547258194e-14 -7.6136910267405882653e-27" />
        <parent link="trunk_assembly" />
        <child link="hip_roll_assembly" />
        <axis xyz="0 0 1"/>
        <limit effort="1" velocity="20" lower="-0.52359877559829881566" upper="0.52359877559829881566"/>
        <joint_properties friction="0.0"/>
    </joint>
    <link name="hip_roll_assembly_2">
        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
        <inertial>
            <origin xyz="0.00079508052675062086158 -5.4654095489695737564e-06 -0.033060020136904864907" rpy="0 0 0"/>
            <mass value="0.06648000000000005294" />
            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
        </inertial>
    </link>
    <link name="right_roll_to_pitch_assembly">
        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
        <inertial>
            <origin xyz="-0.050804245559722800707 -0.00042074186984666911556 0.02047043747768734559" rpy="0 0 0"/>
            <mass value="0.075160000000000060094" />
            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
        </inertial>
    </link>
    <link name="knee_and_ankle_assembly_3">
        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
        <inertial>
            <origin xyz="0.0025336932086842409509 0.039063625582319495833 0.010808979048309722351" rpy="0 0 0"/>
            <mass value="0.12407000000000001361" />
            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
        </inertial>
    </link>
    <link name="knee_and_ankle_assembly_4">
        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
        <inertial>
            <origin xyz="5.0185935258263388972e-06 -0.057746501775911528165 0.018113576234400654424" rpy="0 0 0"/>
            <mass value="0.072590000000000057256" />
            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
        </inertial>
    </link>
    <link name="foot_assembly_2">
        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
        <inertial>
            <origin xyz="0.011071805405810940942 -0.02466082891405442859 0.019062631505101859664" rpy="0 0 0"/>
            <mass value="0.075240000000000001323" />
            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
        </inertial>
    </link>
    <link name="right_foot">
        <inertial>
            <origin xyz="0 0 0" rpy="0 0 0" />
            <mass value="1e-9" />
            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
        </inertial>
    </link>
    <joint name="right_foot_frame" type="fixed">
        <origin xyz="0.0005000000000002155498 -0.036224999999999840661 0.019550000000000664069" rpy="-1.570796326794896558 9.1691846176123393012e-16 1.3322725304659061714e-15" />
        <parent link="foot_assembly_2" />
        <child link="right_foot" />
        <axis xyz="0 0 0"/>
    </joint>
    <joint name="right_ankle" type="revolute">
        <origin xyz="-6.9388939039072283776e-18 -0.078650000000000039324 9.9999999999961231012e-05" rpy="-2.6413756984180028828e-16 -6.9382288127881716121e-25 -5.1722034616178551878e-17" />
        <parent link="knee_and_ankle_assembly_4" />
        <child link="foot_assembly_2" />
        <axis xyz="0 0 1"/>
        <limit effort="1" velocity="20" lower="-1.570796326794896558" upper="1.570796326794896558"/>
        <joint_properties friction="0.0"/>
    </joint>
    <joint name="right_knee" type="revolute">
        <origin xyz="-6.9388939039072283776e-18 0.078649999999999414824 0.036999999999999658162" rpy="3.141592653589793116 -2.0819102970830263503e-24 5.0289882707839502595e-30" />
        <parent link="knee_and_ankle_assembly_3" />
        <child link="knee_and_ankle_assembly_4" />
        <axis xyz="0 0 1"/>
        <limit effort="1" velocity="20" lower="-1.570796326794896558" upper="1.570796326794896558"/>
        <joint_properties friction="0.0"/>
    </joint>
    <joint name="right_hip_pitch" type="revolute">
        <origin xyz="-0.074149999999999799405 3.1868767607495795957e-16 0.035110000000000016196" rpy="-2.3836094894413110414e-24 1.570796326794896336 0" />
        <parent link="right_roll_to_pitch_assembly" />
        <child link="knee_and_ankle_assembly_3" />
        <axis xyz="0 0 1"/>
        <limit effort="1" velocity="20" lower="-0.52359877559829881566" upper="1.2217304763960306069"/>
        <joint_properties friction="0.0"/>
    </joint>
    <joint name="right_hip_roll" type="revolute">
        <origin xyz="0.019050000000008261714 3.78516662458139308e-14 -0.046015000000003032643" rpy="-1.5707963267947879782 -8.4491074221037422062e-14 1.5707963267945974639" />
        <parent link="hip_roll_assembly_2" />
        <child link="right_roll_to_pitch_assembly" />
        <axis xyz="0 0 1"/>
        <limit effort="1" velocity="20" lower="-0.43633231299858238339" upper="0.43633231299858238339"/>
        <joint_properties friction="0.0"/>
    </joint>
    <joint name="right_hip_yaw" type="revolute">
        <origin xyz="-0.018999999999998431338 -0.03500000000000151601 0.045940938812377415945" rpy="-4.6224992538811313716e-16 -2.2037927038832600325e-14 -1.6653345370219725828e-16" />
        <parent link="trunk_assembly" />
        <child link="hip_roll_assembly_2" />
        <axis xyz="0 0 1"/>
        <limit effort="1" velocity="20" lower="-0.52359877559829881566" upper="0.52359877559829881566"/>
        <joint_properties friction="0.0"/>
    </joint>
    <link name="neck_pitch_assembly">
        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
        <inertial>
            <origin xyz="-5.6313726543509343256e-06 0.049296760188245386525 0.018178555579869758868" rpy="0 0 0"/>
            <mass value="0.066180000000000058225" />
            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
        </inertial>
    </link>
    <link name="head_pitch_to_yaw">
        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
        <inertial>
            <origin xyz="-0.0076624665903661749386 0.026014958700652721091 0.018668069848403360395" rpy="0 0 0"/>
            <mass value="0.016937787992335997383" />
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
    </joint>
    <joint name="neck_pitch" type="revolute">
        <origin xyz="0.00099999999999896352354 0.019150000000000326483 0.090000938812376238274" rpy="1.570796326794896558 8.9928064994637667153e-14 6.1232449686014378908e-17" />
        <parent link="trunk_assembly" />
        <child link="neck_pitch_assembly" />
        <axis xyz="0 0 1"/>
        <limit effort="1" velocity="20" lower="-0.34906585039886589561" upper="1.1344640137963142301"/>
        <joint_properties friction="0.0"/>
    </joint>
</robot>
