nickthelegend/thenar-duck/cad/reference_open_duck/mini_bdx/robots/open_duck_mini_v2/robot.xml

<mujoco model="onshape">
  <compiler angle="radian"/>
  <asset>
    <mesh name="body_front" file="body_front.stl"/>
    <mesh name="usb_c_charger" file="usb_c_charger.stl"/>
    <mesh name="body_back" file="body_back.stl"/>
    <mesh name="body_middle_bottom" file="body_middle_bottom.stl"/>
    <mesh name="power_switch" file="power_switch.stl"/>
    <mesh name="bms" file="bms.stl"/>
    <mesh name="battery_pack_lid" file="battery_pack_lid.stl"/>
    <mesh name="body_middle_top" file="body_middle_top.stl"/>
    <mesh name="bno055" file="bno055.stl"/>
    <mesh name="roll_bearing" file="roll_bearing.stl"/>
    <mesh name="trunk_bottom" file="trunk_bottom.stl"/>
    <mesh name="trunk_top" file="trunk_top.stl"/>
    <mesh name="board" file="board.stl"/>
    <mesh name="cell" file="cell.stl"/>
    <mesh name="holder" file="holder.stl"/>
    <mesh name="wj-wk00-0123middlecase_56" file="wj-wk00-0123middlecase_56.stl"/>
    <mesh name="drive_palonier" file="drive_palonier.stl"/>
    <mesh name="wj-wk00-0124bottomcase_45" file="wj-wk00-0124bottomcase_45.stl"/>
    <mesh name="wj-wk00-0122topcabinetcase_95" file="wj-wk00-0122topcabinetcase_95.stl"/>
    <mesh name="passive_palonier" file="passive_palonier.stl"/>
    <mesh name="roll_motor_bottom" file="roll_motor_bottom.stl"/>
    <mesh name="roll_motor_top" file="roll_motor_top.stl"/>
    <mesh name="left_roll_to_pitch" file="left_roll_to_pitch.stl"/>
    <mesh name="left_cache" file="left_cache.stl"/>
    <mesh name="leg_spacer" file="leg_spacer.stl"/>
    <mesh name="left_knee_to_ankle_right_sheet" file="left_knee_to_ankle_right_sheet.stl"/>
    <mesh name="left_knee_to_ankle_left_sheet" file="left_knee_to_ankle_left_sheet.stl"/>
    <mesh name="foot_side" file="foot_side.stl"/>
    <mesh name="foot_bottom_tpu" file="foot_bottom_tpu.stl"/>
    <mesh name="foot_bottom_pla" file="foot_bottom_pla.stl"/>
    <mesh name="foot_top" file="foot_top.stl"/>
    <mesh name="right_roll_to_pitch" file="right_roll_to_pitch.stl"/>
    <mesh name="right_cache" file="right_cache.stl"/>
    <mesh name="neck_left_sheet" file="neck_left_sheet.stl"/>
    <mesh name="neck_right_sheet" file="neck_right_sheet.stl"/>
    <mesh name="head_pitch_to_yaw" file="head_pitch_to_yaw.stl"/>
    <mesh name="head_yaw_to_roll" file="head_yaw_to_roll.stl"/>
    <mesh name="head_bot_sheet" file="head_bot_sheet.stl"/>
    <mesh name="head" file="head.stl"/>
    <mesh name="head_roll_mount" file="head_roll_mount.stl"/>
    <mesh name="raspberrypizerow" file="raspberrypizerow.stl"/>
    <mesh name="sg90" file="sg90.stl"/>
    <mesh name="antenna" file="antenna.stl"/>
    <mesh name="left_antenna_holder" file="left_antenna_holder.stl"/>
    <mesh name="right_antenna_holder" file="right_antenna_holder.stl"/>
  </asset>
  <default>
    <geom contype="1" conaffinity="1"/>
    <!-- <joint damping="1.44" frictionloss="0.19" armature="0.012"/>
    <position kp="19.6" kv="0.0" forcerange="-3.69 3.69"/> -->
    <joint damping="1.0" frictionloss="0.01" armature="0.01"/>
    <position kp="9.5" kv="0.0" forcerange="-5.2 5.2"/>
  </default>
  <contact>
    <exclude name="exclude1" body1="trunk_assembly" body2="neck_yaw_assembly"/>
    <exclude name="exclude2" body1="trunk_assembly" body2="hip_roll_assembly"/>
    <exclude name="exclude3" body1="trunk_assembly" body2="hip_roll_assembly_2"/>
    <exclude name="exclude4" body1="hip_roll_assembly" body2="left_roll_to_pitch_assembly"/>
    <exclude name="exclude5" body1="hip_roll_assembly_2" body2="right_roll_to_pitch_assembly"/>
    <exclude name="exclude6" body1="trunk_assembly" body2="left_roll_to_pitch_assembly"/>
    <exclude name="exclude7" body1="trunk_assembly" body2="right_roll_to_pitch_assembly"/>
    <exclude name="exclude8" body1="neck_yaw_assembly" body2="head_pitch_to_yaw"/>
    <exclude name="exclude9" body1="neck_yaw_assembly" body2="head_assembly"/>
    <exclude name="exclude10" body1="head_pitch_to_yaw" body2="head_assembly"/>
  </contact>
  <worldbody>
    <!-- <body name="base" pos="0 0 0.22"> -->
    <body name="base" pos="0 0 0.4">
      <!-- <freejoint /> -->
      <body name="trunk_assembly">
        <inertial pos="-0.0483259 -9.97823e-05 0.0384971" quat="0.505499 0.490695 0.496207 0.507413" mass="0.698526" diaginertia="0.00344489 0.00292719 0.00167606"/>
        <geom pos="-0.019 0 0.0648909" type="mesh" rgba="0.917647 0.917647 0.917647 1" mesh="body_front"/>
        <geom pos="-0.1263 -0.0257 0.0576079" quat="0.5 0.5 -0.5 0.5" type="mesh" rgba="0.615686 0.811765 0.929412 1" mesh="usb_c_charger"/>
        <geom pos="-0.019 0 0.0648909" type="mesh" rgba="0.917647 0.917647 0.917647 1" mesh="body_back"/>
        <geom pos="-0.019 0 0.0648909" type="mesh" rgba="0.917647 0.917647 0.917647 1" mesh="body_middle_bottom"/>
        <geom pos="-0.12034 0 0.0899126" quat="0.901303 0 -0.433189 0" type="mesh" rgba="0.901961 0.901961 0.901961 1" mesh="power_switch"/>
        <geom pos="-0.0752028 -0.0249 0.0294899" quat="0.5 0.5 0.5 -0.5" type="mesh" rgba="0.231373 0.380392 0.705882 1" mesh="bms"/>
        <geom pos="-0.019 0 0.0648909" type="mesh" rgba="0.231373 0.380392 0.705882 1" mesh="battery_pack_lid"/>
        <geom pos="-0.019 0 0.0648909" type="mesh" rgba="0.917647 0.917647 0.917647 1" mesh="body_middle_top"/>
        <geom pos="-0.08711 0 0.0417909" type="mesh" rgba="0.615686 0.811765 0.929412 1" mesh="bno055"/>
        <geom pos="-0.019 0 0.0648909" type="mesh" rgba="0.6 0.6 0.6 1" mesh="roll_bearing"/>
        <geom pos="-0.019 0 0.0648909" type="mesh" rgba="0.180392 0.180392 0.180392 1" mesh="trunk_bottom"/>
        <geom pos="-0.019 0 0.0648909" type="mesh" rgba="0.180392 0.180392 0.180392 1" mesh="trunk_top"/>
        <geom pos="-0.06349 0.0165 0.0603909" quat="0 0 0 -1" type="mesh" rgba="0 0.501961 0 1" mesh="board"/>
        <geom pos="-0.019 -0.07 0.0648909" type="mesh" rgba="0.6 0.6 0.6 1" mesh="roll_bearing"/>
        <geom pos="-0.129625 -0.0105 0.0650134" quat="0 -0.457466 -0.889227 0" type="mesh" rgba="0.615686 0.811765 0.929412 1" mesh="cell"/>
        <geom pos="-0.139625 -0.0635245 0.031455" quat="0.707107 0 0.707107 0" type="mesh" rgba="0.647059 0.647059 0.647059 1" mesh="holder"/>
        <geom pos="-0.129625 0.0105 1.34322e-05" quat="0.930459 0 0 0.366396" type="mesh" rgba="0.615686 0.811765 0.929412 1" mesh="cell"/>
        <geom pos="0.001 0.0097 0.0645009" quat="0.707107 0 0.707107 0" type="mesh" rgba="0.247059 0.243137 0.243137 1" mesh="wj-wk00-0123middlecase_56"/>
        <geom pos="0.001 0.0097 0.0645009" quat="0.707107 0 0.707107 0" type="mesh" rgba="0.623529 0.666667 0.701961 1" mesh="drive_palonier"/>
        <geom pos="0.001 0.0097 0.0645009" quat="0.707107 0 0.707107 0" type="mesh" rgba="0.247059 0.243137 0.243137 1" mesh="wj-wk00-0124bottomcase_45"/>
        <geom pos="0.001 0.0097 0.0645009" quat="0.707107 0 0.707107 0" type="mesh" rgba="0.247059 0.243137 0.243137 1" mesh="wj-wk00-0122topcabinetcase_95"/>
        <geom pos="0.001 0.0126 0.0645009" quat="0.707107 0 0.707107 0" type="mesh" rgba="0.623529 0.666667 0.701961 1" mesh="passive_palonier"/>
        <geom pos="-0.0445 -0.035 0.0553909" quat="0 0 -0.707107 0.707107" type="mesh" rgba="0.247059 0.243137 0.243137 1" mesh="wj-wk00-0123middlecase_56"/>
        <geom pos="-0.0445 -0.035 0.0553909" quat="0 0 -0.707107 0.707107" type="mesh" rgba="0.623529 0.666667 0.701961 1" mesh="drive_palonier"/>
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
              <geom pos="0.01606 -0.065 0.1092" quat="0.707107 0.707107 0 0" type="mesh" rgba="0.917647 0.917647 0.917647 1" mesh="right_cache"/>
              <geom pos="0.01606 -0.14365 -0.07215" quat="0.707107 0.707107 0 0" type="mesh" rgba="0.647059 0.647059 0.647059 1" mesh="leg_spacer"/>
              <geom pos="0.01606 -0.14365 -0.07205" quat="0.707107 0.707107 0 0" type="mesh" rgba="0.223529 0.219608 0.219608 1" mesh="left_knee_to_ankle_right_sheet"/>
              <geom pos="0.01606 -0.14365 -0.07205" quat="0.707107 0.707107 0 0" type="mesh" rgba="0.223529 0.219608 0.219608 1" mesh="left_knee_to_ankle_left_sheet"/>
              <geom pos="0 0.05315 0.02755" quat="0.5 0.5 -0.5 -0.5" type="mesh" rgba="0.247059 0.243137 0.243137 1" mesh="wj-wk00-0123middlecase_56"/>
              <geom pos="0 0.05315 0.02755" quat="0.5 0.5 -0.5 -0.5" type="mesh" rgba="0.623529 0.666667 0.701961 1" mesh="drive_palonier"/>
              <geom pos="0 0.05315 0.02755" quat="0.5 0.5 -0.5 -0.5" type="mesh" rgba="0.247059 0.243137 0.243137 1" mesh="wj-wk00-0124bottomcase_45"/>
              <geom pos="0 0.05315 0.02755" quat="0.5 0.5 -0.5 -0.5" type="mesh" rgba="0.247059 0.243137 0.243137 1" mesh="wj-wk00-0122topcabinetcase_95"/>
              <geom pos="0 0.05315 0.03045" quat="0.5 0.5 -0.5 -0.5" type="mesh" rgba="0.623529 0.666667 0.701961 1" mesh="passive_palonier"/>
              <body name="knee_and_ankle_assembly_4" pos="0 0.07865 0.037" quat="0 1 0 0">
                <inertial pos="5.01859e-06 -0.0577465 0.0181136" quat="0.708422 0.705789 1.07934e-05 0.00022447" mass="0.07259" diaginertia="4.99575e-05 4.23935e-05 1.8727e-05"/>
                <joint name="right_knee" pos="0 0 0" axis="0 0 1" range="-1.5708 1.5708" />
                <geom pos="0.01606 0.14365 0.10925" quat="0.707107 -0.707107 0 0" type="mesh" rgba="0.647059 0.647059 0.647059 1" mesh="leg_spacer"/>
                <geom pos="0.01606 0.14365 0.10915" quat="0.707107 -0.707107 0 0" type="mesh" rgba="0.223529 0.219608 0.219608 1" mesh="left_knee_to_ankle_right_sheet"/>
                <geom pos="0.01606 0.14365 0.10915" quat="0.707107 -0.707107 0 0" type="mesh" rgba="0.223529 0.219608 0.219608 1" mesh="left_knee_to_ankle_left_sheet"/>
                <geom pos="0 -0.05315 0.00955" quat="0.5 -0.5 -0.5 0.5" type="mesh" rgba="0.247059 0.243137 0.243137 1" mesh="wj-wk00-0123middlecase_56"/>
                <geom pos="0 -0.05315 0.00955" quat="0.5 -0.5 -0.5 0.5" type="mesh" rgba="0.623529 0.666667 0.701961 1" mesh="drive_palonier"/>
                <geom pos="0 -0.05315 0.00955" quat="0.5 -0.5 -0.5 0.5" type="mesh" rgba="0.247059 0.243137 0.243137 1" mesh="wj-wk00-0124bottomcase_45"/>
                <geom pos="0 -0.05315 0.00955" quat="0.5 -0.5 -0.5 0.5" type="mesh" rgba="0.247059 0.243137 0.243137 1" mesh="wj-wk00-0122topcabinetcase_95"/>
                <geom pos="0 -0.05315 0.00665" quat="0.5 -0.5 -0.5 0.5" type="mesh" rgba="0.623529 0.666667 0.701961 1" mesh="passive_palonier"/>
                <body name="foot_assembly_2" pos="0 -0.07865 0.0001">
                  <inertial pos="0.0110718 -0.0246608 0.0190626" quat="0.506106 0.51004 0.489653 0.49392" mass="0.07524" diaginertia="6.74949e-05 6.06095e-05 1.86965e-05"/>
                  <joint name="right_ankle" pos="0 0 0" axis="0 0 1" range="-1.5708 1.5708" />
                  <geom pos="0.01606 0.2223 0.10905" quat="0.707107 -0.707107 0 0" type="mesh" rgba="0.980392 0.713726 0.00392157 1" mesh="foot_side"/>
                  <geom pos="0.01656 0.2228 0.10955" quat="0.707107 -0.707107 0 0" type="mesh" rgba="0.305882 0.298039 0.278431 1" mesh="foot_bottom_tpu"/>
                  <geom pos="0.01656 0.2228 0.10955" quat="0.707107 -0.707107 0 0" type="mesh" rgba="0.305882 0.298039 0.278431 1" mesh="foot_bottom_pla"/>
                  <geom pos="0.01606 0.2223 0.10905" quat="0.707107 -0.707107 0 0" type="mesh" rgba="0.980392 0.713726 0.00392157 1" mesh="foot_top"/>
                  <body name="right_foot" pos="0.0005 -0.036225 0.01955" quat="0.707107 -0.707107 0 0">
                    <inertial pos="0 0 0" mass="1e-09" diaginertia="0 0 0"/>
                  </body>
                </body>
              </body>
            </body>
          </body>
        </body>
      </body>
    </body>
  </worldbody>
  <actuator>
    <position name="left_hip_yaw" joint="left_hip_yaw" inheritrange="1"/>
    <position name="left_hip_roll" joint="left_hip_roll" inheritrange="1"/>
    <position name="left_hip_pitch" joint="left_hip_pitch" inheritrange="1"/>
    <position name="left_knee" joint="left_knee" inheritrange="1"/>
    <position name="left_ankle" joint="left_ankle" inheritrange="1"/>
    <position name="neck_pitch" joint="neck_pitch" inheritrange="1"/>
    <position name="head_pitch" joint="head_pitch" inheritrange="1"/>
    <position name="head_yaw" joint="head_yaw" inheritrange="1"/>
    <position name="head_roll" joint="head_roll" inheritrange="1"/>
    <position name="left_antenna" joint="left_antenna" inheritrange="1"/>
    <position name="right_antenna" joint="right_antenna" inheritrange="1"/>
    <position name="right_hip_yaw" joint="right_hip_yaw" inheritrange="1"/>
    <position name="right_hip_roll" joint="right_hip_roll" inheritrange="1"/>
    <position name="right_hip_pitch" joint="right_hip_pitch" inheritrange="1"/>
    <position name="right_knee" joint="right_knee" inheritrange="1"/>
    <position name="right_ankle" joint="right_ankle" inheritrange="1"/>
  </actuator>
</mujoco>
